Cheerssom/LingTouchCompanion/hardware/models/3mf/Handle_TwistKey_2026-10-27/README.md

# 拧扣榫测试块（2026-10-27）

> **10/28 新增：扣的咔哒测试** → [Key_Detent_Test.3mf](Key_Detent_Test.3mf)，说明见文末“扣的咔哒测试”。

按前榫的真实尺寸做的一小块，用来先试手感，还不是手柄。

## 怎么锁

- 榫：还是现在那种沙漏截面（宽 4.45、腰 2.85、高 7.0），横着插在托盘和盖子各挖一半的槽里。
- 槽只从一侧开口，另一头在壳里封死，所以榫只能从开口那侧插进去，插到底就停住。
- 扣：一片扁的小件。把它竖着从开口插进去，用指甲或硬币边拧 90°。拧完以后扣里面那一横卡在口的后面，往外拔不出来；扣的里面顶着榫，榫也退不出来。
- 拆：把扣拧回竖着，扣就能拿出来；手柄一歪，榫就从开口滑出来。

示意见 [tenon_test_preview.png](tenon_test_preview.png)。

## 打印件

[Tenon_Test.3mf](Tenon_Test.3mf) 里一共 6 件，已经按打印姿态摆好：

| 件 | 姿态 |
|---|---|
| 托盘块 | 底面贴床 |
| 前盖块 | 顶面贴床 |
| 榫（间隙 0.2） | 宽平面贴床 |
| 榫（间隙 0.1） | 宽平面贴床 |
| 扣 ×2 | 平放，其中一个是备用 |

按拓竹默认 30° 规则做了几何检查：6 件都没有需要支撑的朝下面。这里没有拓竹，没真切过。

## 要试的

1. 扣插进去、拧 90°、再拧回来拿出来，顺不顺。
2. 锁住以后歪、甩、推榫两头，榫和扣会不会出来。
3. 两根榫哪根手感好。间隙 0.2 那根，盖子能往上晃大约 0.9 mm；0.1 那根大约 0.45 mm。晃动大小跟会不会滑出来已经没关系，可以只按手感挑。

## 已知限制

- 扣很小：8.4 × 4.1 × 2.4 mm。拧的那一条比侧面低 0.8 mm，免得手指蹭到把它带着转。
- 测试块沿杖方向做了 12 mm 宽，真手柄前榫那块只有 7.65 mm，而扣转动要占 7.5 mm。装进真手柄前面那块会很挤，需要让出 1–2 mm，具体怎么让，等试完再定。
- 没有实打；锁住以后长期敲地扣会不会自己慢慢转开，要实测。

## 检查

`python -B tenon_test.py` 会重新生成 3MF，并把检查结果写进 [tenon_test_check.json](tenon_test_check.json)。检查内容：

- 装配后各件不重叠；
- 榫能从开口一路插到底；
- 扣竖着能插进去，在里面能转满 90°；
- 锁住后扣往外拔会撞到口、榫往外退会撞到扣、榫往里推会撞到封死的那头；
- 盖子往上抬会被榫卡住。

## 扣的咔哒测试（2026-10-28）

10/27 测试块打出来：0.1 那根榫挺紧、能用；扣有点晃，而且一碰就转。这次只解决“一碰就转”。

- 扣：外面那一条两头底下各加一道小凸棱；里面一横和外面一条之间刚好夹住口（多留 0.05），前后不再窜；里面一横加厚到 1.5。
- 托盘块、盖子块：圆坑底开 4 个浅槽（深 0.20），在“锁住”和“竖着”两个位置。壳上只挖槽，不加凸起。
- 拧的时候凸棱压在坑底，扣外面那条两头被顶起一点，转到下一个位置落进槽里，咔一下停住。

示意见 [key_detent_preview.png](key_detent_preview.png)。

[Key_Detent_Test.3mf](Key_Detent_Test.3mf) 4 件，已按打印姿态摆好：

| 件 | 姿态 |
|---|---|
| 托盘块（带浅槽） | 底面贴床 |
| 前盖块（带浅槽） | 顶面贴床 |
| 扣，凸棱高 0.10 | 平放 |
| 扣，凸棱高 0.15 | 平放 |

榫用 10/27 已经打好的间隙 0.1 那根，不用重打。

要试的：两个扣各拧几次，锁住位置有没有咔一下停住、拧起来费不费劲、凸棱会不会磨平或者扣会不会裂。

检查（`python -B key_detent_test.py` 重新生成，结果在 [key_detent_check.json](key_detent_check.json)）：

- 扣在锁住和竖着两个位置都不碰壳和榫；竖着能插进去；去掉凸棱算，扣能转满 90°；
- 从 5° 到 85°，凸棱要把扣两头顶起 0.10 / 0.15，0° 和 90° 落回去；
- 锁住后扣拔不出来、榫退不出来；
- 按 30° 规则，4 件都没有需要支撑的朝下面（拓竹没真切过）。

估算，不是实测：把扣外面那条当悬臂粗算，顶起时变形约 2%（0.10）和 3%（0.15），按 PLA 估。0.1 mm 这个量级跟打印误差差不多，手感只能打出来试。
