Cheerssom/LingTouchCompanion/docs/REPORT_2026-10-28.md

# 报告：仓库按人重构 + 端侧工程骨架（2026-10-28）

分支 `claude/trusting-brown-h7384r`，基于交接提交 `567b1be`。依据 [HANDOFF_2026-10-28.md](plans/HANDOFF_2026-10-28.md) 和 Hsinlung 对开工前分析的答复。下文把**实测/运行结果**、**计算**、**推断**分开写；“通过”只指真的跑过。

## 1. 提交列表

| 提交 | 内容 |
|---|---|
| `d9cdf4e` | 按人重构，只做 `git mv`：316 个文件全部是 100% 相同内容的重命名 |
| `446386c` | 只修引用：README 相对链接（含 archive 里的）、Python 定位仓库根（`LINGTOUCH_ROOT` 优先，否则向上找 `.git`）、`archive/vision` 的数据目录、`.gitignore` 新旧路径都保留 |
| `3b88ac0` | 交接文档更正：鸿蒙等时传输要求 API 18 / 5.1.0(18)，不是 16 |
| `4c9b306` | 本机迁移 PowerShell 脚本 `docs/migrate_local_2026-10-28.ps1` |
| `43ad9ec` | C++17 核心骨架（core、perception/native、agent/native）与主机测试 |
| `2146edb` | 安卓外壳进行中（停下来换模型时为防容器回收先提交）：libusb、libusb 取流、JNI、Kotlin 主体 |
| `2356e43` | 安卓外壳收尾：Gradle、Manifest、资源、README；修正一个空值判断 bug |
| `1faf0ac` | 鸿蒙外壳：ArkTS、Node-API、usbSubmitTransfer 与备选 fd+libusb、BLE、长时任务 |
| `4386a91` | 真机验收支持：栅格摘要、保存当前帧、核对帧文件 |
| `c466c7b` | 文档：README、CLAUDE.md、真机验收清单、各文件夹 README |
| （本提交） | 本报告 |

## 2. 任务 A：按人重构

布局按交接的表执行，几处解释（开工前已说明、Hsinlung 同意）：

- `hardware/models/` 下保留 `3mf/`、`BrailleModule/`、`BrailleModule_Video/` 三个同级目录，内容一个字节没改。理由：`BrailleModule_Video/ArrayPreview` 用 `../../3mf/…` 和 `parents[1]/'3mf'` 引用 3mf，`3mf/README.md` 要求“Keep this folder together”。因此 `hardware/models/` 就相当于原来的仓库根：各模型 README 里的命令在这里执行照旧有效。
- PCB 放在 `hardware/pcb/PCB_REDESIGN_2026-10-08/`，保留带日期的目录名，新板以后可以并列。
- 旧 CLAUDE.md 归档为 `archive/CLAUDE_2026-10-09.md`：Claude Code 会自动加载子目录里的 CLAUDE.md，保留原名会让过期的 10/09 指令在 archive/ 里继续生效。
- 历史记录正文里的旧路径不改：交接本身（只按要求改了 API 版本）、`pcb_v2_revision.md`、3mf 内部文档、`archive/CLAUDE_2026-10-09.md`。
- 3mf 里有两类问题是移动前就有的，原样保留：断链（`../../Handle/Coaxial_v1/README.md`、`build.py:255` 这类带行号的链接），以及 `PCB_PREPOWER_REVIEW_2026-10-07.md` 里指向 `C:/Users/Hsinlung/Desktop/LingTouchCompanion/firmware/…` 的绝对路径。合并后这个绝对路径会指向旧位置。

**本机被忽略的文件不会跟着合并移动。** 例如 `3mf/.runtime/`、`geometry/checks/views`、`BrailleModule_Video/Archives/`、`app/backend/.env` 与 `node_modules/`、实验服务的证书、`data/` 等。处理分两部分：
- 迁移脚本按移动表逐项挪：只移动，缺的跳过，不删除，不覆盖，每一步都打印，支持 `-DryRun`。
- `.pcba-workflow/` 留在仓库根，脚本在 `hardware/models/` 下用 `mklink /J` 建目录联接。原因是 `Handle_NewPCB_2026-10-20` 的 `build.py`、`measure_sources.py` 用 `parents[1]` 找它，而 3mf 里的代码不能改。

`.gitignore` 同时保留旧路径，免得残留的运行时显示为未跟踪而被误提交。

## 3. 任务 B：端侧骨架

### 3.1 core/（大家共用）

- `types.h`：深度帧（帧号、单调时钟时间戳、内参版本）、9×6 栅格（0/1/2，每格诊断：高度带点数、地面点数、看到地面的 10 cm 小块数）、地面估计、各阶段像素数。行号约定与 `frame_converter.py` 一致：row 0 最远。
- `modules.h`：按视觉方案第 9 节命名的接口：SensorAdapter、Registration、GroundPose、GeometryGrid、RGBInstance、SpatialLMService、EvidenceFusion、OutputAdapter / TactileEncoder。`inference.h`：InferenceBackend（鸿蒙 MindSpore Lite、安卓 ONNX Runtime）和 LanguageModel（llama.cpp）。未实现的只有接口，没有假实现。
- `tactile.h`：旧板编码。9×6 放进 10×9 的最近 6 行，其余 4 行全平。
  - 状态 2 用 `UnknownCellPolicy` 显式传入，没有默认值；数值 0 非法，防止零初始化时悄悄选中一种。
  - 左右镜像、ROT180 都是显式参数，默认沿用现有行为（都为 true）。
- `config/lingtouch_defaults.conf`：全部门槛的唯一来源，编译时原样嵌入，两个平台共用。`tactile.unknown_cell_policy` 留空，注明“待 Hsinlung 定”。
- `engine.h`：给外壳的门面，包括启动表、IN 响应、按批收包、后台线程算栅格（只保留最新一帧）、编码、存帧和核对帧文件。没有帧或没有内参时拒绝编码。
- `report_json.h`：两端共用的栅格/统计 JSON 和栅格摘要。

### 3.2 perception/native/（视觉同学）

- **启动表**：由 `tools/gen_startup_sequence.py` 从 `startup_sequence.json` 生成，不手抄。共 41 条控制请求、2 次切换接口、1 次挂等时传输。0xa700 之后的 270 ms 等待不在 JSON 里，由脚本按 REPORT 第 9 步加上。
- **执行顺序**：JSON 的第 0 步（GET_CUR 0xcb00）排在“接口 0 设 alt 0”之前。执行时先 claim 接口 0，再严格按表走。
- **拆帧器**：与 `independent_proof.py` 的 `packet()/finish()` 逻辑一致，处理 UVC 头、FID 翻转、EOF、ERR、空包、超长。
- **标定解码**：无 schema。字段含义和依据见 §6。
- **几何**：
  - 去畸变查表；
  - 依次过滤：无效值（0、恰为 1、<100 mm、>5 m、超出畸变可逆范围）→ 疑似相位绕回的孤立近点 → 边缘飞点（默认偏松）；
  - 反投影：光轴 Z / 径向可切换（`depth.meaning`），去畸变可开关（`depth.undistort`），深度图镜像可开关（`depth.image_mirrored`）；
  - 地面拟合：RANSAC + 最小二乘（Jacobi）。质量检查包括内点数、前向铺开长度，以及“低于平面的点占比”（防止把桌面当地面），失败时整张为 2；
  - 0/1/2：先按 10 cm 小块取整再推出格子；1 优先于 0；0 要求 16 个小块都有地面点且高度带内无点（缺几块、带内允许几个点都是参数）。
- **平面检查**：中央区域对四种假设（Z/径向 × 去/不去畸变）各做最小二乘平面，比较残差。
- **确定性**：两个平台要对同一帧算出相同结果，所以 `-ffp-contract=off`、不用 fast-math，判决只用加减乘除和 sqrt，随机数用自带的 SplitMix64。
- **cs30_libusb**（安卓用，可选目标）：
  - 用 `LIBUSB_OPTION_NO_DEVICE_DISCOVERY` + `libusb_wrap_sys_device` 包住 fd，claim 时自动 detach 内核驱动；
  - 挂 10 个传输，每个 32 个微帧 × 3072 字节，超时 5000 ms；控制请求超时 15 s；
  - 停流顺序：取消并排空（每轮重新取消）→ 接口 1 设 alt 0 → 接口 0 设 alt 0 → release；
  - 停流时若还有传输没回来，不释放缓冲，并拒绝重开；另有 `reset_device()`。
- **third_party/libusb**：上游 1.0.29（LGPL-2.1）Linux/Android 后端原样摘取，压缩包 SHA-256 记在 `README.lingtouch.md`。编成独立的 `libusb-1.0.so`，不静态链接。

### 3.3 agent/native/（对话 agent 同学）

只有接口：语音识别/合成（计划用 sherpa-onnx）和 agent。语言模型接口放在 core，因为 SpatialLM 和 agent 共用。

### 3.4 apps/android/（交互同学）

Kotlin，不依赖 AndroidX。AGP 8.7.3 / Kotlin 2.0.21 / Gradle 8.11.1，minSdk 29、targetSdk 35，只编 arm64-v8a。

- MainActivity 的流程：申请 CAMERA（安卓 9 起 UVC 授权需要）→ USB 授权（PendingIntent 显式包名 + FLAG_MUTABLE，接收器 NOT_EXPORTED）→ 后台线程开流 → 每 200 ms 刷新。
- 栅格每行有读屏文字。没连设备显示“未连接”，帧率只用实测帧数算。状态 2 不预选、必须手选。
- 另有：持续发送、平面检查、存帧/核对帧文件、复位相机。
- StreamService 是 connectedDevice 前台服务，开流期间持有 `PARTIAL_WAKE_LOCK`。HandleLink 的 BLE 流程与比赛版相同，FFE3 订阅成功后才允许写帧。

### 3.5 apps/harmony/（交互同学）

ArkTS Stage 模型，`compatibleSdkVersion = targetSdkVersion = 5.1.0(18)`。

- **主路径**：usbManager 执行启动表，接口 1 切到 alt 1 后立刻挂 10 个 `usbSubmitTransfer`。每个回调把 32 个微帧打成一批，调一次 `pushIsoTransfer`，不是每包一次跨层调用。
- **备选路径**：`getFileDescriptor` → `openFd` → native libusb。CMake 开关 `LINGTOUCH_HARMONY_LIBUSB` 可以关掉。
- **BLE**：取自比赛版，改成回调对象，并且不跳过相同帧（后台持续发送测试要看到每次刷新）。
- **后台保活**：长时任务 bluetoothInteraction + location，module.json5 里已声明。
- 界面功能与安卓相同。

## 4. 跑过的测试与结果（云端，全部是主机上的运行结果）

| 项目 | 结果 |
|---|---|
| Python `py_compile`（仓库里全部 73 个 .py，含新增的生成脚本和比对脚本） | 通过 |
| `--help`：phone_server、alert_server、depth_server、evaluate_obstacle_scenes、topdown_pipeline、archive/vision/main | 通过（装了 CPU 可用的 torch 等依赖，在临时虚拟环境里） |
| `frame_converter.py` 自检 | 通过 |
| validate_distance / check_balloon_depth / prep_new_pics | **未运行**（需要本机 `pics/`）。在 `/tmp` 下启动时报错路径为 `<仓库根>/pics/…`，说明已按仓库根解析、不依赖当前目录 |
| Node 后端（`agent/backend` 的临时副本） | `npm ci` 后启动，`GET /` 和 `POST /api/assistant/parse-command` 正常。注意：`package-lock.json` 的 resolved 地址是 `registry.npmmirror.com`，云端要加 `--registry=https://registry.npmjs.org/ --replace-registry-host=always`（未改仓库） |
| 核心主机测试（gcc 13，RelWithDebInfo） | 11/11 通过 |
| 同上，clang 18 加 `-Wshadow -Wconversion` | 11/11 通过，零警告（修掉了测试里一个未用常量） |
| 同上，ASan + UBSan | 11/11 通过 |
| `test_engine` 在 TSan 下连跑 3 次 | 通过，无数据竞争报告 |
| 安卓 native（主机编译器 + JDK 的 `jni.h`） | `liblingtouch_jni.so`（17 个 JNI 导出）与 `libusb-1.0.so` 编译、链接通过。JNI 库动态依赖 libusb，内部不含 libusb 符号 |
| 安卓 Kotlin | 在临时 JVM 工程里以 Robolectric `android-all:14`（API 34 框架类）为编译依赖，全部 `.kt` 编译通过、零警告。这一步抓到并修了一个 bug：发送成功会被误报为“服务还没启动” |
| 安卓 Gradle | `gradle help` 停在解析 AGP：`google()` 仓库 dl.google.com 在云端不可达。**未编 APK** |
| 鸿蒙 NAPI 胶水 | 以 Node-API 头文件做语法检查（开、关 libusb 两种）通过；编成 Node 插件后 `apps/harmony/tools/napi_host_test.js` 通过 |
| 鸿蒙 ArkTS | **未编译**（云端没有鸿蒙 SDK / ArkTS 编译器） |
| PowerShell 迁移脚本 | **未运行**（云端没有 PowerShell，下载 pwsh 可执行文件被会话权限拒绝），只做了人工检查（含 PowerShell 5.1 兼容、避免中文弯引号被当成字符串定界符） |
| 建模脚本（`3mf/regenerate.py` 等） | **未运行**（依赖本机运行时），只做了 py_compile |

各主机测试的具体内容：
- `test_tactile_legacy`：与 `frame_converter.py` 生成的 1408 条向量逐字节对比，不一致 0 条。584 条是纯打包（ROT180 与 PROD），824 条是“9×6→旧板→镜像→打包”全链路（平/凸 × 镜像开关 × ROT180 开关）。另有：显式策略、远处 4 行全平。另一项测试 `legacy_vectors_up_to_date` 每次重新生成向量，检查与已提交的一致。
- `test_config`：默认参数覆盖所有键；输出再读回一致；未知键、缺键、重复键、格式错误、逗号小数都报错。
- `test_uvc_assembler`：合成包流覆盖 EOF、无 EOF 靠 FID 翻转结束、帧中 ERR、只有头的包、开流空图、坏头三种、丢一个包、多一个包（超长）、按 32 槽位打包的传输（含空微帧、状态非 0、描述越界）。
- `test_cs30_protocol`：启动表与 REPORT 逐项一致（Commit 数据等于 Probe 返回的 26 字节、帧大小字段 614400、0xa100 的 640/480/02、alt 1 后立刻挂传输、0xa300 = 37 01）；标定分片倒序喂入也能拼回 763 字节原样；坏分片报错。
- `test_calibration`、`test_depth_geometry`：见 §6。
- `test_geometry_synthetic`：用 CS30 解出的内参（含真实畸变）渲染合成场景。
  - 地面 + 0.3×0.3×0.5 m 箱子（相机高 1.5 m、俯仰 30°），按光轴 Z 和径向各渲染一遍：箱子格 = 1，身后被挡 = 2，看全地板 = 0；拟合出的离地高度 1.500 m、俯仰 30.00°。
  - 高 1.7 m、俯仰 40°、横滚 6°：高度 1.700、俯仰 40.00、|横滚| 6.00。
  - 直径 3 cm 的细杆在默认参数下 = 1。
  - 5 cm 扁盒和悬在 2.0–2.2 m 的板都不判 1。
  - 看不到地面时降级，整张为 2。
  - 平面检查见 §6。
- `test_reference_frames`：3 张真实参考帧输出确定（新建流水线、复用流水线、倒序处理都一致）。三帧都是地面拟合失败、整张 2：000 帧地面内点 325 个，少于 500；020、040 帧没有符合条件的平面。这是近场数据，预期如此。
- `test_engine`：合成等时包流 → 后台算出的栅格与直接计算一致；拆帧逐字节还原；存帧、核对帧文件的摘要一致；第二帧 FID 翻转后共 2 帧，没有不完整帧。主机上一帧计算 6–12 ms（x86，不代表手机）。

## 5. 没有验证的（按要紧程度）

1. 所有真机项目，见 [device_tests.md](device_tests.md)。包括：
   - 两个平台能否从 CS30 收到帧；
   - 鸿蒙 `usbSubmitTransfer` 的实际行为（buffer 是否装数据、`isoPacketDescs` 是否齐全、`SHORT_NOT_OK` 对等时短包的影响、alt 设置的接口描述）；
   - 备选 fd + libusb 路径在鸿蒙上能否用；
   - 帧率与丢包；
   - 息屏 10 分钟；
   - 手柄手摸方向；
   - 两边摘要是否一致（主机上同一平台确定，ARM 上两个工具链之间还没比过）。
2. 安卓 APK 没编（AGP 解析不了），资源合并、Manifest 合并、NDK 交叉编译都没跑过；鸿蒙工程完全没编，ArkTS 只按语法规范人工检查。第一次本地编译很可能要修一些小问题。
3. libusb 的 Linux 后端在鸿蒙 NDK（musl）下能否编过，没试。
4. 深度含义（Z/径向）、片上是否已去畸变、深度图是否镜像：**未确认**，都做成了参数。
5. 门槛取值（地面内点 500、内点距离 3 cm、障碍点 5 个等）都是初版，没有真实地面数据检验过。参考帧是近场数据，提供不了这类证据。
6. 手机上的计算耗时、内存（每帧约 15 MB 工作内存）没测。
7. 迁移脚本没运行过。

## 6. 标定与深度含义（实测、计算、推断分开）

- **实测（读文件）**：两份 blob 都是 763 字节，只差 5 个字节，全在字段 1 的 4 个 float 里。blob 0 字段 1 = 364.875 / 364.778 / 324.416 / 231.051；blob 1 正好是一半（浮点指数减一）。字段 2 = −0.316446、0.140359、−0.000302、−0.000482、−0.034901。字段 11 = `HV0130315L0294`。
- **推断**：字段 1 是 640×480 的深度内参 fx fy cx cy，字段 2 是 OpenCV 顺序的 k1 k2 p1 p2 k3；blob 1 对应 320×240；字段 15–17 像是 RGB 内参与畸变（931.03 / 930.71 / 976.96 / 554.82…）、RGB←深度的旋转（接近单位阵）和平移（约 −43.9，推断单位毫米）。代码里内参版本号带 `:inferred`。
- **计算**：按上述含义，横向视场约 100.2°，与规格书的约 100° 一致；纵向约 75.0°。径向畸变函数在未畸变半径约 1.40 处到顶，所以图像四角约 6.58% 的像素超出可逆范围。查表把这些像素标为无效，查表回投最大误差 1.1e−5 像素。
- **交接里“解不出就用规格书视场推临时内参”这一条没有实现。** 解码成功，用不上；而且这颗镜头桶形畸变很强，按 100° 推的针孔焦距约 268 px，比解出的 365 px 小约 26%，会比没有更误导。换真标定的入口是 `Engine::set_intrinsics`（或改解码）。
- **深度是光轴 Z 还是径向：未确认。** 材料里找不到依据。参考帧是近场数据，判断不了（四种假设残差都只有 4–5 mm，而且拟合到的“平面”离相机约 1 cm，没有意义）。合成测试表明平面检查能区分：
  - 正对墙时，对的假设残差 0.0–0.3 mm，含义错了 57–82 mm；
  - **但正对墙时光轴 Z 深度在整面墙上是常数，去不去畸变墙都一样平**，所以要判断去畸变，得斜着拍一个平面。俯仰 45° 看地面时，对的 0.2 mm，不去畸变 8.7–13.5 mm。
  - 据此把真机清单的平面检查写成两步。

## 7. 我改动或补充“Claude 判断的”地方及理由

1. **鸿蒙 API 16 → 18。** OpenHarmony usbManager 文档把 `usbSubmitTransfer` 等标为 18+，Hsinlung 已确认，交接文档也改了。
2. **核心“无平台依赖”与“核心用 libusb”的处理。** libusb 取流放在 `perception/native/cs30_libusb`，是单独的可选目标，只有安卓（以及鸿蒙备选路径、桌面 Linux 检查）链接；核心本身不依赖它。
3. **接口归属。** 语言模型接口放 core（SpatialLM 与 agent 共用），语音和 agent 接口放 `agent/native`。
4. **规格书临时内参没有实现**，理由见 §6。
5. **新增 `depth.undistort`、`depth.image_mirrored` 两个参数**，以及畸变不可逆像素标无效。片上是否去畸变、图像是否镜像都未确认。
6. **左右镜像做成显式参数，默认开**（Hsinlung 已同意）。
7. **地面拟合加了“低于平面的点占比”检查**（默认 >5% 就判失败）。没有它，桌面占多数时会把桌面当地面，宁可降级成 2。
8. **0 的规则里“高度带内无点”** 用 `grid.free_max_band_points = 0` 实现，可调。带内有点但不到 1 的门槛时，判 2。附带观察：默认参数下 5 cm 以内的扁平物体（地面容差 5 cm）会被当成地面点。
9. **真机清单第 1 条的方法改了。** 手机上不能跑厂家 SDK，做不到“同一次曝光哈希一致”，改为先后两次曝光比对（`compare_frames.py`，参考值用 REPORT 的中位数约 3 mm、P95 约 12 mm）。为此给两个 App 加了“保存当前帧”。
10. **第 3 条**加了栅格摘要和“核对帧文件”，电脑、安卓、鸿蒙三边可以直接比对。
11. **第 2 条**补了依据：OpenHarmony USB DDK 文档里 `OH_Usb_SendPipeRequest` 只写了中断和批量传输；按 Hsinlung 的要求加了备选路径 getFileDescriptor + libusb，与 usbSubmitTransfer 一起测。
12. **安卓前台服务外加 `PARTIAL_WAKE_LOCK`。** 只有前台服务时，息屏后 CPU 可能休眠，息屏 10 分钟那条测试就会失败。
13. **鸿蒙 HandleLink 不再跳过与上一帧相同的帧**（比赛版会跳过），否则静止场景下后台持续发送测试看不到刷新。
14. **没数据时不发帧。** 没有帧或没有内参时，`encode_legacy` 拒绝编码。地面拟合失败（降级、整张 2）时照常按状态 2 的策略编码。

## 8. 给 Hsinlung 的待办

- 按 [device_tests.md](device_tests.md) 测。最要紧的是两个平台能否收到帧，以及鸿蒙 `usbSubmitTransfer` 的实际表现。
- 定下状态 2 的触点表示，写进 `tactile.unknown_cell_policy`。
- 平面检查后，定 `depth.meaning`、`depth.undistort`；手摸后确认两个镜像开关。
- 合并后先运行一次迁移脚本（建议先 `-DryRun`）。
