Cheerssom/LingTouchCompanion/hardware/models/3mf/Shell_Lessons_C.md

# 灵触盲杖手柄外壳：需求和踩过的问题

整理日期：2026-10-20。下一版外壳开始前先读这份。

只整理手柄，不整理头戴件。本次独立查阅原文件、脚本和相关对话，没有读取其他 `Shell_Lessons*` 文件，也没有改模型或脚本。下文的“现版”指 `Handle_NewPCB_2026-10-20/` 当前文件，不把当天已覆盖的初稿算成现版。共 **22 条需求、26 条问题**；问题包括实物反馈、数字模型错误和明确标注的设计风险，不代表每版都打印失败。

## 一、需求

### 出处怎么找

下面用短编号引用会话。日期按北京时间；原记录时间为 UTC，可加 8 小时对照。行号是 JSONL 的物理行号，便于定位，不是模型行号。

| 编号 | 会话文件与主要位置 |
|---|---|
| C06 | Codex，`C:/Users/Hsinlung/.codex/sessions/2026/10/06/rollout-2026-10-06T15-11-36-01a1100d-b3ce-7cb1-ba40-92719f7f7db2.jsonl`；324、670、765、800 行附近 |
| C10 | Codex，`C:/Users/Hsinlung/.codex/sessions/2026/10/10/rollout-2026-10-10T15-34-50-01a124bc-6926-7e90-9692-aaf5f19914bd.jsonl`；308、388 行附近 |
| C11 | Codex，`C:/Users/Hsinlung/.codex/sessions/2026/10/11/rollout-2026-10-11T08-58-02-01a12877-7e93-7700-871b-f17e72df417c.jsonl`；194、355、406、1011、1455–1623、2429–2438 行附近 |
| L11 | Claude Code，`C:/Users/Hsinlung/.claude/projects/c--Users-Hsinlung-Desktop-LingTouchCompanion/d46657c2-4c7f-457c-a345-b00e85217a57.jsonl`；543 行为审查结果，549 行为本人回答，621–627 行为优化方向与授权，1186 行为 v1 交付说明 |
| C20 | Codex，`C:/Users/Hsinlung/.codex/sessions/2026/10/20/rollout-2026-10-20T17-35-25-01a158aa-68ae-7cc2-8c3e-8cf0d84e78cf.jsonl`；10 行为完整任务，807 行为看过初稿后的修改要求 |
| S20 | Codex，`C:/Users/Hsinlung/.codex/sessions/2026/10/20/rollout-2026-10-20T17-13-02-01a15895-e85c-7b50-b5a2-3c551eadd32c.jsonl`；10 行为充电宝筛选任务 |
| U20 | Hsinlung 本次整理任务原文，2026-10-20；这是今天新增两项要求的直接出处 |

以下引号内是本人消息原文。长任务中已有的要求可以作为需求来源；AI 的交付汇报、提案和参数不因此成为本人认可的设计。

### 仍要遵守的要求，以及已被替换的旧要求

| 编号 | 需求，及适用范围 | 本人出处 / 原话 | 后来的变化与边界 |
|---|---|---|---|
| R01 | 手握的地方尽量窄、小；先判断手怎么放，再定外形。其他位置可以更宽。 | C06 10/6：“手柄需要尽量小一点”；C11 10/11：“盲人朋友体验的时候感觉手握的地方有点太宽了”；“只有握持的地方做窄点就行，别的地方就做宽点也可以啊，你先想下手到底应该咋放的”。U20 再次要求“手握持的部分要尽量窄”。 | 没有本人规定的统一最大宽度或周长；不能把 AI 自选的 32/34/41 mm 当验收线，也不能只报某一条窄腰宽度就说好握。 |
| R02 | 用右手握，大拇指感知点阵。手模至少要先摆对左右和握法。 | C10 10/10：“右手握住大拇指感知”；C11 10/11 要求找可活动手模、“先按比例做一个成人手即可”，并多次指出成品是左手。 | 成人手是姿势参考，不等于真人舒适度通过；手长 180、掌宽 78 是 AI 选的参考值。 |
| R03 | 同轴直柄，杖口和柄同轴。 | L11 10/11 549 行：“1.同轴的吧”；C20 10/20：“同轴直柄盲杖手柄”。 | C11 曾授权自由探索外形；这不等于后来仍可沿用 L/T 形。L11 和 C20 已明确选直柄。 |
| R04 | 杖口内孔沿用原手柄。 | C20：“杖口内孔沿用原手柄……事实见……VERIFIED_FACTS.md”。 | 原孔径经文件核对为 Ø25 mm；沿用内孔不等于必须沿用原来 1.5 mm 薄壁、无止挡的全部结构。 |
| R05 | 尾端封口。 | L11 问原敞口是否有意，549 行回答“没有，是随便做的”；C20 明写“尾端封口”。 | 原模型敞口不能再当成必须保留的功能。 |
| R06 | 尾部要帮助握住、防止滑脱；外形不能只照抄装饰。 | C10：“尾端是方便握持（类似卡住）”。 | 没有本人确认的止挡坐标。Coaxial_v1 把止挡前移到掌根附近是 AI 的具体方案；10/20 尾部加宽是否实际有此作用，查不到真人验证。 |
| R07 | 外壳适配既定 PCB，不为壳改板或凭旧板尺寸画新壳。 | C06：“pcb文件的模型肯定不能改了”；C11：“先保留现有 PCB，重做外形与内部摆放”；C20 指定 PCB1_2。 | PCB1_5 不改是当时条件。现在已有新板 PCB1_2，旧板长宽、15 模组和旧电池腔均不能自动继承。 |
| R08 | 板和模组位置按真实焊盘、孔定位，不能按借来的占位模型。 | C20“已知问题，别重犯”：明确指出旧方案横向偏 2.75 mm，要求“板子和模组的位置必须按 PCB 自己的焊盘/孔定位”。 | 这是从真实错误提炼、后来本人明确下达的要求。 |
| R09 | 新版 9 个模组组成的 3×3 主阵列开一个窗，U48 另开一个窗，U48 要用。 | C20 第 2 条原文。 | 替换旧 PCB1_5 的 15 模组、三条长窗口方案；不能把历史 U48 可选状态带进来。 |
| R10 | 模组固定顶面与盖面齐平。 | C20：“模组顶面和盖面齐平（原手柄的做法）”。 | 指固定顶面，不是让升起的触点也齐平。20 mm 本体高不等于插上排母后的总高。 |
| R11 | 模组安装方式按当前板重算。旧版曾先按直接焊接，新版有指定排母。 | L11：“先考虑直接焊死，另外，板子高度现在不用细究”；C20 指定 HX PM1.27-1x6P 排母及其对位记录。 | “直接焊死”是旧板阶段要求，已由新板的插装条件取代。不能直接照 Coaxial_v1 的板高。 |
| R12 | 不再用原来的长滑槽；可用简单凸起、凹陷插接，但不能卡死。 | C10：“不用长凹槽用简单的凸起凹陷的榫卯结构固定也行”；C11：“也不需要滑槽了，间距太小，类似榫卯结构插进去就行”；“只要你别直接卡死就行”。 | 是连接偏好及装配要求，不是强制只用木工榫或禁止螺钉。C20 把分件、连接、内部固定交给 AI 决定，但明确不能重犯零间隙薄槽。 |
| R13 | 两节 18650、保护板、无电池盒、PCB 位于电池上方，是旧版要求，现已被外置成品充电宝方案取代。 | C10 308、388 行本人确认；S20 明说新板“没有电池”；C20 指定壳内 PB503。 | 旧电池位置也不是永久固定，C11 已说“电池的位置其实也可以改”。现在不能为原电芯和保护板继续撑大手柄。 |
| R14 | 当前壳内放绿联 PB503；供电用自带 C 公头直接插 J1，不成立才用尽可能短的现成 PD、3A 公对母延长线。 | C20 初始第 3 条与 807 行第 2 条。 | 初始允许直插或短 C-C 线；后来的明确修改取代这个自由选择。25 cm 双弯头线及回环已被否决。未见本人确认改用后来查询的其他充电宝。 |
| R15 | 充电宝不要放在手握处；J1 在板子最后，充电宝只能接在板后。 | U20 本人今日新增要求原文。 | 这要求同时约束握位与供电排列。不是只要 PB 在板后，就能自动证明手不会握到 PB 段。 |
| R16 | PB 电源键壳外可按，演示前能长按 3 秒；侧 C 母口壳外可充电，不拆壳、不拔供电头，开口平齐。 | C20 初始第 3 条；807 行第 2 条明确取消护罩和“拔线再充”。 | 操作口要容得下实际手指/线头并有操作行程；当前按键和接口位置仍是待核尺寸。 |
| R17 | 新板 SW1、SW2 都要能从壳外操作。 | C20 第 4 条。 | C10 曾说“轻触开关现在没用，放着就行”；新板任务已明确替换为可操作，不能继续按无用途封住。 |
| R18 | 触觉面不许有紧固件头和螺母六角窝；所有紧固件底面进出。 | C20 807 行：“拇指就在阵列附近滑动”；“上表面只留主阵列窗、U48 窗、SW1、SW2”。 | 这是看过初稿后新增的硬要求，不是初稿已满足的条件。 |
| R19 | ESP 用 8.5 mm 排母上的 IPEX 外接天线版；留 FPC 天线贴位，离模组和大铜面远；烧程序可以开盖。 | C20 第 5 条。 | 板载天线版尺寸图仅作外形参考，不能照搬伸出的天线段；“烧写必须壳外插 USB”不是本人要求。 |
| R20 | H2C、PLA，好打印、支撑少；交付摆好打印姿态的 3MF、装配 3MF、再生成脚本和说明。 | C20 第 6 条及交付清单。 | “3MF 网格有效”不等于 Bambu Studio 已导入、切片或实打通过。 |
| R21 | 整体尽量短小、看起来一体；尾部平顺过渡，报告每段长度；不确定尺寸参数化并列短清单。 | C20 初始目标、尺寸来源及 807 行第 3、4 条：“现在287mm，比原手柄的270还长”。 | 没给新的绝对长度上限；259.705 mm 是 AI 当前结果，不是本人认可的最佳值。 |
| R22 | PCB 上两个安装孔，外壳必须考虑。 | U20：“板上有安装孔，外壳要考虑。10/20版没用这两个孔。” | 这是现行要求。现有资料将新增孔记为 0.6 mm；更早 Claude PCB 会话曾说“两端各一个M2孔”，不能因此把现板孔当成 M2。需要对上最新孔坐标、孔径和固定用途，不能自行改板扩孔，也不能跳过不谈。 |

### 不能冒充本人要求的 AI 方案

下面这些在材料中出现过，但查不到本人逐项确认：沿厚度提盖、两颗/五颗螺钉、M2/M2.5/ST2.9 规格、后挂钩转动合盖、板边托台和压指、泡棉固定 PB、保护板 24×19.5×7.6 mm 占位、0.2/0.35/0.5 mm 通用间隙、特定圆角半径、某个手模尺寸、下壳竖打、窗口负责把模组挤正。出处分别见 [旧提案](Handle/ENCLOSURE_BRIEF.md)、[Redesign 说明](Handle/Redesign/README.txt)、[Coaxial_v1 说明](Handle/Coaxial_v1/README.md)、[10/20 说明](Handle_NewPCB_2026-10-20/README.md)。

其中旧提案本身就写了是讨论稿；Coaxial_v1 没打印、没真人测试，C20 还明确说它“没被认可”。不能因文件名是 README、核对 JSON 写了无碰撞，或本人说了“你看着弄”，就把全部细节升级成已验收事实。

## 二、每版实际出了什么问题

证据强弱在每条里写明。“怎么改”只写查到的改法；没有找到修复或验证就明说。后续为什么漏掉，能由参数看出来的写出来，不能从材料知道的，不猜会话作者想法。

### 原人工手柄：10/6 收到，10/10–11 查明

**P01｜榫和槽完全一样大，没给装配间隙。** C10 本人说“现在对不上”。[ENCLOSURE_BRIEF](Handle/ENCLOSURE_BRIEF.md) 与 [VERIFIED_FACTS](Handle/VERIFIED_FACTS.md) 记录榫厚/伸出 1/2 mm、槽宽/深也为 1/2 mm，两个方向名义间隙均为零。后来 Redesign 改短榫，每侧留 0.25 mm；Coaxial_v1 改搭接止口；10/20 改定位柱和底面螺钉。现版没有再用原零间隙长槽。没有查到各版公差实打结果。

**P02｜槽两边只剩 0.5 mm，边脆弱易掰断。** C10 是本人实物反馈；2 mm 壁中间开 1 mm 槽的测量见同上。后续去掉长槽，经验已用到。不能把零间隙和薄壁说成唯一断裂机理：实际失败件的材料、摆向和断口证据不齐。

**P03｜开关孔和阵列窗口沿长度方向相对错了约 1.79 mm。** L11 543 行通过焊孔与盖板截面对照发现：开关和模组只能对准一边；[VERIFIED_FACTS A](Handle/VERIFIED_FACTS.md) 和 `check_facts.py` 可复核。Coaxial_v1 改为按真实焊盘开窗、对 SW1；10/20 也按新板坐标开孔。不是要求继续给旧窗口整体平移 1.79 mm，新板必须重算。

**P04｜两侧宽窗里的实物模组歪斜，中间较窄窗整齐些。** 这是 L11 543 行对实物照片的观察：两侧 10 mm 窗，中间 9 mm 窗，模组宽 8.2 mm；同一条还报告开关孔边崩边。本次没有把旧照片重新测成新的实物结论。Coaxial_v1 后改 8.9 mm 窗，10/20 改主阵列大窗和独立 U48 窗。不能据此认定“让窗口夹紧模组”是正确固定方法；新板已用排母，歪斜是否消除没有实装证据。后续对话没有查到真实修复验收。

**P05｜原工程上盖斜放 0.9°，顶面没有贴平打印盘。** 见 [VERIFIED_FACTS A](Handle/VERIFIED_FACTS.md)，来自原 3MF 构建变换。后续重新安排摆向；10/20 README 规定触觉平面贴床。查不到这 0.9° 单独造成什么实打缺陷，不能写成已经翘边或打印报废。

**P06｜尾端有约 42×33 mm 敞口，不是有意留的。** 文件切片结果及 L11 本人“没有，是随便做的”相互对应。Coaxial_v1 封尾，给 USB 和 SW2 单独开口；10/20 也封尾，只留尾按杆孔。该经验现版已用。旧敞口不能作为免做操作口的理由。

**P07｜杖孔直通电池腔，没有插入限位。** [VERIFIED_FACTS A](Handle/VERIFIED_FACTS.md)、L11 543 行有证据。原件没有查到修复；10/20 改插深 28 mm，孔底 X=−6，内腔 X=−3.5 起，留下 2.5 mm 实体止挡。数字结构已改，不等于插杖承力验证完成。

**P08｜原始装配没有明确的 PCB 独立托住/固定结构。** L11 543 行审查指出各版没有托住 PCB 的结构；旧提案也把“PCB 独立于盖和电芯支撑”列为要解决的事项。这是历史审查结论，不是本次拆解实物。Coaxial_v1 加板边托台、6 个压指；10/20 加三对托位/压指。基本支撑已考虑，但现版又绕过安装孔，见 P25。

### Codex Redesign、GripStudy、Concepts：10/11

**P09｜PCB 横向放偏 2.75 mm，整套空间结论跟着错。** 对齐用了借来的 12P 排母占位模型中心，不是真实焊孔；`T_PCB` 的 Z=−4.146 等旧摆位不应再用。L11 独立按焊孔查出，[VERIFIED_FACTS A/B](Handle/VERIFIED_FACTS.md) 已记录。本次运行 `check_facts.py` 全部 OK，支持旧错误及原始来源未变。Coaxial_v1 已居中；10/20 也明确按原生焊盘定位，没有证据表明它又偏了 2.75 mm。为什么早期漏掉：把占位模型当了定位基准，这是文件可追溯的直接原因。

**P10｜把板摆正后，34/32 mm 版前端定位榫根部会压住 PCB 边。** L11 454、543 行及 [VERIFIED_FACTS B](Handle/VERIFIED_FACTS.md)。这是 P09 的后果，不能把“旧摆位下无碰撞”当有效装配证明。旧模型没有查到原位修复，后来转到 Coaxial_v1 的另一套连接。10/20 未沿用这个前榫。

**P11｜32 mm 版为 C78/C79 做的单侧鼓包，依据也是错的。** [Redesign README](Handle/Redesign/README.txt) 原写负 Z 两处加宽 1 mm，后在开头加更正；[VERIFIED_FACTS B](Handle/VERIFIED_FACTS.md) 撤回该理由。正确处理是重算真实位置，不能把“留有鼓包”当成经验继续抄。没有证据说 10/20 又给这两颗旧电容留同样鼓包。

**P12｜模组高度关系没有闭合，按直焊时触面会低约 3.6 mm。** L11 543 行发现旧模型为齐平把模组悬在板上；若按本人当时选择直接焊，旧板顶面位置就不对。Coaxial_v1 把板顶设 Y=3.5、模组固定面 Y=23.5。10/20 换插装后用 `MODULE_SEATED_HEIGHT=24.30`，并写待实测；不能把旧直焊 20 mm 直接带入，也不能把 24.30 当已经量过。

**P13｜只把下方收成 34/32 mm，包手的整体仍然很粗。** [Redesign README](Handle/Redesign/README.txt) 明写上部仍宽 46 mm；L11 543 行测外廓仍 46×35.5，周长只从 159.8 降到 153.3 mm，约少 4%。Coaxial_v1 才改成 41.3×32.3、大圆角，周长约128。原因可见：早期局部收窄服从了原来的宽上盖，而没有真正改整个包握截面。10/20 又有类似“前段跟尾部一起保持高度”的参数耦合，见 P26；不能仅凭新宽度较小就算解决。

**P14｜短榫加螺钉后，导孔上方只剩约 0.6 mm 料。** L11 543 行独立审查的数字结果，说明换掉旧长槽后仍可能在新连接根部留下薄处；不是实际已经拧裂。旧版没有找到修复记录。Coaxial_v1 改底面前部自攻孔；10/20 当前前柱径向最薄1.55 mm、孔底至顶面9.17 mm，见其 README。不能只报常规壳壁2.4 mm而省略连接处最薄位置。

**P15｜Redesign 打印文件的壳体开口朝上立放，贴床条件和支撑差。** [VERIFIED_FACTS B](Handle/VERIFIED_FACTS.md) 写约11,700 mm²需支撑，L11 543 行指出只靠弧底接床。原输出没查到重排；Coaxial_v1 另选尾端竖打，仍需支撑和 brim；10/20 改上下壳各自平面朝下。不能把几个版本的“立放”混为同一个已解决方案。

**P16｜左手当右手，用错手模还坚持判断正确。** C11 本人1455、1526、1598行连续指出；1604/1613行 AI 才承认“握柄那版也沿用了这只左手”。[GripStudy README](Handle/GripStudy/README.txt) 确认原始素材是左手，后来把皮肤、指甲和骨架一起镜像。该经验的意义是检查实际成品，不信文件名 `AdultRightHand`。10/20 没有手模/真人验证，不能说又用了左手，也不能说右手握持已经通过。

**P17｜第一轮姿势是掌心铺盖上、拇指横过柄、四指勾边，不是实际握杖。** C11 1011行本人否决，1111行 AI 自述错误并改侧掌包握、拇指沿长轴；后续还有托底和掌面空隙问题。最终 [GripStudy README](Handle/GripStudy/README.txt) 仍说明刚性手皮不模拟压缩、只是规划姿势。后来为什么没变成可靠尺寸约束：手模始终是通用参考，未完成真人握持验收；10/20 又没有建立新的握位证据。

**P18｜自由概念做得过大、过重，窄握把不等于小手柄。** L11 543行对 A/B 报整体约226×200×83 mm、实心塑料约360 g，原件约107 g；[Concepts README](Handle/Concepts/README.txt) 可追构型。本人曾允许探索，不能倒写为“从一开始违反同轴硬要求”；后来 L11 已选同轴，概念不再是实施方向。查不到 A/B 缩成合适产品的版本。

**P19｜概念手和外壳仍有局部穿透。** [Concepts README](Handle/Concepts/README.txt) 明写 A 拇指根重叠约1.46 mm，B 食指根约1.72 mm；C 最后静态全皮检查无重叠。保留为概念局限，没有查到 A/B 消除穿透的最终版。静态拇指触到一块区域，也不证明能扫遍15个模组。不能拿概念手图证明新壳好握。

**P20｜概念只有连通外形，没有落实分件、紧固和完整硬件装配。** [Concepts README](Handle/Concepts/README.txt) 直接排除了打印接缝、强度、最终紧固、保护板、布线、ESP本体及插装保证。它们是概念，不是可打印总装。后续 Coaxial_v1 和10/20才补分件、硬件包络和装配检查。为什么当时未落实：文档本来就限定为探索，不应当作已经解决的前版机械方案。

### Coaxial_v1：10/11

**P21｜杖口仍沿原 Ø25、壁厚1.5 mm，承弯强度没有解决。** [Coaxial_v1 README“未验证”](Handle/Coaxial_v1/README.md) 自己指出“强度偏弱；本版没有改”。这是设计风险，不是查到实物断裂。10/20把前段加厚、孔分成两半，增加止挡和底面紧定，但没有实物受弯验证。保留孔径要求不能变成连原薄壁也必须照搬的理由。

该版还保留保护板尺寸未知、绝缘/接线/固定未定、SW1能否露出待核、配合公差未打小样等边界。它们是未完成项，本文不另凑成“已经出错”条数。v1并非经过本人认可的成熟底稿。

### 10/20 当天初稿与当前版

**P22｜初稿触觉面上有四五个六角窝，妨碍拇指滑动。** C20 807行本人看图与脚本后明确要求改。现版全部紧固件从底面进入，上面只保留四类操作/阵列开口；README与 `models/verification.json`/`motion_verification.json` 记有触觉面检查。已改，不能继续指责现版仍有这几个窝。此前漏掉的是没有把拇指滑动区域变成紧固件禁放位置；这是从修改理由得出的解释。

**P23｜初稿用25 cm双弯头线在板下绕圈，连接段冗长，总长287 mm，比原270 mm还长。** C20 807行本人指出并要求缩短。当前 `PB_X=J1_FACE+PB_PLUG_PROJECTION-PB_PLUG_ENGAGEMENT`，连接段只0.815 mm，杖口段44改34 mm；总长259.705 mm，含尾帽260.305 mm。已改。原公头能否真实直插还没量定，不能因此宣布长度最终锁定；备用短延长线若启用，现有0.815 mm段并不容得下，README已经说明须重排。

**P24｜初稿侧面有外凸护罩，并且存在拔供电线再充电的操作。** C20 807行本人否决。现版改PB自带公头供电，侧母口专充电，壳上16×10 mm平齐口，去护罩，尾部31.705 mm连续加宽过渡。已改。当前充电口距PB侧面约15 mm、线头检查包络≤14×8、轴向20 mm，仍须实际线头可达；数字运动检查不等于实插验收。

**P25｜现版没有使用/落实板上的两个安装孔。** README明确写“PCB用三对板边托位/压指定位，不用新增0.6 mm孔承重”；`build.py` 的板托循环是 `x in [4.0,55.0,132.4]`，接触板边，另加两端挡块，没有与两孔配合的固定。装配板体仍来自未加孔的10/18 STEP；`live-check.md` 确认后来孔层新增两个圆。现版说明了“不用”，但没有满足U20提出的安装孔要求。未改，本次只记录。为什么没用上有直接证据：脚本和说明明确选择板边托/压；是否因为0.6 mm太小而不适合某种螺钉，只能另核，不能据此自行取消要求。

**P26｜现版把尾部PB所需高度带到了整个握持段，没有展示局部收薄的判断。** `build.py` 中 `AXIS` 由 `PB_Z-PB_THICKNESS/2-PB_CLEAR-WALL` 与 `FACE` 算出；`BOTTOM=2*AXIS-FACE`，`tube_envelope()` 从前到尾共用 `BOTTOM/FACE`。结果握持段39.266×39.47 mm，PB尾段56.538×39.47 mm。`models/verification.json` 对应 `bottom_z=-12.966`、`face_z=26.504`。PB位于X136.705以后，板底最深元件下探7.75 mm；仍把PB所需底面延伸到前方，是参数能直接看见的事实。**推断：这延续P13“没有按手和局部硬件收握位”的问题，未充分落实R01。** 不能仅凭这些数保证握位一定能减薄多少：还有同轴杖口、螺柱、SW2和上下壳装配约束，本文没有重建模型求极限，也没查到真人握位。未改，为什么发生可见于共用截面参数；作者为何这样选择查不到。

### 这些教训为什么有的到了10/20还没用上

有证据支持的共同点是：旧版错误有一部分已经进任务，10/20确实避开了零间隙长槽和2.75 mm偏位；握持要求却仍主要停在文字，没有给出“手握哪段、该段每处由什么硬件撑宽/撑高”的核对。P13与P26是这种重复的具体表现，而不是同一个错误尺寸被直接复制。

安装孔的遗漏更直接：来源说明知道新增两孔，实施却明确不依赖孔；没有把这项机械意图带进固定方案。对其他缺口，不能统一归因于“完全没读旧文档”：C20任务已经引用事实清单，现版README也记有 `check_facts.py` 通过。能确认的是哪些要求没落实，不能确认作者实际读了多少、为什么忽略。

git中手柄路径查到的提交主要是 `6f46dfa`（2026-10-08，合并3D来源）；后续这些版本不能靠git提交当作逐版已发布、已打印证据。原始 `Handle_Print.3mf` 与 `inputs/Handle_Original.3mf` 是同一来源的保留，不另算一个修好后的版本。

### 最后对照：10/20当前版还违反什么、还没证明什么

**计数：1条明确未落实（安装孔），另1条推断未充分满足（握持段尽量窄）；重复的旧问题1类（局部收窄没有落实到整个握持截面，推断）。** 不把已改的当天初稿问题混入这两个数。

| 结论 | 对应需求/问题 | 当前具体证据 |
|---|---|---|
| 明确未落实：两孔没有参与固定方案。 | R22 / P25 | [build.py](Handle_NewPCB_2026-10-20/build.py) 的板边托/压指循环及注释；[README](Handle_NewPCB_2026-10-20/README.md) 明说不用0.6 mm孔承重。板体参考仍是旧STEP。没有授权在本文把孔改大或重新画固定件。 |
| 推断未充分满足：握持段跟PB段共用39.47 mm高度，未证明已经尽量收薄，也没有新的右手握位核对。 | R01 / P26；与P13重复同类问题 | `AXIS/BOTTOM/FACE` 和 `tube_envelope()` 共用上下表面；[verification.json](Handle_NewPCB_2026-10-20/models/verification.json) 的握持截面与尾截面高度相等。旧Coaxial_v1为41.3×32.3，但板、模组安装、电源均不同，不能直接用旧32.3判新39.47违规。 |

U20另一条“充电宝在板后、不要放在手握处”：**板后这半条已满足**，板X0–135.89，PB本体X136.705–215.705；握持宽段到X105后开始加宽。**没有查到当前真人或新手模的握持范围，因此“完全不占握位”还不能确认**，也没有证据把它算成明确违反。

其他当前有依据的改善：同轴、Ø25杖孔、尾封口、主阵列与U48分窗、名义齐平、SW1/SW2/PB按键机构、侧充电口、底面紧固和预留FPC位置均已进入模型/参数。不能说10/20把旧经验全部丢了。

但以下仍只有名义包络，没有实物闭环：`MODULE_SEATED_HEIGHT=24.30`、ESP外形、PB公头偏心/7 mm伸出/6 mm插深、侧口和按键位置、0.35 mm定位间隙、0.20 mm壳缝、自攻孔和热熔螺母底孔、握持与承力。现版README已承认Bambu Studio导入/切片没有验证。它们应作为下一版前要核对的未决项，不能捏造成已经发生的干涉、堵口或打印失败，也不能用“无碰撞”把它们一笔带过。
