Cheerssom/LingTouchCompanion/hardware/models/3mf/Shell_Lessons_Trace.md

# 灵触盲杖手柄外壳：以前提过的需求、做错过的地方

整理日期：2026-10-20。下一版外壳开始前先读这份。这里只整理，不改模型，也不替下一版选结构。

共整理 **25 条需求、24 条问题**。需求中有已经被新硬件取代的旧要求；问题中区分实物反馈、数字模型错误和检查缺项，不把它们都说成打印失败。10/20 指的是 `Handle_NewPCB_2026-10-20/` 当前保留的版本；当天第一次生成、后来改掉的版本另写。

本文件独立查证，未读取其他 `Shell_Lessons*` 文件。读了手柄相关文件、下列历史会话和相关 git log。`check_facts.py` 只读复核全部 OK。没有运行会重建模型或写检查结果的 build / verify / render。全局说明提到的 `Desktop/news-game/docs/asset-production-mistakes.md` 在指定位置不存在，未据此补写经验。

## 一、需求

### 出处怎么找

下面用短代号引用，都是实际读到的记录。会话行号是 JSONL 的物理行号，不是聊天楼层。日志时间为 UTC，本文日期按本机 UTC+8 理解。

| 代号 | 记录位置及时间 |
|---|---|
| C06 | Codex，2026-10-06：`C:/Users/Hsinlung/.codex/sessions/2026/10/06/rollout-2026-10-06T15-11-36-01a1100d-b3ce-7cb1-ba40-92719f7f7db2.jsonl`。手柄内容主要在 670–1318 行。 |
| C10 | Codex，2026-10-10《梳理外壳模型各部分功能》：`C:/Users/Hsinlung/.codex/sessions/2026/10/10/rollout-2026-10-10T15-34-50-01a124bc-6926-7e90-9692-aaf5f19914bd.jsonl`。 |
| C11 | Codex，2026-10-11《梳理手柄3D模型现状》：`C:/Users/Hsinlung/.codex/sessions/2026/10/11/rollout-2026-10-11T08-58-02-01a12877-7e93-7700-871b-f17e72df417c.jsonl`。 |
| A11 | Claude Code，2026-10-11《手持件模型预览》：`C:/Users/Hsinlung/.claude/projects/c--Users-Hsinlung-Desktop-LingTouchCompanion/d46657c2-4c7f-457c-a345-b00e85217a57.jsonl`。 |
| C20a | Codex，2026-10-20《准备手柄外壳素材》：`C:/Users/Hsinlung/.codex/sessions/2026/10/20/rollout-2026-10-20T16-55-02-01a15885-6dff-7d20-8401-d664a4c135da.jsonl`。12、53 行确认新外壳使用 PCB1_2。 |
| C20b | Codex，2026-10-20 的外壳制作会话：`C:/Users/Hsinlung/.codex/sessions/2026/10/20/rollout-2026-10-20T17-35-25-01a158aa-68ae-7cc2-8c3e-8cf0d84e78cf.jsonl`。10 行是制作任务；807 行是看完初版后的四项修改要求。这些是用户消息中明确列出的要求；原文标题称“Hsinlung 定下的”，不冒充更早逐句口述记录。 |
| 本次 | Hsinlung 在本次任务中新增的安装孔、握持段和充电宝位置要求，2026-10-20。 |

文件证据主要是 [原件事实清单](Handle/VERIFIED_FACTS.md)、[10/10 初步规划](Handle/ENCLOSURE_BRIEF.md)、[Redesign 说明](Handle/Redesign/README.txt)、[Concepts 说明](Handle/Concepts/README.txt)、[Coaxial_v1 说明](Handle/Coaxial_v1/README.md)、[10/20 说明](Handle_NewPCB_2026-10-20/README.md)及各自脚本。说明中的“AI 建议”“待确认”不会自动变成用户要求。

### 本人明确提出或在用户任务中明确列出的要求

**R01｜用右手握，右拇指读触点。** C10，308 行：“右手握住大拇指感知”。C11，1455–1620 行又连续纠正错误的左右手，最后明确要求先镜像成右手再继续。不是随便放一只手在旁边作装饰。

**R02｜实际握住的地方尽量窄；其他地方可以宽。** C11，194 行：“盲人朋友体验的时候感觉手握的地方有点太宽了”；355 行：“只有握持的地方做窄点就行，别的地方就做宽点也可以啊”。A11，627 行：“握持端要更合理确实是关键”。本次再次明确“手握持的部分要尽量窄”。这是有真人使用反馈的优先项，不能被整体长度或某个底部宽度数字代替。

**R03｜先想清楚手怎么放，再据此改握持处。** C11，355 行：“你先想下手到底应该咋放的”；406 行要求找可活动手模，“先按比例做一个成人手即可”。手模是当时要求的分析手段，不等于以后每版必须交 Blender 手模；真正要继承的是手掌、四指、拇指与壳的关系。通用手模也不能代替真人舒适度结论。

**R04｜外形要对称，不能随便改成一边鼓一边瘪。** C06，1294 行：“你做的都不对称了……先把你做的内容都删了吧”。这是一条明确的拒绝反馈。没有找到后来取消对称偏好的话；也没有找到“每个接口和局部开孔都必须镜像”的要求，别扩大解释。

**R05｜外壳适配指定 PCB，不为外壳擅自改板。** C06，800 行：“pcb文件的模型肯定不能改了”；C11，2438 行回答：“先保留现有 PCB，重做外形与内部摆放”。旧任务对应 PCB1_5；C20a，53 行改为“最后让你检查的那个pcb1_2”。因此不能拿旧板长宽、十五模组或旧电池腔继续当新壳尺寸。

**R06｜PCB 和模组必须按真实焊盘、孔定位，不能按借来的排母占位模型找中心。** C20b，10 行的“已知问题，别重犯”明确提出。旧模型的 2.75 mm 偏差已经被查出，不是允许保留的装配余量。

**R07｜杖口与手柄同轴，做直柄。** A11，549 行：“同轴的吧”；C20b，10 行再次明确“同轴直柄盲杖手柄”。C11 上午允许自由探索外形，是当时的概念探索授权；此后 A11 的决定已把 L/T 方向收回。

**R08｜杖口内孔沿用原手柄，Ø25 mm。** C06，1117 行说“和手杖连接的半径是固定的”。当时 AI 将其解释为内外半径都固定，这个更强说法不是用户原话。C20b，10 行现行要求只明确“杖口内孔沿用原手柄”；原件清单确认内孔 Ø25。旧外径 Ø28、壁厚 1.5 mm 不能因此变成永远不能加强的限制。

**R09｜不要再做原来的长滑槽；插入定位要有余量和厚度。** C10，308 行反映滑槽“对不上”“凹槽那段有点脆弱容易掰断”，允许不用长槽、改凸起凹陷；C11，194 行进一步说“也不需要滑槽了……类似榫卯结构插进去就行”。具体榫数量、螺钉型号、卡扣或热熔螺母是 AI 实现选择，不是他指定的硬要求。

**R10｜尾端要封口。** A11，549 行对“尾端敞口是否有意”回答“没有，是随便做的”；604 行 AI 据此解释为新版封口。C20b，10 行已直接明确“尾端封口”，因此当前需求没有歧义。封口仍要保留必要的操作口。

**R11｜模组固定顶面与盖面齐平。** C20b，10 行：“模组顶面和盖面齐平（原手柄的做法）”。这里说的是模组固定表面，不是把升起的触点也压到盖面下。实际插装高度未量准时不能把名义高度写成实测。

**R12｜新板九个主模组共用一个窗，U48 另开一个窗且要使用。** C20b，10 行：“9 个模组组成的 3×3 主阵列开一个窗；U48 单独再开一个窗，它是要用的。”这已取代旧板十五模组、三条长窗的布置；旧 PCB 任务中 U48 默认不焊也不能搬来限制这版外壳。

**R13｜触觉面不能有紧固件孔；全部从底面操作。** C20b，807 行：“上表面（触觉面）上不许有螺钉头、螺母六角窝。拇指就在阵列附近滑动”；只准留主阵列窗、U48 窗、SW1、SW2。不是只把螺钉头沉下去就算满足。

**R14｜充电宝在壳里，但不能放在手握的位置，只能接在板后。** C20b，10 行指定壳内 PB503；本次明确：“充电宝不要放在手握的位置。J1（USB 口）在板子最后，所以充电宝只能接在板子后面。”不能为变短而把它叠到握持段下面。查到的旧任务没有规定手掌沿 X 的精确位置，下一版仍需把实际握持范围说明白。

**R15｜现行供电优先用 PB503 自带公头直插，必要时才用现成短延长线。** C20b，10 行最初允许直插或短弯头线；807 行改为“供电改用 PB503 自带的 USB-C 直插公头”，对不上时才加“短 USB-C 公对母延长线（PD、3A，越短越好）”，要给可买链接和插头包络。25 cm 双弯头线方案已被取代。公头偏心、伸出和插深要留参数，不能假定实物必然对得上。

**R16｜PB503 侧面 C 口从壳外就能充电，不拆壳、不拔供电接头；开口要平齐。** C20b，10、807 行。后一次明确去掉外凸护罩和“拔线再充”的操作。接口可达和电路能否边充边放是两回事；后者没有由壳体检查证明。

**R17｜PB503 原电源键必须能从外面按到，包括长按三秒。** C20b，10 行给出原因：演示前长按三秒开小电流模式。只留一个看得见按键、手按不到或行程不够的洞不算满足。三秒与小电流模式来自用户任务，本文未重新核对充电宝手册。

**R18｜新板 SW1、SW2 都能从壳外操作。** C20b，10 行。旧要求是 C10，308 行“轻触开关现在没用，放着就行”；当前已经由“两开关都可操作”取代。不能因为旧版 SW1 暂时不用而省掉按键传动。

**R19｜ESP 用 8.5 mm 排母上的 IPEX 版，给外接 FPC 天线留位置；烧录允许开盖。** C20b，10 行还要求贴位离模组、大铜面远一点。旧板载天线图只能参考板尺寸，不能在 IPEX 版上继续加那段伸出的天线板。没有找到必须给 ESP 自带 USB 单独开外口的要求。

**R20｜H2C、PLA，打印要方便，支撑少。** C20b，10 行。原工程和事实清单也记有 H2C、0.4 mm 喷嘴、0.2 mm 层高。后两项是原保存设置；不是用户要求每次永远不能变。不能只因封闭网格或摆得进打印盘就叫“已验证可打印”。

**R21｜整体尽量短小，外形连成一体，尾部平顺过渡。** C06，670 行先提尽量小；C11，355 行已说明局部握持比全壳同宽重要。C20b，10 行重提“握持段尽量细、整体尽量短小、看起来是一体的”；807 行又明确压掉 287 mm 版本的不必要连接长度，尾部去护罩后平顺过渡，并交代各段长度。原壳 270 mm 是比较基准，没有看到用户指定最终长度上限为 270 mm 的独立硬门槛。

**R22｜不知道的尺寸留参数，报告说明依据和验证边界。** C20b，10 行列出模组插装高、IPEX ESP 外形、PB 口键位置、打印间隙；要求放脚本顶部、改数可再生成，实物测量清单简短。还要求摆好姿态的打印 3MF、完整装配参考和图。不是让 AI 编造精确尺寸，再把碰撞检查通过当成实物装配通过。

**R23｜板上已有的两个安装孔必须纳入外壳固定考虑。** 本次明确：“板上有安装孔，外壳要考虑。10/20 版没用这两个孔。”这是当前新增要求。没有找到本次指定“直接把某规格螺钉拧进这两个孔”的话，也不能仅凭旧记录称孔为 0.6 mm 就擅自判定这两个孔永远没用。孔的实际尺寸、孔边空间与固定办法仍需按当前板核实。

**R24｜旧版曾要求两节 18650、独立保护板、不用电池盒，电池在 PCB 下方；现在已被取代。** C10，308、388 行：“两节18650”“有保护板，没电池盒”“位于电池上方”（回答 PCB 位置）。C11，194 行又明确“电池的位置其实也可以改”，所以“永远放前端”从来不是硬要求。C20b 已改为 PCB1_2＋PB503，不能继续为裸电芯、旧保护板留一整段无用深腔。

**R25｜旧版先按模组直接焊死考虑；新板已改按排母插装。** A11，549 行：“先考虑直接焊死，另外，板子高度现在不用细究”。这不是永久禁止排母，也不是允许最终模型不核高度。C20b 的来源和待测项已经明确使用新板模组排母、核对插装总高。旧版 PCB 顶面到模组顶面 20 mm 不能直接沿用到 10/20 版。

### 不能冒充本人已确认的要求

- [ENCLOSURE_BRIEF](Handle/ENCLOSURE_BRIEF.md) 的“Proposed direction”明说是讨论稿。其中“拆盖后 PCB 留在下壳”“少量可拆螺钉”“沿厚度方向取盖”等有合理理由，但不能仅因文档存在就算他逐项批准。
- Coaxial_v1 的 41.3×32.3 mm、128 mm 周长、前后挂钩、两颗 M2.5×30、J_test 按已焊、保护板 24×19.5×7.6 mm，都属于当时 AI 设计或假设，未找到本人逐项验收。该版明确未打印、未真人试握。
- 10/20 的 24.30 mm 插装高、公头居中、伸出 7 / 插入 6 mm、PB 口键位置、ST2.9×25、0.35 mm 间隙等也是 AI 选值或待测值。用户授权 AI 选结构，不等于这些数已被实物确认。
- C11 的“可自由发挥”允许探索方案，不等于批准后来每个 L/T 概念；最后的“全部删掉”也不能反过来理解成批准保留。

## 二、问题

每条都写当时怎么发现、后来怎么处理。没有查到明确原因或修复，就直说没有。以下没有使用其他会话正在写的整理稿。

**P01｜10/06 压缩候选：外形改成不对称，被整批撤回。** C06 的 Compact Candidate / Compact V2。V2 报告称总长约 230.2 mm、握持段 30×41.5 mm，但 1294 行用户直接指出“不对称”，1297、1318 行 AI 承认并删除两版候选。现目录中已找不到它们；不能靠遗留最终尺寸重建出当时具体哪段不对称。为什么没带入：后来 Redesign 仍按错误板位做单侧电容鼓包（见 P04）；是否刻意忘掉对称要求查不到。

**P02｜原始手柄：滑槽装不准，槽边容易断。** C10，308 行是本人实物反馈。原件榫厚 / 槽宽都是 1 mm，伸出 / 槽深都是 2 mm，名义余量为零；2 mm 壁中间开槽后两边各剩 0.5 mm。[事实清单 A](Handle/VERIFIED_FACTS.md)和初步规划都有依据。后续 Redesign 改短榫加侧螺钉，Coaxial_v1 改搭接止口、挂钩和底部螺钉，10/20 改定位柱与底部螺钉。已继承“不要长薄槽”，但这些打印配合仍未经过试打印；不能宣布脆裂已实测解决。

**P03｜原盖与 PCB1_5：开关孔和模组窗不能同时对准，长度方向差约 1.79 mm。** A11，543、604 行；事实清单及只读脚本本次重新得到 1.786 mm。把 SW1 对准时模组会顶窗口末端，按模组对准又会偏开关孔。Coaxial_v1 改成按焊盘开孔；10/20 也按新板位置另开窗。该经验已用上；原盖的三条窗不能继续当新板定位基准。

**P04｜Redesign / Concepts / GripStudy：PCB 横向偏了 2.75 mm，相关间隙结论跟着错。** 用借来的排母三维占位模型中心找窗口中心，未用实际焊盘。A11 按模组焊孔、SW1、ESP 两排插座和板框的共同中线发现；[事实清单 B](Handle/VERIFIED_FACTS.md)正式撤回旧结论。旧 `T_PCB` 的 Z 为 −4.146；修正居中后，前端定位榫根部会压板边，32 mm 版给 C78/C79 做的单侧 1 mm 鼓包也失去原依据。Coaxial_v1 将板移回，10/20 按原生坐标重新定位。为什么当时扩散：各研究共用同一错误板位，检查只验证了那个板位下的模型。10/20 没查到重犯同一个 2.75 mm 错误。

**P05｜10/11 早期装配：模组顶面虽然贴着盖，模组与板的实际连接高度却没成立。** A11，543 行指出图中模组悬在板上约 3.6 mm；如果直接焊，顶面反而低约 3.6 mm。后续 Coaxial_v1 按直焊把板顶改到 Y=3.5，模组顶面取 Y=23.5。不能说此前已发生焊装失败：本人当时说高度先不细究，模型只是没完成这个前提。10/20 已区分排母高与模组高，但总高 24.30 mm 仍待实测。教训是不能单独把模组挪到盖上就声称整机对好了。

**P06｜原件实拍：外侧模组歪斜，开关孔边有崩边。** 这是 A11，543 行 Claude 看实拍后的报告：外侧 10 mm 窗中的模组比中间 9 mm 窗更歪，模组本体宽 8.2 mm。本次未重新找到并核看那张原照片，因此这里只按“历史 AI 的看图观察”保留，不升格为本人原话；窗口更宽是否就是歪斜原因也未证实。Coaxial_v1 采用 8.9 mm 窗并另做 PCB 固定。10/20 是九模组共窗，不能照搬三条窄窗，需靠真实插装与板固定保证位置。

**P07｜原始手柄：尾部其实没有端壁。** 止挡上面约 42×33 mm 敞开，不是用户有意保留的尾口。A11 看截面及渲染发现，549 行用户澄清；事实清单和本次脚本仍确认旧盖没有尾端壁。Coaxial_v1 与 10/20 已封口。为什么早期没处理：旧规划沿用了“保留尾端止挡”，但没有同时辨认止挡上方仍敞着；这是文件与几何可对照出的遗漏，不能猜作者原本动机。

**P08｜原始手柄：杖孔直通内腔，没有插入止挡。** 事实清单 A、A11，543 行。不是实测断裂，而是几何上的插深无限位。Coaxial_v1 的 `shape.py` 已注明 X −10..−8 为止挡；10/20 的 `build.py` 将孔底放在 X=−6、内腔起点 X=−3.5，留下 2.5 mm 实体。已继承限位经验。旧 1.5 mm 杖口壁厚的弯曲强度仍没有实测，不可把“有止挡”说成“承力验证通过”。

**P09｜原始件和早期研究：没有完成 PCB 的独立固定。** A11，543 行指出原板只有一个 Ø2.2 mm 孔、各早期壳没有托板结构；旧研究说明也承认不是完整硬件装配。只是把 PCB 放在显示位置、模组露在窗里，不等于板装进去不会晃。Coaxial_v1 加托台、六个压指；10/20 加三对板边托位和压指。10/20 对“有支撑”做了处理，却没有纳入本次强调的两个安装孔，见 P22。固定位置和力的检查不能由零相交自动得到。

**P10｜原始打印工程：上盖在打印盘上斜了约 0.9°。** 事实清单 A 根据 3MF 构建变换确认，顶面未贴平。没有证据说明这就是某次实际崩边的唯一原因。后续各版重新摆打印方向；10/20 说明称上下壳平面朝下、Z=0。经验已用上，但原生切片结果尚未确认。

**P11｜Redesign 的 34 / 32 mm：只改了底部，看着数字窄，完整握持截面改善很小。** [Redesign 说明](Handle/Redesign/README.txt)明确上方仍宽 46 mm。A11，543 行量得外廓仍约 46×35.5 mm、周长从 159.8 到 153.3 mm，只降约 4%。所以“下部 32 mm”不能直接当成整只手包握的截面。Coaxial_v1 才改完整截面、大圆角并报告周长约 128 mm。10/20 又没有说明手掌实际包围的截面，见 P23、P24。这是整形与握持需求脱节的问题，不是越小越好的一维比较。

**P12｜Redesign 短榫：去掉长薄槽，却在螺孔上方只剩约 0.6 mm 料。** A11，543 行为数字截面评审，不是已打印断裂。换成短榫并没有自动解决连接根部太薄。Coaxial_v1 换结构；10/20 说明报告前螺柱最薄径向 1.55 mm、自攻孔上方留 9.17 mm。具体数值不是统一强度标准；没有实打螺孔与反复拆装结果，不能宣布 PLA 螺纹寿命已通过。

**P13｜Redesign 打印文件：开口朝上立放，需要大面积支撑。** [事实清单 B](Handle/VERIFIED_FACTS.md)记约 11,700 mm² 需支撑；A11，543 行还指出弧形底接床。早期文件名叫 `Handle_Print.3mf`，不代表已摆成合适打印姿态。Coaxial_v1 重新比较方向，但下壳仍是尾端朝下、238 mm 高的长件，明确需要 brim 和支撑，未打印；不能替它虚构失败。10/20 已改上下壳平放、杖孔分两半，长壳不再竖打。此经验已部分用上。

**P14｜GripStudy 前期：拿左手当右手，还错误反驳用户。** C11，1455、1526、1598 行用户指出；1519 行 AI 仍说“确实是右手”，1604、1613 行才承认左手。1620 行用户授权把手模与骨架一起镜像再继续。当前 [Concepts 说明](Handle/Concepts/README.txt)明确源左手整体镜像；`GripStudy/delivery_check.json` 记后续 right_hand=true。结论不是“镜头看着像即可”，而是皮肤、骨架、指甲整套左右关系得对。10/20 没用手模，不能说它又放了左手。

**P15｜GripStudy 前期：手掌压在盖面、拇指横过手柄，四指只勾着对边。** C11，1011 行用户说手摆得不对；1076、1111 行 AI 明确承认这些姿势错误，后续改为掌在侧面、拇指沿柄向杖端伸、四指包下方。1262 行又发现中指、无名指中段悬空，继续改关节。没有穿模并不等于握住了。10/20 没留下实际握姿与扫读范围检查，见 P24；不能说姿势经验已经被验证继承。

**P16｜Concepts A/B：掌托不足，局部手与壳穿插，仍被交出来。** C11，3210、3232 行 AI 承认；当前 [Concepts 说明末尾](Handle/Concepts/README.txt)仍列 A 拇指根约 1.46 mm 交叠、B 食指根约 1.72 mm 交叠，A 掌支撑弱，C 未检出交叠。后续曾尝试 Reform，但没有获采纳。为什么没拦住：结构相连、硬件占位通过与手部表面接触是不同检查；已有问题还在就说“概念已建好”，不能据此证明好握。

**P17｜Concepts A/B/C：做成了大盒子加独立握杆，偏离完整直柄的方向。** C11，3222 行用户质问；3232 行 AI 承认“长电路盒＋外挂握杆”“主要是在转盒子、换杆方向”。A11，543 行再量出 A/B 整体约 226×200×83 mm、按实心体积折算塑料约 360 g，且未做打印分件与固定。这些重量是 AI 数字估算，不是称重。A11，549 行确定回同轴直柄，Coaxial_v1 开始按此做。不能把最初允许探索当成最后批准 L/T 形。

**P18｜Reform：反复局部补形、检查穿插后仍整版被拒，不能留下“已解决”的假印象。** C11，3386–3843 行记录重做掌托、板鼻曾外露、肩部检查异常；3658 行称改用实际表面核查并补齐板鼻。3854 行用户最后要求“把你这次做的东西都删掉”。当前 `Handle/` 中未找到 Reform 成品；无法再量其具体缺陷，拒绝本身也不能证明某个未说出的尺寸错。能确认的教训是：表面不穿插、板被包住，仍没让用户接受整体形态。不能从当时 AI 的完成汇报继承“好握”。

**P19｜10/20 初版：触觉面前后有四五个螺母六角窝。** C20b，807 行是用户看渲染和 `build.py` 后指出，明确说拇指就在附近滑动。后续现版改底面 ST2.9 螺钉，上壳为盲孔；[verify.py](Handle_NewPCB_2026-10-20/verify.py)检查顶面仅有四个允许开口，`motion_verification.json` 记录额外缺失体积为 0。这个问题现版已经处理；不能继续把当天初版的六角窝算成现版违规。为什么又犯：此前 Coaxial_v1 已将紧固件避开握持表面，但最初任务未逐句重复这个具体限制，旧经验没有自动落实；这是对记录的归纳，非作者自述。

**P20｜10/20 初版：25 cm 双弯头线在板下绕一圈，侧面多了护罩，还要拔线再充。** C20b，807 行直接撤回该方案，要求自带公头直插、侧母口只充电且平齐。当前 [build.py](Handle_NewPCB_2026-10-20/build.py)的 PB 公头向 −X、PB 本体在 J1 后，侧口贯穿壳缝，不再留那圈线；README 已警告备用 5 cm 线不能硬塞进现有 0.815 mm 连接段。已修复设计方向，直插真实性仍受未实测接口偏心限制。不能把“代码按同轴位置摆了两个包络”说成实物接头已插合。

**P21｜10/20 初版：全长 287 mm，比原壳还长，连接段有不必要空间。** C20b，807 行要求缩短并分段报告。现版 `FRONT=-34`、`BOARD_L=135.89`、`PB_X=136.705`、`PB_LENGTH=79`、尾端 10 mm，壳长 259.705 mm，含按帽 260.305 mm。杖口段 34、板段 135.890、连接段 0.815、PB 段 79、尾段 10 mm，各段之和正确。这个问题现版已处理；“短了”仍不能替代握持和装配要求。

**P22｜10/20 当前版：知道加了两个孔，却完全绕开它们做固定。** [build.py 第 176–185 行](Handle_NewPCB_2026-10-20/build.py#L176)写着 `no reliance on the new 0.6 mm holes`，只在 X=4、55、132.4 做三对板边托位与压指，并加端挡。README 又明确“新增两孔不用作支撑”，装配板体还是未包含新钻孔的 STEP。是本次用户直接指出的遗漏；没有后续修复。为什么没用上能看出的部分：实现把“不要靠新增小孔承重”直接当成设计选择，但没体现用户现在要求的安装孔考虑。查不到用户曾同意忽略这两个孔的记录。这里不能擅自开出螺钉规格，也不能把“孔很小”当成无需考虑的结论。

**P23｜10/20 当前版：充电宝虽在后面，却通过统一底面把前面的握持段一起撑厚。** 参数事实与影响推断详见最后一节。Coaxial_v1 已把不同区域的底面分段变化，当前 `tube_envelope()` 却让板段和 PB 段共用 `BOTTOM/FACE`。这使“只收需要手握的地方”没有充分落实到截面。未打印、未试握，不能说已经证实不舒服；也不能在没重做装配检查前承诺某个更薄尺寸必然能用。

**P24｜10/20 当前版：没有留下实际手握哪段、拇指怎样扫完整阵列的核对。** 当前 README、build / verify 和静态、运动结果有硬件与壳检查，没有手掌范围、握持接触或扫读范围检查。代码主要检查按杆、滑块、拆盖和充电插头；没有发现本版手模或真人试握结果。这是证据缺项，不是证明手一定够不到。以前 P11、P15、P16 已表明“装得下”“不穿模”无法证明握持合理；当前又只报 39.27×39.47 mm 截面，尚未把这一经验落实成可判断的握持证据。

### 还没证实的事情，不补写成故障

- Coaxial_v1 的保护板尺寸、绝缘、线材固定、打印公差和杖口强度均有待确认项；没有找到其已打印、已断裂、已获本人认可的证据。它的优点可以参考，不能当作成功实物基准。
- 10/20 模组插到底后的总高、IPEX ESP 外形、PB 公头偏心与口键位置仍待实物核对。当前参数包络可能正确也可能不正确，不能直接记成“尺寸已做错”。
- 10/20 原生 Bambu Studio 导入/切片未验证，README 记 CLI 返回 −6，旧件对照未完成，界面访问又被自动审批拒绝。这说明交付验证未闭合，不能单凭 −6 断言 3MF 一定坏了，也不能称已经实打通过。
- 10/20 没有看到完整承力、反复拆装或射频/真人握持试验。现有零碰撞结果只覆盖其输入包络与离散姿态。
- `git log --all -- 3mf/Handle 3mf/Handle_NewPCB_2026-10-20` 只找到 `6f46dfa`（2026-10-08 的源文件归拢提交），没有逐版模型提交。版本过程主要靠当前文件与上述会话，不靠猜测缺失的 git 历史。

### 10/20 当前版：还违反了什么、又漏了什么

这里不把已经改掉的六角窝、25 cm 线和 287 mm 长度继续算进现版。**确定未落实的需求 1 条；另有 1 项有参数依据的收窄不足推断、1 项握持验证缺项。** 后两项不能硬写成已经发生的实物故障。

| 当前结论 | 对应需求 / 老问题 | 具体文件或参数 | 现有证据能说到哪里 |
|---|---|---|---|
| **确定遗漏：两个安装孔未纳入固定。** | R23；P09、P22 | `build.py:176–185`；README“新增两孔不用作支撑”；`SCREWS` 是上下壳紧固点，不是 PCB 安装孔使用记录。 | 本人已明确要求考虑，而现版明确不用。检查用板体又不含新孔。不能替它声称孔位/孔边空间已经核过。 |
| **推断：握持段没有尽量按本段硬件收薄，受尾部 PB 尺寸牵连。** | R02、R03、R14；P11、P23 | `build.py:47–52`：`FACE=26.504`；`PB_Z=3.334`、`PB_THICKNESS=26.5`、`PB_CLEAR=.65`、`WALL=2.4` 推出 `BOTTOM=-12.966`。`tube_envelope():88–95` 将这同一底面用于前段、X=105、PB 段和尾端，故握持厚 39.47 mm。 | 本次只读缓存 `models/pcb_parts.npz/json`：全板最低源器件 C76 底为 Z=−7.75，X≈82.714–90.514。若只做底面空间比较，按同样 .35 mm 普通间隙和 2.4 mm 壁厚，底面约 −10.50 即可避开该最低器件，比当前高约 2.466 mm。**这不是完整新方案或可打印尺寸**：还需重新核杖口同轴、螺柱、按钮与装配。能确认的是当前高度公式由 PB 决定，不是由握持段本地最低元件决定，旧版分段收薄的经验未沿用。 |
| **查不到：充电宝是否彻底避开手掌，拇指能否自然扫完阵列。** | R01–R03、R14；P15、P16、P24 | 主窗 X≈23.466–45.166；PB 本体 X=136.705–215.705，几何上确在 PCB 末端 135.890 之后。壳从 X=105 起加宽，到 PB 前端宽 56.538 mm；`verify.py` 无手部/扫读检查。 | **“PB 在板后”已经满足，不能列成违反。** 但没有本版手掌范围，不能仅凭前后位置就证明宽尾段不会进入掌心。也不能反过来断言一定握到了 PB。下一版至少要展示自然握姿、手掌接触范围和拇指扫读关系，才能判断这条。 |

其余有证据继承的项包括：同轴 Ø25 内孔、尾端封口、按新板焊盘定位、九模组共窗加 U48 独窗、模组固定面名义齐平、底面紧固、PB 独立托架、外部按键与平齐充电口，以及平放打印方向。它们目前主要是设计与数字包络层面的落实，不是实物验收。
