Cheerssom/LingTouchCompanion/hardware/models/BrailleModule_Video/ArrayPreview/使用说明.md

# JSON 编排与视频工具

现有渲染结果已被 Hsinlung 否定并删除。现在只保留尚未获认可的源场景、网页编辑器和生成工具，没有已认可的成品素材。下面是操作说明，不代表当前外观或装配已经达标。

## 检查与运行

在仓库根目录打开 PowerShell，先检查输入，不渲染：

```powershell
& './BrailleModule_Video/ArrayPreview/GenerateVideo.ps1' './BrailleModule_Video/ArrayPreview/video.patterns.example.json' -Validate
```

生成入口使用同一条命令，去掉 `-Validate`：

```powershell
& './BrailleModule_Video/ArrayPreview/GenerateVideo.ps1' './BrailleModule_Video/ArrayPreview/video.patterns.example.json'
```

工具加载 `EnclosedArray.blend` 中的外观和动作，在内存中调整本次时间表与镜头，生成视频后不保存源场景。默认输出到 `%TEMP%/LingTouchVideo` 下的独立文件夹，包含 `video.mp4`、PNG 帧和 `run.json` 执行记录。加 `-Out 'C:/path/my-video'` 可以指定文件夹；中断后仅能在输入和场景版本相同的情况下续跑。

## 两种输入

- **网页导出的 JSON／JSONL**：打开 `index.html` 编辑或导入图案，再选“导出 JSON”。支持记录数组、`{"frames": [...]}`、单条记录和一个 10×9 的 0/1 矩阵。`ts` 单位为毫秒，默认生成完整时间表的近景视频，末尾保留 1 秒。
- **视频任务 JSON**：[video.patterns.example.json](video.patterns.example.json) 可修改图案、时间和镜头；`time_s`、`start_s`、`end_s`、`tail_s` 单位均为秒。[video.example.json](video.example.json) 用 `"timeline": "reference"` 读取已保存的时间表。两者都是操作示例。

**1 表示升起，0 表示降下。** 矩阵从上到下 10 行、从左到右 9 列；每两行、三列对应一个六点模组，共 15 个模组。`pattern` 可写 `off`（全降）、`checker`（交替）、`cross`（十字）、`on`（全升），或 10 条各含 9 个 0/1 的字符串、10×9 矩阵。

事件按时间升序排列，沿用现有升起、峰值停留、回落和缩回曲线。重复相同目标不会重新启动动作；运动中反向会从当前高度开始。

## 镜头与画质

`shots` 按列表顺序拼接。每项用 `camera` 选择 `near`（近景）、`whole`（全景）或 `switch`（按钮），用 `start_s`、`end_s` 选择源时间表中的区间。可选 `near_elevation_deg` 调整近景俯拍角度，`fstop` 调整景深。

默认画质为 1920×1080、源场景帧率、128 samples、自动选择设备。图案示例使用 30 fps、192 samples。`deduplicate_holds` 开启静止帧复用，运动阶段仍渲染；编码时每帧添加细微颗粒。详细参数见 [VIDEO_JSON.md](VIDEO_JSON.md)。

## 检查能证明什么

`-Validate` 只检查输入格式、时间范围和预计帧数。动画、网格或保存检查只证明相应数据符合预期；`run.json` 记录生成过程。它们都不能证明外观真实、升降清晰、像实物或能装配。源场景维护入口及保存行为见 [README.md](README.md)。
