Cheerssom/LingTouchCompanion/hardware/models/3mf/Handle_TwistKey_2026-10-27/HANDOFF.md

# 交接：手柄外壳改版（拧扣榫）— 2026-10-27 晚

给明天接手的 Claude。先把这份读完，再动手。分支：`claude/trusting-brown-h7384r`（已推送）。称呼用户 Hsinlung。

## 0. 怎么跟他说话（这次踩过的坑）

- 中文，短，先给结论。不要一次列一堆"类别 / 情况 / 术语"。今天列了 6 类锁法，他回"听不懂你说的各种情况"。
- 讲结构要配图（示意图或截面图），标上他认得的部位名：杖口、模组区、坡、握把、尾巴、托盘、前盖、后盖。他看懂了图才会往下走。
- 他不喜欢等：长时间没回话他会问"这么久？"。超过几分钟的活，先说一句在干嘛。
- 不要把自己的推断说成定论。今天我先说"每个接头都必须拧"，后来改口说过头了；又画了"一头帽、一头扣"，建模时才发现那两个挡的是同一个方向，是错的。凡是结构上的说法，先用几何检查验证，再告诉他。
- 他的偏好（原话见 §1）：想清楚问题、他说开始了，才出方案或文档；他提的问题就是唯一的任务。

## 1. 他今天的原话和决定（只认这一层）

1. 已经实打了 10/27 那一版（`3mf/Handle_NewPCB_2026-10-20/`）。结果：
   - "安装孔的凸起，都断了，只有这一个问题，别的都和打印的元件一样"
   - "榫有点松（是我预留的太松了，这个算是我的问题），根本卡不住"
2. "这个0.6mm根本就不算问题啊"：板厚模型用 2.204，实际是 1.6，不用为这个改。
3. "模组是比之前高了一个排母的高度"。后来他补充：排母量下来大约 4 mm，"现在的模我记得是考虑了这个排母的尺寸的啊，你tm别再加又加错了"。核对过 build.py：模组顶面 FACE = 板顶 + 24.30 = 排母 4.30 + 模组本体 20，已经包含这个排母。**模组高度不改，不要再加一次排母。**
4. "那就全部重新打吧"：全部重打；"你的结果直接新建个文件夹即可"；"你最好只是完整的改其中的某些零件"（改哪个零件就整件换，不做局部补丁）。
5. 榫的做法：他否掉了"用杖当销"（理由："这个榫在竖直方向啊，我觉得很难把控尺寸，小了容易滑出来，大了又很容易卡死，并且3d材料也没这么结实"），最后定了 **"做法一，全用做法一就行吧，直接开始吧"**。三处（前、后、中间）都用拧扣榫。
6. 测试块：他要"按真实尺寸建一个榫…我先打一个看看"。已交付（§3），反馈见下一条。他问过要打几件，已确认：托盘块、盖子块、一根榫、一个扣，共 4 件（想比两种间隙就多打一根榫）。
7. 10/28 测试块反馈：只打了 0.1 那根榫，"挺紧的"，用 0.1；扣"有点松，但现在够用"——既晃又一碰就转，"主要想解决2的问题"（一碰就转），"简单有个感觉能卡住就行"。选了"扣上加小凸棱 + 坑底浅槽"的咔哒做法，手柄文件就放本文件夹。已交付 `key_detent_test.py` / `Key_Detent_Test.3mf`（托盘块、盖子块、凸棱 0.10 和 0.15 两个扣，共 4 件），**等他打印后的反馈**。
8. 更早的、仍然有效的要求，见 `../Handle_NewPCB_2026-10-20/HANDOFF_CC_2026-10-27.md` §1 和 `HANDOFF_2026-10-27_evening.md`。要点：
   - 不要长在壳上的细凸起（"用几次都掉了"）；
   - 支撑只认拓竹默认设置真切的结果；
   - 不要螺丝、螺帽（"那是打钉子"）、磁铁、胶、弹片卡扣、靠挤紧；
   - 握持段尽量窄；左右对称；别做复杂。

## 2. 拧扣榫的结构（已用几何检查验证）

- **榫**：沙漏截面，跟 10/27 版一样。前榫宽 4.45、腰 2.85、高 7.0；后榫宽 4.95、腰 3.35、高 7.0。横着（沿 Y）穿过托盘和盖子的分缝 Z=0，两边各挖一半槽。
- **槽只在一侧开口，远端在壳里封死**（离远侧面 2 mm）。榫往里推，顶到封死的那头就停。**不要给榫加帽**，加帽是错的。
- **扣**：扁平小件（整个件厚 2.4，平放打印，无支撑）。从里到外是三段：
  - 里面一横：长 6.8，厚 1.2；
  - 中间一段：2.2 × 2.4，穿过口；
  - 外面一条：长 8.4，厚 1.0，在侧面圆坑里，比侧面低 0.8。
- **开口那侧，从外往里**：
  - 圆坑：r 4.5，深 1.8；
  - 口：厚 1.5，开口形状就是沙漏槽，再加一个 r 1.85 的圆，给中间那段转动用；
  - 扣的转动腔：r 3.75，深 1.6；
  - 腔底就是榫的外端。
- **装**：榫从开口插到底 → 扣竖着从口插进去 → 拧 90°，里面那一横卡在口的后面。
- **为什么锁得住**：
  - 扣往外拔，会撞到口；
  - 榫往外退，会撞到扣；
  - 扣往里推，会碰到榫；
  - 榫往里推，会碰到封死的那头。
  - 平时的力（重力、推拉、甩、敲地）都不是在拧扣，所以只有主动去拧才会开。长期震动会不会让扣自己慢慢转开，还没测。
- **间隙和晃动**：榫槽每边 0.2 时，盖子能往上晃大约 0.9 mm；改成 0.1，大约 0.45 mm。原因是沙漏斜边很陡。现在晃多少跟会不会滑出来已经无关，可以按手感调紧。

## 3. 已交付

- `tenon_test.py`：测试块生成和检查，`python -B tenon_test.py` 重新生成。
- `Tenon_Test.3mf`：6 件。托盘块、盖子块、榫（间隙 0.2）、榫（间隙 0.1）、扣、备用扣。已按打印姿态摆好。
- `tenon_test_check.json`：检查结果，全部通过（装配不重叠、插入路径、转 90°、四个方向被挡住、盖子上抬被卡住）。
- `tenon_test_preview.png`：截面示意图。
- `README.md`：给他看的说明。
- 按 30° 规则做了几何检查：6 件都没有需要支撑的朝下面。**拓竹没真切过**，这台云端机器没有拓竹。

## 4. 明天要做的（按顺序）

1. **先问他咔哒测试（`Key_Detent_Test.3mf`）的反馈**：锁住时有没有咔一下停住、费不费劲、哪个凸棱高度。榫间隙已定 0.1。手柄里的三个扣都用选定的凸棱高度和夹住口的尺寸（`key_detent_test.py` 的 `key()`、`shells()` 里的浅槽）。
2. **新建手柄文件夹**，不改旧文件夹：
   - 以 `../Handle_NewPCB_2026-10-20/build.py`、`verify.py`、`render.py`、`slice.py` 为底，复制到新文件夹里改（比如本文件夹，或者 `Handle_PCB1_2_v2_<日期>`，问他）。
   - 输出：托盘、前盖、后盖、前榫、后榫、中间榫、三个扣，共 9 件。
3. **三处换成拧扣榫，要解决的空间问题**：
   - **前榫**：在杖孔底（X −8）和腔体起点（X −0.35）之间那块实心里，沿杖方向只有 7.65 mm 宽。扣的转动腔直径 7.5，侧面圆坑 r 4.5，几乎没有壁。要让出 1–2 mm：可以把榫缩小、把杖插深 28 改小一点、或者把腔体起点往后挪。**改杖插深或板子位置之前先问他。**
   - **后榫**：尾段侧壁只有 2.4 mm，口加腔要 4.9 mm 深，要在两侧壁内侧加凸台（充电宝后面 X 228.4–236.9 有空）。封死的那头也要有壁厚。凸台要按打印姿态做成无支撑：托盘的凸台要接到底板上；盖子的凸台顶到上壁，或者内侧做 45°。
   - **中间榫**：在两块盖的缝 X≈61.5、Z 5–14，原来是 V 形折条。侧壁同样只有 2.4 mm，同样要加凸台。还有一点要先想清楚：它跨的是前盖和后盖之间那道竖缝，沙漏截面要换个方向，截面画出来给他看过再做。
4. **安装孔**：Ø1.0 的销全断了，要去掉。改成 10/23 他认可的做法：托盘在孔正下方做小平台托住板，盖子柱子末端做短锥头，只进孔零点几毫米，压住板、把板推到孔中心。
5. **模组高度：不改。** 现有模型已经算了这个排母（见 §1.3），他也说其他尺寸都和打出来的一样。
6. 跑验证：碰撞；三处锁的插入、转动、四个方向；两块盖连同中间榫能整体从托盘上抬下来；朝下面检查。出图，自己真看一遍。
7. **拓竹真切只能他在本机跑**（`slice.py` 调的是 `D:/Bambu Studio`）。说清楚哪些查过、哪些没查。

## 5. 还没问到的

- 咔哒测试反馈（§4.1）。
- 新手柄文件放本文件夹（10/28 他已确认）。

## 6. 环境（云端这台机器）

- Python 3.13，用 `pip install manifold3d trimesh matplotlib` 装依赖，几秒就好。matplotlib 中文字体用 `WenQuanYi Zen Hei`；渲染 SVG/PNG 可以用预装的 Playwright Chromium。
- 旧的 `build.py` 开头会读 `ROOT/.pcba-workflow/pcb1_2-recheck-20261018/live-check-evidence.json`，这个文件只在他电脑上，云端会直接报错。两个安装孔在板坐标下是 (1.143, 15.240) 和 (134.366, −15.113)（10/27 交接记录），可以写死顶替。报告里的 STEP 哈希也读不到，那一段要跳过。
- 板子的器件网格 `../Handle_NewPCB_2026-10-20/models/pcb_parts.npz` 和 `native_positions.json` 都在仓库里，能用。
- 发文件给他用 SendUserFile；改完的东西提交并推到 `claude/trusting-brown-h7384r`。
