Cheerssom/LingTouchCompanion/hardware/models/3mf/Handle_NewPCB_2026-10-20/HANDOFF_2026-10-27_evening.md

【他这一轮的原话，一字不改】
"1.确定这个板内部可以放现在最新的电路板，2.安装孔，现在这个安装孔的插槽，凸起太细，又太长，很容易断，这个也要重新做下，3.你的榫，根本就固定不住，我知道我说过允许你做小一点（我和claudecode是这么说的，你不知道正常），但我想要的是榫别tm滑出来啊，现在这样就稍微倾斜一下就滑出来了，意思是，我又要可反复拆卸，又要不拆的时候完全固定死"
"充电宝我还没买，你可以再确定一下尺寸是不是对的"
"我tm需要我想能卡住的时候卡死，想不卡死的时候才能拆下来，按你这样，我tm往另一边推一下不就tm拆下来了？"（否掉渐紧燕尾）
"你到底懂不懂榫卯结构是啥意思"（否掉打印螺丝、横销加螺帽：那是打钉子）
另：最后下单的板是 PCB1_2。

【Claude 核过、已定的结论】
- 板子平面放得下：板框没改；下单前新增的两个安装孔、C33/D3 移位，build.py 已按 .pcba-workflow/pcb1_2-recheck-20261018/live-check-evidence.json 补上。
- 板厚按下单记录 1.6 mm（.pcba-workflow/pcb1_2-manager-20261018/SUMMARY.md）；现在 build.py 用的是 EDA 叠层 2.204，所有以板顶为基准的高度（模组面与壳面齐平、ESP、安装孔压板）都要按 1.6 重算。
- 安装孔：去掉现在穿过 Ø1.2 孔的 Ø1.0 长销（他说太细太长易断）。改回 10/23 他认可的做法：托盘在孔正下方做小平台托板底，板两条长边照旧搭在托盘边沿；盖子柱末端做短锥头，锥面卡在孔口，合盖时把板压在平台上、并把孔推到正中。锥头只进孔零点几毫米，根部就是整根柱子；盖子顶朝下打印时锥尖朝上，无支撑。
- 充电宝 PB503：官网 79×38×26 mm，充电头网卡尺实测一台 78.66×38.43×26.42；模型 79×38.5×26.5 加间隙，尺寸对。
- ESP 载板 57.15×27.94 来自 YD-ESP32-S3 厂家尺寸图，IPEX 版只少了伸出的板载天线；模组插装高 24.30 = 本体 20 + 排母 4.30 的名义值。

【榫：判断标准与现状】
- 标准：装好后，倾斜、推拉任一头、甩、手握、敲地震动都不能让榫出来；只有照特定拆法操作才拆得开；能反复拆装；纯靠打印件形状，不用螺丝/螺纹/螺帽、弹片/倒钩/劈缝/卡扣、摩擦挤紧/渐紧/过盈/压筋、外购销、竹签、磁铁、胶、壳上凸起销、直方条。
- Claude 的提案，他还没选定就叫停了，云端动手前要先跟他确认：前后两处（托盘↔盖）改成"转销"——那两段合缝做成上下交错的齿（像合页），一根圆销横穿各齿；销一头的头比孔大，另一头有两个小耳朵；插入时耳朵对着最外那块齿的缺口，转 90° 后耳朵挡在齿外，往回拉拉不出、往里推推不动；拆法是用硬币拧回 90° 再抽出。理由：重力、推拉、握、敲地的力都沿着销或穿过销中心，转不动一根轴对称的圆销，只有主动去拧才会解锁。齿上的孔做尖顶，按现在的打印方向无支撑。
- 已否：渐紧燕尾（一推就出）、竖螺丝和横销加螺帽（打钉子）、弹舌（10/23 否过）、走马销/楔钉/金轮继的栓/穿带（靠挤紧或留着退路）。
- 中间那根（前盖↔后盖）不拆，只要永远不出来，这轮没定做法。

【资料指针】research_2026-10-27.md（板、ESP、模组、PB503 的出处）、research_tenon_2026-10-27.md（榫的检索与淘汰）、HANDOFF_CC_2026-10-27.md（本版三块壳的方向）、README.md、REPORT_2026-10-27.md、../Shell_Lessons.md。
