Cheerssom/LingTouchCompanion/hardware/models/3mf/Handle_NewPCB_2026-10-20/REPORT_2026-10-27.md

# 2026-10-27 版：与原手柄对比、支撑、榫、改动

## 与原手柄比

原手柄的数据从 `3mf/Handle/Handle_Print.3mf` 按原装配偏移量出，两边用同一套拓竹默认设置切片。

| | 原手柄 | 本版 |
|---|---|---|
| 握把截面（宽 × 高） | 46.0 × 35.5 mm | 38.3 × 32.1 mm |
| 最粗处截面 | 46.0 × 54.5 mm（电池段、尾钩） | 44.0 × 37.0 mm |
| 总长 | 270.2 mm | 272.9 mm |
| 杖口 | Ø25，壁厚 1.5，孔直通腔体 | Ø25，插到底有 7.65 mm 实体挡住 |
| 实体体积 | 86.5 cm³ | 102.8 cm³ |
| 拓竹默认切片：整盘 / 支撑 | 113.58 g / 28.67 g | 96.09 g / 2.25 g |
| 件数 | 2（外壳 + 上盖） | 6（3 块壳 + 3 根榫） |
| 盖与壳的连接 | 零间隙长滑槽，槽边各 0.5 mm 薄壁 | 单独打印的榫插进两边的槽 |

**不如原手柄的地方**

- 件数多：原来 2 件，现在 6 件。
- 实体体积多 16 cm³。原因是杖口外壁加厚，以及模组区、握把的壁都是一圈 2.4 mm。打印实耗（不含支撑）约 94 g，原来约 85 g。
- 总长多 2.7 mm。
- 原来的尾钩没有了。这是 Hsinlung 说"不用"的。
- 握把前端侧面露出中间榫的端头（与侧面齐平），手摸得到一条 V 形缝。
- 榫的松紧、能不能卡住，没有实打过。

## 支撑（拓竹真切）

设置：Bambu Studio 02.07.01.62，H2C、PLA Basic、0.4 mm、0.20mm Standard，只打开支撑，其余为系统默认（tree(auto)、阈值 30°）。没有屏蔽体、没有涂抹、没有限制仅从热床生成。六件都按规定姿态摆放，壳不旋转、不找角度。

| 件 | 打印姿态 | 件重（含支撑） | 支撑 | 支撑位置 |
|---|---|---:|---:|---|
| 托盘 | 底面贴床 | 36.70 g | 1.142 g | 底边贴床那圈，离床 ≤ 1.9 mm（认可） |
| 前盖 | 模组面贴床 | 23.10 g | 1.112 g | 杖口段顶面下，离床约 3–4.5 mm，含杖口到模组面的过渡（认可） |
| 后盖 | 握把顶面贴床 | 32.88 g | 0 | — |
| 前榫 | 宽平面贴床 | 0.91 g | 0 | — |
| 后榫 | 宽平面贴床 | 1.15 g | 0 | — |
| 中间榫 | 竖立，截面贴床 | 1.30 g | 0 | — |

- 认可之外的支撑为 0 g。
- 盖子顶边那圈圆角，在几何检查里属于认可的朝下细带，但拓竹实际没有为它生成支撑。
- 切两次，结果完全相同。

verify.py 另外做了几何检查：每件在打印姿态下逐面找比 30° 平的朝下面，逐层（0.2 mm）找凭空起头、或比下一层悬出超过 0.35 mm 的区域。认可的三处之外，结果为 0。

## 三根榫

| | 位置 | 截面 | 长 | 连接 | 拆不拆 |
|---|---|---|---|---|---|
| 前榫 | X −4.18，杖孔底后面的实体里 | 沙漏：宽端 4.45、腰 2.85、高 7.00 | 39.17，两侧各凸出 1 mm | 托盘 ↔ 前盖 | 拆 |
| 后榫 | X 232.82，充电宝后面 | 沙漏：宽端 4.95、腰 3.35、高 7.00 | 46.00，两侧各凸出 1 mm | 托盘 ↔ 后盖 | 拆 |
| 中间榫 | 缝上 X 61.52，Z 5–14，板子上方 | 45° V 形折条：宽 8.0，竖向厚 5.0 | 38.27，与侧面齐平 | 前盖 ↔ 后盖 | 不拆 |

- 每个槽全长都比榫大 0.2 mm/面，没有任何过盈或摩擦段，榫是松插进去的，不会卡死。代价是沿插入方向没有东西拦着，前榫、后榫可能顺着槽滑出来。
- 前、后榫：盖子往上抬、托盘往下掉都被沙漏挡住。
- 中间榫：两块盖都被托盘压住、不能上下动。在这个前提下，两块盖往外分开会被 45° 斜面挡住；前盖靠缝的那头往上翘也会被挡住。
- 两块盖可以连同中间榫一起从托盘上抬下来，不碰托盘，也不碰任何硬件。

## 相对 10/26 终版的改动

- 上壳拆成前盖和后盖，两块都改成顶面朝下打。
- 坡改成 45°，整段归前盖；缝在坡底。
- 后盖顶面和尾段顶面拉平成一个面，托盘底面同样拉平。两处原来各差 0.027 mm，差值加进了充电宝的间隙。
- 删掉内腔里的 45° 填料（haunch）。
- 删掉杖孔上方的尖顶，以及托盘杖口下半边单侧的三角角落。杖孔回到上下对称的正圆。
- 天线扁缝改成三角槽：一面平、贴天线，两面 45°，向下通到杖孔。
- 托盘底边改回原来的圆弧，不再是"先 45° 再圆"。
- 托盘上放板的两条长边台阶，原来底下是 0.6–0.9 mm 的平悬面，现在改成 45° 斜着收回侧壁。增加的料截面不到 1 mm²。
- 新增中间榫。
- PCB 前安装孔：托盘和前盖里的柱子，与杖孔后面那堵墙之间原来只隔一道 0.39 mm 的缝，现在填实。后安装孔的柱子和斜撑接合处原来有个小尖口，现在修平。
- PCB 两个安装孔改成一凸一凹：原来盖子柱底只有一根 Ø0.8、伸进孔 0.6 mm 的小销，托盘柱是平顶。现在托盘柱顶出 Ø1.0 销，穿过整个板孔（2.2 mm）再伸出 1.8 mm，插进盖子柱底 Ø1.3、深 1.8 mm 的孔，销头离孔底 0.2 mm。板子横向滑 0.2 mm 会被销挡住；盖子横向偏 0.3 mm 也会被挡住，所以销同时让托盘和盖子对齐。
- 三根榫的槽改成全长每边留 0.2 mm 间隙，去掉了原来入口那 2 mm 的略紧段（原来大部分长度每边 0.15 mm，入口每边紧 0.02 mm）。

## 与交接分析不同的地方

交接里设想的中间榫是"上边平，下边两道 45° 在缝处收成尖口"。这样做出来，每块盖顶朝下打时，槽顶那道 45° 面的最低边正好落在缝口上。缝口外面是空的，那几层等于凭空起头。

第一次实切确认了这个问题：两块盖的这个槽下各长了约 0.3–0.45 g 支撑，后盖尾端槽附近也有少量。

改成现在的 V 形折条后，每个槽的顶都从槽的远端往缝口方向升高，最低边落在槽远端的竖墙上。重切以后，这几处支撑全部消失，包括尾端那几根。尾端那几根为什么一起消失，没有单独查清。

## 尚未确认

- 没有实打。
- 三根榫留 0.2 mm/面的间隙，打出来是松是紧、会不会自己滑出来，都没有测量。
- 杖口受弯、反复拆装的强度，没有验证。
- 模组插装高度 24.30 mm、IPEX ESP 外形、充电宝尺寸，仍沿用此前的参数。
- 握持舒适度没有真人试过。
- PCB 定位销 Ø1.0 在 Ø1.2 孔里每边只松 0.1 mm；打出来偏粗就插不进，要试打调。销只管定位，不扛力。
