Cheerssom/LingTouchCompanion/hardware/models/3mf/Handle_NewPCB_2026-10-20/research_2026-10-27.md

# 灵触手柄外壳资料核查 — 2026-10-27

本轮仅调查；未运行生成、切片或验证脚本，未改模型、脚本、README 或项目备忘录。唯一写入文件为本文件。时间均为本机 UTC+8。下文的“看到”指本轮直接读取的文件、图纸、原始作者陈述；“计算”指由列明的数据计算；“推断”不等于实物验证。

## 给 Claude 的先读结论

- **A：尚不能认定找到了工厂最终下单文件。** 搜到的最新完整 PCB1_2 原生导出仍为 10/18 16:55 快照；晚间修改只有差异证据，另有内部报表时间为 10/21 的 BOM。不能把文件名中的“10/18”、最新修改时间或 BOM 当成订单版本证明。当前 `build.py` 已补 C33/D3 移位和两个孔，并非完全照搬旧 STEP；但它仍按 **2.204 mm 板厚**，而经理汇总记录的下单方向是 **1.6 mm**。[A1–A5]
- **B：57.15×27.94 有图纸出处，但图纸是板载天线版，不能直接签核选定的 IPEX 载板；ESP 顶部 4.0 mm 未找到整板依据。** 模组 24.30 是 **20.00 本体 + 4.30 排母塑高**的名义叠加，未找到这个模组与该排母配对后的插入深度/就位高度保证。[B1–B5]
- **C：PB503/35338 官网标称 79×38×26 mm；原始卡尺实测 78.66×38.43×26.42 mm。** 当前 79×38.5×26.5 比这一件实测各大 0.34/0.07/0.08 mm；它不是厂家公差包络。圆角半径、接口中心坐标和突出长度未找到尺寸图，不能宣布整机及接线已装配通过。[C1–C5]
- **D：在排除项内，值得继续评估的只有两条路线：渐紧双燕尾横键、单件打印的螺纹横销。** 前者保留当前“横插榫”的操作，但轴向保持靠楔紧摩擦；后者需把局部槽改成相互穿插的闭合销座，再旋紧横销。两者都没有本手柄反复拆装实测，不能称已满足“完全固定死”。普通沙漏换成普通燕尾并不解决滑出；卡口/旋转卡肩等硬限位方案不偷换进候选。[D1–D5]

## A. 找到的是哪版板，和外壳依据相差什么

### A1. 搜索边界与结果

搜索了桌面、下载文件夹及本仓库的工程相关文件名，包括隐藏的 `.pcba-workflow`；核对 STEP/STP、epro/epro2/epru、KiCad、Altium、Gerber/钻孔、工程压缩包和下单/BOM/坐标相关名称。没有读取微信、QQ、Documents、AppData 或明显个人文件内容。依赖/运行环境目录不作为下单资料搜索对象；有少数非工程依赖目录拒绝访问，不能把搜索结果表述为对整台电脑的穷尽证明。

下表是与本次板版次判断有关的文件，不把旧 PCB1_4/PCB1_5、智能眼镜参考工程等混进候选。`R` = `C:/Users/Hsinlung/Desktop/LingTouchCompanion`，`D` = `C:/Users/Hsinlung/Desktop`，`DL` = `C:/Users/Hsinlung/Downloads`；这些缩写下文同用。

| 路径 | 文件修改时间 | 看到的内容 / 能否作为最终板证据 |
|---|---|---|
| `D/Altium_test_2026-10-17/test/V2_9Module_20261017/PCB2.pcbdoc` | 2026-10-17 22:54:18 | 同目录有 `.PrjPcb` 和六页 `.schdoc`；时间早于 10/18 审查快照，不能作为晚间修改后的版本。未据它重新推导当前板几何。 |
| `D/ProPrj_test_2026-10-17/ProPrj_test_2026-10-17.kicad_pcb` | 2026-10-17 23:38:33 | 早期转换文件，不是 10/18 晚间新版。 |
| `D/ProPrj_test_2026-10-18/ProPrj_test_2026-10-18.kicad_pcb` | 2026-10-18 01:13:36 | 同样早于 16:55。`.history` 中的同名备份也是 01:13:36。 |
| `DL/ProPrj_test_2026-10-18.epro` | 2026-10-18 02:15:59 | 实际是 ZIP，含 `project.json`、符号/封装/PCB 等。项目配置中 V2_9Module_20261017 的 PCB 标识为 `3f663a554d6df0a975208361c34174c1`；不能把旧工程同名与后来 PCB1_2 UUID 混为一版。 |
| `DL/ProPrj_test_2026-10-18/ProPrj_test_2026-10-18.kicad_pcb` | 2026-10-18 02:16:24 | 下载目录的转换文件；`.history` 同名备份也是 02:16:24。仍早于 16:55。 |
| `DL/Autorouter_PCB1_2026-10-18.ses` | 2026-10-18 02:26:31 | 仅文件名/时间确认；没有读 SES 内容，也不以它判断晚间最终板。 |
| `DL/Autorouter_PCB2_2026-10-18.dsn` | 2026-10-18 03:54:58 | 路由输入，早于快照；不能代表后来开孔和贴片位置。 |
| `R/.pcba-workflow/pcb1_2-review-20261018/PCB1_2_snapshot.epro2` | 2026-10-18 16:55:45 | 本轮找到的最新完整 PCB1_2 原生快照。ZIP 中 `PCB1_2_review.epru` 的 PCB UUID 为 `b5f51a2d415c68f2`。 |
| `R/.pcba-workflow/pcb1_2-review-20261018/PCB1_2_review_Gerber.zip` | 2026-10-18 16:55:45 | 内部板框 Gerber 自述生成时间 **16:55:44**。含六铜层、钢网、板框、PTH/过孔钻孔等；不含晚间新增两个孔的最终文件证据。 |
| `R/.pcba-workflow/pcb1_2-review-20261018/PCB1_2_review.step` | 2026-10-18 17:11:36 | 外壳使用的 STEP；它的依据仍是 16:55 快照，不能把 STEP 文件的 17:11 当成一次更新板导出。 |
| `R/.pcba-workflow/pcb1_2-recheck-20261018/live-check-evidence.json` | 2026-10-18 20:05:03 | 读取时间 20:01–20:04，含 317 项图元差异。它是修改证据，**不是完整原生板/最终 Gerber**。 |
| `R/.pcba-workflow/pcb1_2-recheck-20261018/live-check.md` | 2026-10-18 20:05:20 | 上述读取的摘要，明确包含当时未保存修改。不能凭它证明修改后来全部进入订单。 |
| `DL/BOM_V2_9Module_20261017_PCB1_2_2026-10-21.xlsx` | 2026-10-25 12:12:25 | ZIP 内 `xl/sharedStrings.xml` 直接读到报表名及 **2026年10月21日 15:51:53**；说明有更晚的 BOM，不能提供板框/孔位/元件坐标。无需把 10/25 的文件修改时间当成板的修改时间。 |

**未找到：**在上述允许位置，没有找到 10/18 20:04 之后、可明确对应 PCB1_2 的新 STEP、完整原生板、Gerber/钻孔配套包、贴片坐标，或能把某一制造压缩包与实际订单绑定的订单附件。本仓库较晚的 CSV 是审查/采购表，不是新增生产导出。下载目录里的 `PCB1_2.epro2` 实际时间为 **8/22 15:13:55**，不是本次 PCB1_2；不应仅按名字选它。[上述文件属性；`R/.pcba-workflow/pcb1_2-manager-20261018/SUMMARY.md`]

**判断（推断）：**能命名的“最新完整本地板资料”是 16:55 快照；能描述的“较晚状态”是 20:04 差异状态；**实际下单的是哪份，现有本地证据没有闭合**。Hsinlung 本轮确认“PCB1_2 已下单、未到”证明订单发生了，不自动证明某份本地文件就是订单附件。

### A2. 板框：没有看到晚间把板子加宽

**看到：**`PCB1_2_review.epru` 的板框是 POLY `42b439beea046bdb`，层 11，坐标为 X `−5055…295 mil`、Y `−2340…−1050 mil`。Gerber 包内 `Gerber_BoardOutlineLayer.GKO` 给出相同四角，单位 mm，X `−128.397…7.493`、Y `−59.436…−26.670`。[A1 中原生 ZIP / Gerber ZIP]

**计算：**板框 **135.890×32.766 mm**。按 `build.py` 的平移 `T=(128.397,43.053,0)`，就是 X `0…135.890`、Y `−16.383…16.383`。与 `BOARD_L=135.89`、`BOARD_W=32.766` 一致。[`build.py:39–41`；上两份原始数据]

**看到：**晚间差异是 LINE 301 项、VIA 10 项、COMPONENT 3 项、FILL 2 项、PAD_NET 1 项，未出现板框 POLY 修改；“加宽”的实证是导线线宽变更。不能把 `SUMMARY.md` 中的“加宽”自行解释为板框变宽。[`live-check-evidence.json` → `physical_changes`；`live-check.md` 第 1–2 项]

**看到 / 精度说明：**保留的 STEP 测量记录 `step-height-recheck.json` 中 Board 边界约为 X `−128.384557…7.480315`、Y `−59.423419…−26.682753`，即 **135.864872×32.740666 mm**，Z `0…2.204140`。当前 `models/pcb_parts.json` 的网格边界也约为这个值。它与制造板框各边约差 0.013 mm；这里应以原生板框/制造轮廓为机械名义值，不能把 STEP 网格边界当作新版板框改变。[`R/.pcba-workflow/pcb1_2-recheck-20261018/step-height-recheck.json`；`models/pcb_parts.json`]

### A3. 两个安装孔：位置有证据；最终钻孔文件未找到

**看到：**晚间新增的是孔层 12 上的两个圆形 FILL：

| 图元 ID | 原始圆路径 | 按 build 坐标换算的中心 mm | 孔径依据 |
|---|---|---|---|
| `8a08118428949267` | `CIRCLE, −5010, −1095, 23.622` | **(1.143, 15.240)** | 路径半径约 0.600 mm；build 取半径 0.6；源码注释记录 Hsinlung 10/21 确认 Ø1.2。 |
| `845a3a28dd9fe12d` | `CIRCLE, 235, −2290, 23.622` | **(134.366, −15.113)** | 同上，名义 **Ø1.2 mm**。 |

来源：`live-check-evidence.json` 对应两个 ID；`build.py` → `EVIDENCE`、`HOLE_IDS`、`HOLES`、`HOLE_RADIUS`；`models/fit_verification.json` → `mounts`。换算式为 X/Y 各乘 0.0254 后加 T，不做额外镜像。

**看到：**旧 STEP/16:55 Gerber 早于新增孔；`build.py:native_references()` 对旧 Board 实体减去这两个圆柱，并使用同一对 HOLES 生成定位柱。因此外壳当前孔位已经跟进这份晚间记录，不能再说“外壳完全没考虑新增孔”。**未找到最终钻孔文件**，所以不能证明工厂确实按这两个孔加工。[`build.py:65–79、190–205、build()` 安装柱段；A1]

### A4. 元件位置、角度和高度

| 项目 | 16:55 / 旧 STEP 对应位置 | 20:04 记录 | 当前 build 是否补正 |
|---|---|---|---|
| C33 | 原生中心 `(−1500,−1785) mil`，角度 0°；build 坐标 **(90.297,−2.286)** | `(−1340,−1700) mil`，−90°；build 坐标 **(94.361,−0.127)** | **已补**。重定位旧网格中心并转 −90°，高度未改。 |
| D3 | `(150,−2240) mil`，0°；build 坐标 **(132.207,−13.843)** | `(225,−1175) mil`，90°；build 坐标 **(134.112,13.208)** | **已补**。转 90°并移到新中心，高度未改。 |
| R11 | `(−2170,−1720) mil`，−90° | 同中心，270° | 几何方向相同，不需要把它当作第三个移位器件。 |
| 其他元件 / 模组排母 / ESP 排母 | 16:55 快照 | 该差异记录中未见其他位置/朝向改变 | build 沿用原位置；这只能覆盖截至 20:04 的记录。 |

来源：直接读取 `live-check-evidence.json` 的三个 COMPONENT 项，与 `PCB1_2_review.epru` 的 Designator ATTR 对照；当前 `build.py:native_references()` 的 C33/D3 专门分支；`models/native_positions.json`。

**看到：**C33 网格为 0.8 mm 高、D3 为 1.31 mm 高，均由旧 STEP 延用。差异记录未列换封装/高度参数，不能据此推断实物供应商尺寸变了，也不能据此证明后续没有改料。[`models/pcb_parts.json`；`live-check-evidence.json`]

**看到：**C75/C80/C76 的通用 STEP 模型高约 7.75 mm；经理汇总专门说明 C75/C80 原厂最大高度约 6 mm。当前壳以原 STEP 元件包络作参考，不能把这些通用模型高度误叫实测高度。[`models/pcb_parts.json`；`R/.pcba-workflow/pcb1_2-manager-20261018/SUMMARY.md` → 旧结论纠正]

### A5. 对安装柱有直接影响的板厚差异

**看到：**`build.py` 设 `PCB_TOP=2.204`；`SUMMARY.md` 写订单方向为六层 **1.6 mm**，并说明 EDA 2.204 mm 叠层不强制制造厚度。本轮没有订单参数单，故 **1.6 仍是已记录的下单要求，未被订单附件再次证实**。[`build.py:39`；`SUMMARY.md` 打样文件段]

**计算（条件明确）：**若实板确为 1.600、板底仍在 Z=0，而壳完全保持当前参数：

- 当前托盘定位销直径 **1.0 mm**，自板底约 **4.004 mm** 长；当前盖子柱底 Z=**2.404 mm**，孔深 1.8 mm。[`build.py` 安装柱段；`models/fit_verification.json` → `mounts`]
- 板顶到盖子柱底的名义空隙将由 **0.200** 变成 **0.804 mm**；销伸出实板顶面由 **1.800** 变成 **2.404 mm**。因此当前报告的“压板余量 0.2 mm”不能直接套给 1.6 mm 实板。[同上；减法计算]

这项是几何差异，不是断裂强度试验。本轮不把“定位销不扛力”的旧说明当作其足够结实的证据，也不提出未经授权的安装柱改模。[`REPORT_2026-10-27.md` → 尚未确认]

### A6. 能交给 Claude 的装入判断边界

**推断：**截至已保留的 20:04 修改记录，未见板框变大，C33/D3 和两孔也已补入 build，因而没有证据要求“因为旧 STEP 所以整个外壳一定装不下”。但最终订单几何、1.6/2.204 板厚、B 节的 IPEX 载板与插接高度尚未闭合，**也没有证据可以确认最新实物整机一定装得下、固定得住**。已有 `models/verification.json` 的 `collisions_mm3=[]` 只说明它记录的那些参考实体未相交，不回答这些参考实体是否等于收到的实物。[A1–A5；B；`models/verification.json`]

## B. ESP 载板和模组插装高度的出处

### B1. 57.15×27.94 从哪来

**看到：**当前 `references/YD-ESP32-S3_Metric.pdf` 与旧 Coaxial 输入是相同 PDF（SHA256 `23098cc8e1195bff1f6040cca85c4e2536a6a7eae21d3bda1c2c2962ec3cbd19`）。本地来源 ZIP 是 `DL/ESP32-S3 资料.zip`，修改时间 2026-04-04 14:46:11；其中有 `PCB尺寸图（mm）.pdf`、mil 版尺寸图、ESP32-S3 原理图、WROOM-1/1U 模组数据手册，未见 STEP/STP。[本轮 ZIP 目录读取；`R/.pcba-workflow/v2-restart-20261017/w2-facts/esp-archive-identity.json` 记录逐字节对应]

**看到：**尺寸图标 **27.94 mm** 宽、**57.15 mm** 载板主体长、两排针中心距 **25.40 mm**、首尾针距 **53.34 mm**、含板载天线伸出总长 **63.39 mm**；图上天线端是 WROOM-1 的 PCB 天线形态，**不是 IPEX 版工程图**。[当前 `references/YD-ESP32-S3_Metric.pdf` p1；本轮核读其保留渲染 `R/.pcba-workflow/v2-restart-20261017/w2-facts/esp-metric-p01.png`]

厂家公开入口：[VCC-GND 官方仓库](https://github.com/vcc-gnd/YD-ESP32-S3)，[硬件资料目录](https://github.com/vcc-gnd/YD-ESP32-S3/tree/main/5-public-YD-ESP32-S3-Hardware%20info)，[V1.4 原理图](https://github.com/vcc-gnd/YD-ESP32-S3/blob/main/5-public-YD-ESP32-S3-Hardware%20info/YD-ESP32-S3-SCH-V1.4.pdf)。本轮读到官方 README 明确以 WROOM-1 / PCB 天线介绍该板。原理图标题为 YD-ESP32-S3-COREBOARD V1.4；本地另有 `R/.pcba-workflow/v2-restart-20261017/w4-circuit/sources/yd-esp32-s3-carrier-original.pdf` 及同名 txt。[厂家仓库；本地原始原理图文本]

**未找到：**能明确与 Hsinlung 选定实物逐一对应的 **IPEX 版载板尺寸图、含 USB 和背面器件的整板 3D 模型、商品 SKU/订单链接、整板高度图**。本地 `decisions.json` 确认选 IPEX 兼容载板，但不是厂商机械证明；现有图纸不能通过“引脚一样”就升级为 IPEX 外形已证实。[`R/.pcba-workflow/v2-restart-20261017/w1-decisions/decisions.json`；`w2-facts/facts.json` 的 ESP-01/ESP-07；本轮公开搜索 `YD-ESP32-S3 IPEX 尺寸图`、`57.15`、厂家硬件目录]

补充：公开搜索出现 IPEX 版销售页，例如 [Robu 的 YD-ESP32-S3-N8R2 IPEX](https://robu.in/product/yd-esp32-s3-n8r2-development-board-ipex/)，但本轮没有取得能闭合上述机械参数的厂家图，且未建立它就是用户所选商品的对应关系；不据它修改尺寸。

### B2. ESP 顶部 4.0 mm 与叠装高度

**看到：**`build.py` 将 ESP 本体建成 57.15×27.94×1.60 的矩形板，再加顶部 4.0 高的盒子；`ESP_TOP_HEIGHT=4.0` 没有附整板高度来源。尺寸图是俯视图，没有侧视高度。因此 **4.0 是模型假设，尚不是查证到的厂家整板最大高度**。[`build.py:17–19、220–226`；B1 尺寸图]

**看到：**8.50 mm 排母塑高有旧原厂图出处：`R/.pcba-workflow/evidence/preroute/mechanical/inputs/C2886702-exact-header.pdf`，图纸品名 CS-1165SDIG-1*22，H=8.5±0.20；本轮核读其保留图 `w2-facts/donor-esp-socket-p01.png`。这证明那个型号的标称值，不证明用户手上的排母已实测相同。当前 build 另加公针隔块 2.50 mm 和载板厚 1.60 mm；本轮未找到二者在所选 IPEX 实物上的最大叠装高度依据。[该图；`build.py:18`]

**计算：**按当前模型，ESP 板底 Z=**13.204**，板顶 **14.804**，顶部参考盒最高 **18.804**；握持段内顶 **19.154**，名义顶隙 **0.350 mm**。这个结论完全依赖 2.204/8.50/2.50/1.60/4.0 这些输入；不能把“碰撞为零”当成对未知 4.0 高度假设的验证。[`build.py:39–47、220–226`]

### B3. 模组本体 20 mm 有供应商图

**看到：**`references/Braille_Module_Reference.pdf` p2 标本体从底座下沿到固定顶面 **20 mm**，顶上触点凸起 **0.4–0.5 mm**，底座以下端子伸长 **3.8 mm**，正面宽 **8.2 mm**、底座跨距 **10.82 mm**；p3 给侧宽 **6 mm**；p4–5 给扁端子 0.10 厚、0.30 宽、1.25 节距。[该 PDF pp2–5；本轮核读 `w2-facts/module-p02…05.png`]

当前 PDF 与 `R/BrailleModule_Video/inputs/Braille_Module_Reference.pdf` 本轮计算 SHA256 相同：`1023de23891d9c1ee49d44fdf72487f79399e4074987c87cec90a39941b0b1b0`。所以这些保留渲染对应的供应商原件确实与当前引用是同一份，不是借用排母占位件的尺寸。[本轮哈希；`w2-facts/render_pdf_evidence.py` 的来源清单]

### B4. HX PM1.27-1x6P ZC 规格书

准确料号 **HX PM1.27-1x6P ZC / C22438072**，不要混用 H3.4/H2.0 等带后缀型号。[JLC 型号页](https://jlcpcb.com/partdetail/hanxia-HX_PM1_27_1x6PZC/C22438072)

本地已保存厂家七页规格：`R/.pcba-workflow/v2-restart-20261017/w5-sourcing2/C22438072-signed.pdf`；本轮查看其 p1–7 保留渲染，重点 p1 工程图、p4 插拔力。可从 [JLC 型号页](https://jlcpcb.com/partdetail/hanxia-HX_PM1_27_1x6PZC/C22438072) 的 Datasheet 重新取得；旧 LCSC PDF 入口为 [C22438072 手册](https://www.lcsc.com/datasheet/lcsc_datasheet_2405221101_hanxia-HX-PM1-27-1x6P-ZC_C22438072.pdf)，本轮以已经留存的厂家 PDF 图为依据，不把过期签名下载 URL 抄作长期出处。

| 项目 | 看到的规格 | 来源 |
|---|---|---|
| 排母塑胶本体高 | **4.30±0.15 mm** | p1 工程图；JLC 页面 Insulation Height 4.3 mm |
| 本体宽 | 2.10±0.15 mm | p1 |
| 六针本体长 | B+0.4=**8.02±0.30 mm**，B=7.62 | p1 尺寸表 |
| 自身焊尾长 | **2.40±0.20 mm** | p1；这是排母焊到主板下面的尾巴，**不是模组插入深度**。 |
| 自身焊尾截面 | 0.45×0.15 mm | p1；不是插口宽/适配扁片范围。 |
| 节距 | 1.27 mm，工程图标 ±0.1 | p1 |
| 插入力 / 拔出力 | ≤3 N/针、≥0.5 N/针 | p4 §6.3/6.4；未给本模组扁片配对的测试规尺寸。 |
| 端子固定力 | ≥10 N/针 | p4 §6.1/6.2；不能解释成模组插拔力。 |
| 模组插入深度、底座到排母顶面的就位间隙 | **未找到** | p1 未标对插深度；p2–7 也未给出本模组配对尺寸或配合高度。 |

### B5. 24.30 的实际证据等级

**计算：**`20.00 + 4.30 = 24.30 mm`，正好对应 build 的 `MODULE_SEATED_HEIGHT`。但这个算式隐含“模组底座下沿正好落在排母塑胶顶面、无额外悬空/机械干涉”的条件；图纸并没有给这个配对条件的合格声明。只能说找到了该数值的名义组成，不能说找到了 24.30 的装配实测。[B3、B4；`build.py:15–16`]

**看到：**build 把模组固定顶面放到 `FACE=PCB_TOP+24.30=26.504 mm`；其开窗使用名义排母高 4.30，而排母实体包络另用 4.45 最大高。24.30 指向固定壳体顶面，触点动作凸高 0.4–0.5 不应混入本体 20 后再次重复计算。[`build.py:native_references()`、开窗段；B3]

**未知：**实际插到底时的底座位置、焊接站高、配对尺寸公差。现有 `references/PCB1_2_module_socket_measurements.json` 只做 PCB 平面节距与本体布置核对，其 `limits` 明确没有实测开口/扁片夹持/焊后装配位置；它不提供 Z 向插深。[该 JSON；厂家图]

**给 Claude：**可继续使用“20+4.30”作为有条件的名义参考，不能写成“24.30 已确认”；也不能擅自把 3.8 mm 模组针长或 2.4 mm 排母焊尾长度减入这个算式来伪造已知插深。[B3–B5]

## C. 绿联 PB503 / 35338 外形核查

### C1. 型号与长宽厚

| 来源 | 看到的型号 / 数值 | 证据性质 |
|---|---|---|
| [绿联中国官网 PB503](https://www.lulian.cn/product/1035.html) | 型号 PB503，胶囊直插款，带折叠支架；有京东/天猫购买入口 | 厂家型号与外观来源，不与自带线 PB506 混用。 |
| [绿联美国官网对应产品](https://us.ugreen.com/products/ugreen-mini-power-bank-5000mah-22-5w-2ports) | 参数 Dimensions **79×38×26 mm**；图片也标同一尺寸 | 厂家标称值。这里不是 38.5×26.5 的依据。 |
| 官网链接的 [京东商品](https://item.jd.com/100103754007.html) / [天猫商品](https://detail.tmall.com/item.htm?id=791372879864) | 本轮实际点击官网跳转得到的商品 ID | 京东仅返回浏览器提示，天猫无可读参数；未取得独立官方店尺寸图，不能说已由店铺再次证实。 |
| [厂家品牌资料 PDF 镜像：PB503 35338](https://manuals.plus/m/c5631b6b946bdb79f2bdebeeb182589930c2869a33f27beac8d10c35418e4a20.pdf) | 型号 PB503/35338，尺寸 L79×W38×H26 | 厂家品牌产品单页的第三方托管副本；不是含公差、接口坐标的机械图，也不冒充从官网取得的正式安装说明书。 |
| [充电头网原始拆解/卡尺测量](https://www.chongdiantou.com/archives/401211.html) | **78.66×38.43×26.42 mm**；顶部直插 USB-C、侧面 USB-C 母口 | 原作者对一件实物的观察/测量，2024-12-19。不是批次最大包络。 |

### C2. 与模型的差别

**看到：**当前 build 使用 **79×38.5×26.5**，参考实体是轴向矩形盒，未建 PB503 的 USB-C 公头、胶盖、侧面插头/线缆、按钮及支架运动包络；`CONNECTOR_GAP=13.5` 只是板尾至充电宝前端的空间参数。[`build.py:20–21、native_references()` 的 `PB503` 盒；`references/power_bank_screen.md`]

**计算：**与官网标称相比，模型多 **0 / 0.5 / 0.5 mm**；与原始实测相比，多 **0.34 / 0.07 / 0.08 mm**。故这组数不是凭空离谱，但也不是官方最大尺寸或“已留够制造公差”的证明。[C1；`build.py`]

**出处追溯的限度：**旧 `references/power_bank_screen.md` 同时链接官网 79×38×26 和这篇原始测量；目前未找到一条本地说明明确写“为什么最终取 38.5/26.5”。“向上取到半毫米”只是与数值一致的推断，不把它写成当时作者已说明的事实。[该 md；`build.py`]

### C3. 圆角与 C 口位置

**看到：**厂家产品图和原始外观记录支持圆角机身、顶部直插 C 公头带胶盖、侧面 C 母口、背面折叠支架。原始作者对顶部/侧面接口分别有近照。[中国官网；原始拆解“外观”段]

**未找到：**圆角 R 数值、胶盖外形公差、公头突出长度、侧面母口中心距任意基准边的 X/Y/Z 数值、插头外壳与弯线所需净空间、官方 STEP。查过中国/美国官网、官网跳转京东/天猫、PB503/35338 说明书/产品 PDF 搜索及原始拆解。照片可确定在哪个面，不能可靠地量成机械坐标。[C1 的网页/镜像；本轮检索 `PB503 manual dimensions 79`、`PB503 35338 尺寸`]

**推断：**矩形盒可用于保守检查机身主体包络；它没有检查接口接线。当前只可说 **主体名义尺寸与已找到资料相符，整机装配尚不能确认**，不宜据此让 Hsinlung 直接购买后认定必然合壳。[C1–C3；A/B 尚未闭合条件]

## D. 可反复拆卸且不自行滑出的横插连接

### D1. 当前失效点与筛选标准

**看到：**当前前/后榫是等截面沙漏，长约 **39.17/46.00 mm**、高 **7.0 mm**；槽全长每面放 **0.2 mm**，源码明确 `nothing is tight`，报告也写沿插入方向没有东西挡着。中间 V 榫同样放间隙。沙漏/双燕尾截面挡的是垂直于插入轴的两壳分离，不能从几何上挡住沿原路滑出。[`build.py:TENON_CLEAR、pin_spec、pin_cut`；`REPORT_2026-10-27.md` → 三根榫]

**推断：**仅将沙漏改名“双燕尾”、加大总长或重复拷贝第三根榫，都不增加轴向保持机制。必须明确依赖的是楔紧摩擦还是可主动解除的螺纹约束；不能又声称全长自由滑动，又声称无任何额外机制却自己不会掉。[上段几何；D2/D3 的公开实例]

以下只保留 **一个独立打印连接件、可横向装入两壳、无需外购销/木棍/弹片等**的路线。这里的“候选”表示可以在该手柄的局部连接区域继续设计；**没有任何一个现成 STL 已被证明可直接替换当前三根榫**。需要改槽的地方明写，不包装成只换榫就行。

### D2. 候选一：沿插入方向渐紧的双燕尾横键 / tapered dovetail spline

**它是什么（推断，基于实例机制）：**保留独立沙漏/双燕尾横键，两个壳各有一半燕尾槽，但沿横插方向引入连续、小幅渐紧的配合；入口容易进，接近最终位置才压紧两侧宽面。它不是加压筋、劈缝、弹片或在槽尾加硬挡块。[实例 1、2；与当前 `pin_spec/pin_cut` 几何对照]

| 必答项 | 判断及依据 |
|---|---|
| 靠什么阻止轴向滑出 | **靠楔面预紧产生的静摩擦**；双燕尾负责两壳分离方向，渐紧负责轴向保持。不是“纯形状绝对锁住”。若最后仍保留全长每面 0.2 的自由间隙，就没有这个效果。推断依据：下列作者描述的 progressively tighter / wedged fit；当前脚本间隙。 |
| 怎么拆 | 从装入侧反向拉出/从贯通另一端推出，先解除末段楔紧，余程即可滑动；不需要把倒钩折过槽口。应保留可接触两端的条件，当前前后榫两端各露出 1 mm，已有操作位置。后一句是当前报告事实；具体拔出力未测。 |
| PLA / 零支撑 | 已有 PLA 渐紧燕尾实打案例。横键本身可按当前宽平面贴床、将侧面做自支撑斜面；**零支撑是可设计目标，不是本轮切片结论**。当前旧榫零支撑结果不能转移到新渐紧几何。[实例 2；当前 `REPORT` 支撑表] |
| 反复拆装会不会磨松 | **未找到与本手柄尺度、PLA、插拔方向相同的循环寿命/保持力数据，未知。** 若少量接触尺寸变化，渐紧结构在原理上可通过稍深就位补偿；这只是几何推断，不是无限寿命承诺。不能给出“拆 N 次也不会松”的数字。 |
| 能不能用在此手柄 | 适合作为最接近现有结构的候选：独立横插件、无外购件，不必在壳上长出细销。前/后所在区域已有横通槽；中间 V 键也可研究轴向渐紧，但不能据名称假定它与直双燕尾完全同样受力。[`build.py`、`REPORT` 榫位置表] |
| 满足“完全固定死”了吗 | **尚未证明。** 它有明确轴向保持机制，优于自由滑键；但仍靠摩擦，不能把“楔紧”宣传成无条件的防脱锁。也不能把它做成只能砸入、无法徒手退出的永久过盈件来冒充可反复拆卸。 |

**真实例子，证据分级：**

1. [40 oz 可拆水瓶架，作者 jimrowley83](https://www.thingiverse.com/thing:7416331)：作者描述渐紧燕尾越插越紧、减少晃动、可反向滑出；实打使用 **ASA、0.6 喷嘴、无支撑**，不能偷换为 PLA 实测。[本轮可读的作者说明镜像](https://www.3dgo.app/models/thingiverse/7416331)。这是可拆渐紧机制例子，不是横插盲杖已验证。
2. [Nespresso 六槽底座，作者 pjvenda](https://www.printables.com/model/873782-custom-nespresso-capsule-dispenser-mod-6-wide-sock)：作者原文说明分件以渐紧燕尾连接、0.05 mm tolerance、实际不用胶即可；页面打印资料为 **PLA、0.4 喷嘴、0.15 层高**。这证明 PLA 可做出渐紧配合，**不能照抄 0.05 到当前每面间隙**，也没有反复拆卸寿命数据。来源为本轮搜索索引读到的作者页面，直接打开全文返回 400，证据限度保留。
3. [Dovetail taper Mount，作者 Jack](https://www.printables.com/model/596459-dovetail-taper-mount)：作者称 tight fit tapered dovetail rails，提供可 remix 模型；**本轮未取得同尺度循环试验或清晰实打证据**，只作结构参考，不能叫已验证防脱件。

### D3. 候选二：横插后旋紧的一体螺纹销 / printed threaded cross-pin

**它是什么（推断，基于螺纹连接实例）：**一个独立打印件包含手拧头、承剪光杆和末端粗螺纹。两块壳在局部形成交错的闭合销座；横销穿过它们，末端旋入其中一块壳的成型内螺纹，拧紧后夹紧座面。内螺纹直接属于壳，不另增螺母或金属件。这属于可拆销连接，不是保留原槽、把现有沙漏表面刻几圈牙。[下列实例；当前槽几何]

| 必答项 | 判断及依据 |
|---|---|
| 靠什么阻止轴向滑出 | **螺纹啮合阻止销直接沿轴拔出**；旋紧形成的夹紧力消除销座接触面的游隙。光杆穿过两壳的闭合交错座承担壳间分离约束。若只把圆销放在上下各半个圆槽中，两壳仍可分开，不能那样实现。[几何推断；实例螺纹机制] |
| 怎么拆 | 反向旋松，螺纹完全退出后横向抽销；可反复使用，不是切削自攻螺钉每次重新割塑料。 |
| PLA / 零支撑 | 作者已有可打印粗牙螺栓/螺母、无需支撑的模型。销可头部贴床、轴竖直；可选自支撑粗牙，而不是默认很细的标准牙。**PLA 在本手柄所需细径、约 40–46 长横销上的强度和拓竹默认自动支撑结果没有实测**，不能用大号展示螺栓代证。壳内水平螺纹/销座也必须单独评估打印姿态，本轮没有切片。[实例 1、2；`REPORT` 当前尺寸] |
| 反复拆装会不会磨松 | **未取得对应尺寸的 PLA 循环数据，未知。** 螺纹可重复旋紧是机构功能；这不等于牙面永不磨损，也不等于有防振认证。这里不编造寿命或自行添加螺纹胶。 |
| 能不能用在此手柄 | **可供选的局部槽重做路线，不能只换现有榫。** 前榫区位于杖孔终点后、PCB 前；后榫区位于充电宝后，均有横向贯通连接位置。应利用这些位置布置粗短交错座，不能侵入硬件包络。[`build.py` 杖孔范围、前/后榫中心、`PB_X/PB_LENGTH`；D4 尺度计算] |
| 代价 | 操作从“推拉”变成“旋几圈再抽”；与渐紧横键相比需较大局部改槽，且新内螺纹打印尚未确认。**如果坚持原沙漏槽完全不动，这项不成立。** |

**真实例子，证据分级：**

1. [Standard & Reverse Threaded Nut & Bolt，作者 Madaco](https://www.printables.com/model/1212149-standard-reverse-threaded-nut-bolt)：作者提供实际可旋合的打印螺纹模型，描述无需支撑；全长约 87 mm，并自称展示/玩具。它只证明打印螺纹和拆装动作，不证明本手柄销座强度；本轮直接页面打开受限，依据作者页面搜索索引。
2. [Coroplast Screw](https://www.thingiverse.com/thing:4823784)：作者把它用于瓦楞塑料板的可旋合连接，明确 PLA 可打印、两端做平以便不用支撑。[可读的作者说明镜像](https://3dgo.app/models/thingiverse/4823784)。这个例子自身是两件式，**不照搬两件数量**；在本手柄中把其内螺纹功能并入壳是上面的适配推断。
3. [A Practical Guide to 3D Printing for Chemistry and Biology Laboratories](https://onlinelibrary.wiley.com/doi/pdfdirect/10.1002/cpz1.70036) 的多件装配部分给出打印螺纹实作，并指出它们实验条件下不推荐小于 10 mm 的打印外螺纹、小于 8 mm 的内螺纹。**这不是通用强制尺寸下限**；它说明不能把该文的大尺寸成功直接当成本项目细销已验证。本轮没有据此给手柄强塞 10 mm 螺栓。

### D4. 不夸大“放得下”的局部尺度核对

**计算：**前杖孔终点是 `FRONT+CANE_INSERTION=−8.0`，前腔起点 `−0.35`，中间实体轴向跨度 **7.65 mm**；前榫中心 X≈**−4.175**。充电宝尾 X=**228.39**，外壳尾 X=**236.89**，尾部轴向跨度 **8.50 mm**，后榫中心约 **232.815**。[`build.py` 常量及 `pin_spec()`]

**推断：**这支持在原前/后连接位置研究几毫米尺度的横键/横销；**不支持直接照搬 10–20 mm 门锁或大螺纹**。螺纹销还要给销座周围留实体厚度，不能把上述跨度全部占成销径；本轮没有新几何，故没有一个已确认的最终销径/牙距。中间榫在 X≈61.516、Z=5…14、板上方，现有参考器件在该处至约 Z=4.105；这说明有现成连接区域，不证明任意新机构可旋转或穿过。[`build.py` 中间榫常量和注释；`REPORT`]

### D5. 不列入给 Hsinlung 挑的其它类型

| 搜到的类别 | 本手柄为何不列入主候选 |
|---|---|
| 等截面普通燕尾、沙漏、T 槽滑键、V 键 | 仍保留沿插入方向的退出自由度；这正是当前已观察到的问题。[当前 `build.py`、`REPORT`] |
| 四分之一转卡口、T 头旋转卡肩销 | 轴向防脱依赖转到卡肩后的刚性阻挡，落在本轮“硬止挡”排除边界内，不换名字重新推荐。确有打印应用，例如 [Prusa 的 PETG PSU Lock](https://www.prusa3d.com/de/produkt/psu-lock/)，但本轮不作为候选。 |
| 普通偏心凸轮压扣 | [作者 Andrei 的凸轮袋夹](https://www.printables.com/model/27216-bag-clip-print-in-place-cam) 是真实 PLA 凸轮夹紧案例，但为多个铰接构件、含少量支撑；本轮没有找到满足“一个独立横插件、两壳槽、无硬挡/弹片”的同尺度成品，因此不把它伪装成第三个已可用横榫方案。[作者原始展示](https://www.reddit.com/r/3Dprinting/comments/fpy75z/) |
| 门柜压缩旋转锁 | 搜到的 [Quarter-turn latch](https://makerworld.com/en/models/3070853) 原作者方案要 20 mm 主孔、四个打印件和三颗螺钉，靠重力维持关闭；与本手柄尺度、件数和任意倾斜条件不符。[作者说明可读镜像](https://www.3dgo.app/models/makerworld/3070853) |
| 打入后再横穿第二楔/第二销的锁键 | 需要第二个保持件；若仍是自由滑的第二销，又重复当前问题。不符合本轮“单独一个零件”的筛选条件。 |
| 磁吸保留横键 | 本轮未找到不增加独立磁体/额外采购、又符合所述全打印单件条件的实例，不列。 |
| 其它已否项目 | 弹片、倒钩、劈缝、压筋、外购钢销、竹签木棍、壳上一体凸起细销、直方条、永久过盈/胶粘均按本轮原话排除，不做备选复活。 |

**给 Claude 的选择呈现建议（推断，不是替 Hsinlung 定案）：**只展示“推紧后反向拔出的渐紧双燕尾横键”与“旋紧、旋松再抽出的螺纹横销”两种操作。前者最接近现有使用方式，后者的轴向保持更明确但要重做局部槽/销座。应同时说明两者都尚未在这个壳上实打；如果要求有实证证明“不拆时固定、长期反复拆仍不松”，本轮找到的资料不足以把任何一种签成已满足。

## 核对与复用索引

本轮对 A 的结论主要来自原始导出、原始差异 JSON 与当前源码；没有把历史经理结论当作新 CAD 读取。B 的图纸通过既有 PNG 核读，未生成新图或安装依赖；两份当前 PDF 的哈希如 B1/B3。C/D 的公开资料把厂家、原作者、镜像和搜索索引访问限制分别标明，未把宣传“self-locking”直接当成沿插入轴已防脱。

关键文件 SHA256（本轮重算）：

- `PCB1_2_review.step`：`142a1a8318d4d0ab775b2379cd5d0310eadcb633db745d7d33cd97ecf02daf72`。
- 当前 `references/YD-ESP32-S3_Metric.pdf`：`23098cc8e1195bff1f6040cca85c4e2536a6a7eae21d3bda1c2c2962ec3cbd19`。
- 当前 `references/Braille_Module_Reference.pdf`：`1023de23891d9c1ee49d44fdf72487f79399e4074987c87cec90a39941b0b1b0`。

没有建立的新事实：最终下单包身份、最终孔径制造记录、选定 IPEX 载板完整机械包络、实际模组就位高度、PB503 接口精确坐标、任何候选榫的本手柄拆装寿命。这些项目均不能从本报告中的名义计算或别人做过的例子自动补成“已验证”。
