Cheerssom/LingTouchCompanion/hardware/models/3mf/Handle_NewPCB_2026-10-20/research_tenon_2026-10-27.md

# 手柄可拆榫重新调查（2026-10-27）

## 结论与证据边界

**本轮找到、且能说明完整满足 Hsinlung 标准的现成结构：0 种。** 这不等于证明这种连接不存在；是所查资料中，没有找到同时解决“锁住上下壳”和“榫自己的解锁动作不会自行发生”、又适合本手柄空间的实例。下面的图源是调查和淘汰记录，**不是让 Hsinlung 从不合格方案里挑选的候选清单**。

最接近的机制是**旋转钥匙式榫**：非圆榫头穿过入口，转动后由肩面挡住直拔。但“转后不能直拔”还缺一项：锁定位置为什么不会自行转回入口角度。查到的打印接头用紧配合或磁铁保持这个状态；查到明确防反转的旋转家具榫，用了弹臂定位件。因此，本轮不能把它们报告为已经满足要求。出处见第 3 节各原作者资料。

**推断：** 对目前“两块壳保持装合、一个独立榫横插”的安排，单纯直进直出的榫必然留下原路退出的通道；把通道改成折线，也必须检查第一步能不能由重力或推拉完成。需要的是**平常外力不能启动的特定解锁动作**，旋转是一个方向，但不是充分条件。本轮没有证明“所有可拆榫只能旋转”，也没有证明“只要能旋转就一定会被震开”。依据：本地直通槽几何，以及下述旋转榫与定位件的实例。

本轮只读资料和计算尺寸，没有运行建模、切片、渲染或修改脚本；唯一新增文件是本文件。没有继续 PCB、ESP 或充电宝的调查，也没有专门研究中间榫。

## 1. 本轮采用的标准

需求来源：Hsinlung 本轮原话及他认可的说明，而非上一份研究的 D 节。

- 上下两块壳各挖槽，插入一个单独打印的榫，用形状连接；前、后两处能反复拆装。
- 装好后，任意姿态重力、推拉榫任一端、握持挤压、甩动及敲地冲击和振动，都不能构成它的拆卸动作。
- 必须逐一交代：哪些面挡住往两头退出；特定拆法是什么；锁定状态下，第一步为什么不能由上述普通外力启动。不能只说“通常不会”。
- 不靠摩擦；不使用螺丝/螺纹/螺帽、弹片/倒钩/劈缝/卡扣舌、过盈/压筋/渐紧楔紧、外购销、竹签、磁铁、胶、壳上凸起销或直方条。
- **刚性肩面可以挡路。** 本轮没有沿用上一轮把硬止挡一概排除的错误筛法。但只挡住继续转动的终点，不自动等于挡住反向解锁。
- “反复拆装不会磨松”不凭材料名称猜测：本轮没找到适配结构的循环数据，不能给出寿命次数。

## 2. 这两处实际有多少空间

### 2.1 看到的：当前代码与文档

坐标沿用 `build.py`：X 从杖口到尾部，Y 横向，Z 为上下方向。前、后榫沿 Y 插入；托盘与盖子在两处的分缝均为 **Z=0**，不是截面高度的中线。来源：[build.py](build.py:255) 的 `pin_spec`、`pin_profile`、`pin_cut` 和 [build.py](build.py:308) 的上下壳分割。

| 项目 | 前榫 | 后榫 | 出处/性质 |
|---|---:|---:|---|
| 可用 X 段 | −8.00～−0.35，长 7.65 mm | 228.39～236.89，长 8.50 mm | 代码参数计算：`FRONT+CANE_INSERTION`、`FRONT_CAVITY_START`、`PB_X+PB_LENGTH`、`TAIL` |
| 当前榫中心 X | −4.175 | 232.815 | `pin_spec` |
| 分缝 Z | 0 | 0 | `build` 的 `low`/`up` |
| 截面外轮廓宽 Y | 约 37.17 | 44.00 | `section_params` 在各榫中心的名义参数；前段有圆角，Z=0 的实际宽略小 |
| 截面外轮廓 Z 范围 | −10.50～24.590 | −10.50～21.554 | 同上，参数计算 |
| 分缝下/上高度 | 10.50 / 24.590 | 10.50 / 21.554 | 同上；明显不对称 |
| 原榫端宽 / 腰宽 / Z 高 | 4.45 / 2.85 / 7.00 | 4.95 / 3.35 / 7.00 | `pin_spec`、`pin_profile`；单位 mm |
| 原榫长 | 39.17 | 46.00 | `pin_spec`；各比外轮廓宽多 2 mm |
| 原槽配合 | 全长每面放大 0.20 mm | 同左 | `TENON_CLEAR`、`pin_cut` |

来源：[build.py](build.py:14)、[build.py](build.py:121)、[build.py](build.py:255)；原榫尺寸也见 [REPORT_2026-10-27.md](REPORT_2026-10-27.md)“三根榫”。上表是读公式计算的名义几何，不是实物测量或新模型验证。

**后段不是一整块实料。** `build` 把内腔一直减到 `TAIL+3`；尾口敞开。后榫横跨中间空腔，在分缝处主要靠左右侧壁接榫。该处外宽 44、内宽 39.2，Z=0 处每侧壁厚 **2.40 mm**；内腔 Z 为 −8.10～19.154。不能把整块 44×32.054 的外包络当作可以随意挖复杂锁腔的实体。来源：[build.py](build.py:130)、[build.py](build.py:308)；[README.md](README.md) 的尾口说明与 [尾口图](renders/15_tail_open.png)。

前段在杖孔底 X=−8 与内腔起点 −0.35 之间有实体隔墙；它的 X 长度只有 7.65 mm。来源：[build.py](build.py:308)、[REPORT_2026-10-27.md](REPORT_2026-10-27.md) 的杖口/前榫说明。

### 2.2 推断：对结构筛选的具体影响

- 传统大木梁的“上下整块互相错动，再插栓”不能直接缩成这一处横插榫：需要重新证明盖子、托盘、PCB 定位与两个连接点能共同完成该动作；本轮没有这样的适配证据。依据：本地 `build` 的分壳、PCB 定位柱及两个榫位置。
- 不能把现有沙漏榫原样改成“转一下”：绕 Y 轴转动时，原前榫 XZ 截面的外接圆直径为 `sqrt(4.45²+7²)=8.30 mm`，已大于前段 7.65 mm 的 X 空间。这里只否定**原截面原位旋转**，不否定重新设计更小旋转榫。依据：上表尺寸和截面顶点；未生成新几何。
- 后部的旋转榫若需要完整环形锁腔，必须交代两片 2.4 mm 侧壁如何形成、容纳这个腔；不能只画一个悬在尾部空腔里的锁。依据：上述后段内外截面。

### 2.3 打印与反复拆装

**看到的：** 当前托盘底面贴床、前后盖顶面朝下、榫单独打印。当前沙漏榫和槽在报告中的拓竹默认自动支撑结果为零支撑；托盘底边与前盖杖口处另有已记录支撑。设置是 H2C、PLA Basic、0.4 mm 喷嘴、0.20 mm Standard、tree(auto)、30°。来源：[README.md](README.md)、[REPORT_2026-10-27.md](REPORT_2026-10-27.md)“支撑”。

**推断：** 新旋转腔的槽顶、装配入口与桥接方式改变后，旧切片结果不能沿用。下文找到一个 PLA 无支撑旋转接头实打例子，但它依靠紧配合，不能同时证明本题锁定成立。没有合格候选，故本轮没有“某个合格榫在指定姿态下默认零支撑”的结论；也没有反复拆装不磨松的数据。没有据此虚构断裂或磨损风险。

## 3. 最接近要求的图源与淘汰原因

### 3.1 旋转钥匙式榫：直拔被挡住，但还缺锁定角度的保持

**看到的：** 北京林业大学的 [CN201650964U《快装自锁榫卯结构》](https://patents.google.com/patent/CN201650964U/zh) 提供榫头、卯眼和装配附图；图 6～8 对照插入及转过 90°。扁平止退榫进入口小内大的孔，转后挡住抽出。文字中的定位块限制“继续旋转”；实施例的定位块是金属钉。资料没有说明同一定位块阻止逆向转回。

**拆法及推断：** 转回入口方向再抽出。刚性肩面能挡轴向拉力；单纯轴向推拉也不等于主动拧转，这是它比直槽更接近要求的地方。但该实例没有给出禁止反向解锁的形状约束，不能把“限转到位”理解成“反转也被锁”。而且原结构是构件上的凸榫，并非本手柄的一根独立横插榫。故不计入合格候选。未见 PLA 或本手柄尺寸的实打记录。

**看到的：** [CN206000826U《一种旋转榫卯结构及家具》](https://patents.google.com/patent/CN206000826U/zh)，图 1～4，有旋扣后专门限制反向转动的定位件；该实施例定位件含弹臂与卡入孔的凸起。

**拆法及推断：** 先解除并取出定位件，再反转旋扣，最后抽出。它明确补了“防反转”这一环，但用了本轮禁止的弹性定位，而且增加另一活动件；不能作为合格方案。不能擅自把定位件改成松插刚性栓，再宣称解决了问题——那会重新出现“栓自己怎么不出来”。

这两份专利有清楚线图，**是结构披露，不是本手柄实物验证**；标题里的“自锁”不作为通过依据。

### 3.2 真正打印过的旋转接头：PLA 无支撑有例子，形状锁定仍不完整

**看到的：** 原作者发布的 [Modular Twist-Lock Connectors — No Supports Needed](https://www.reddit.com/r/3Dprinting/comments/k0ti8a/) 有展示图/视频及制作讨论。作者说明使用 PLA、Ultimaker 3，平整面朝下、连接面朝上，无支撑打印；关于转动保持，作者明确说试件靠配合够紧保持。后续 [更新帖](https://www.reddit.com/r/3Dprinting/comments/k5aj8y/) 加了阻止转过头的止挡。

**拆法及推断：** 反转到入口角度，再抽开。连接肩挡直拔；紧配合承担角度保持，止挡只限制继续转过头，未说明阻断逆转。依靠摩擦被本轮直接排除。这个例子只能证明“某种小型旋转接头能用 PLA 无支撑打印”，不能证明改在本手柄壳槽里仍然如此，也不能证明不磨松。

**看到的：** 原设计方 [NERDLOCK](https://www.nerdabstract.com/nerdlock/) 有 H 型三凸耳旋转接头及 R 型闭环轨道的线图。H 型转 60°，由两半中的磁铁保持锁定；R 型需滑到出口再转，但停靠站也用磁铁和定位结构保持。

**推断：** 它没有满足“纯靠形状、无磁铁”的前提；不能只截取旋转/轨道外形，省略资料明确写出的保持机构。故淘汰，不作为实际候选，也不把网页宣传当循环寿命证据。

### 3.3 旋转三柱鲁班锁 / Wyatt 三件互锁：有转动拆法，但未证明适配两片薄壳

**看到的：** [IBM Research 榫锁资料存档 PDF，第 10 页](https://www.cs.brandeis.edu/~storer/JimPuzzles/BURR/000BURR/READING/IbmPage.pdf#page=10)，标题 “Wyatt's three-piece burr”，有部件图与转动说明：一根杆的缺口留下圆柱段，允许转动，给另两根杆让出装配空间。这是带转动的具体版本，不能推广成“所有三柱鲁班锁都能转”。

**看到的：** [Nature Architects 原作者制作记录](https://nature-architects.com/en/blog/2363/) 有三件木锁 CAD、FDM 打印照片及另一个 Osanori Yamamoto 设计的打印照片。必须注意：作者最初复制的那套锁没有成功拆解，怀疑原设计存在问题；不能拿这张打印照片充当“已验证可拆且不自行脱落”的证据。[Printables 的 Three Piece Burr Puzzle](https://www.printables.com/model/1089911-three-piece-burr-puzzle) 搜索索引有作者模型条目，但本轮正文读取失败，未核实其打印设置与动作。

**拆法及推断：** Wyatt 型需要转动一杆、使让位区对齐，再移动相交杆件。它有真正的形状互锁与特殊动作，值得用来理解原理。但来源所示是三根相交的实体杆，不是“已装合的上下薄壳不动，只动一根横榫”；没有给出嵌入本地前端 7.65 mm 隔墙、后端两片 2.4 mm 壁的对应关系，也没有足够的运动约束说明，可以证明在本题的全部普通载荷下不能启动解锁。不能直接列为本手柄候选。这里的缺口是**适配及完整拆法未建立**，不是已经证实这种鲁班锁一甩就散。

## 4. 其余方向：为什么不列为候选

| 查到的结构与图源 | 看到的事实 | 本轮判断（推断） |
|---|---|---|
| 走马销；王佳实等《榫卯中的自锁奥秘与设计创新》，《林产工业》2021(9)，[作者论文内容转载，图 1](https://www.jxcat.com/mobile/articles/17936) | 文中明确描述从大口滑向小口挤紧，退回大口拆卸 | 保持依赖挤紧，第一步仍为推回，违反本轮标准；不是新的候选。这里引用的是原作者论文的转载，未把转载站当实验机构。 |
| 银锭榫、楔钉榫；[同一论文转载，图 3](https://www.jxcat.com/mobile/articles/17936) | 外插件阻止主体分离；文中还借助木材贴合特性 | 没有交代外插件自身沿插入轴的形状防退；不能把“钉住两件”当成“楔钉自己不会出来”。 |
| 日本金輪継；[なんば建築工房实物照片：装好、松开、分解](https://www.nanbakenchiku.co.jp/kiji/blog/9726/) | T 形配合后插入込み栓；展示样品特意做松，栓系了绳 | 栓锁主体，但来源没有展示栓自身的防退出形状。先拔栓再拆主体，不满足本题对最后一件的要求。 |
| 龙凤榫、穿带；[原作者论文转载，图 5](https://www.jxcat.com/mobile/articles/17936) | 沿推插方向可以拆开，横向受形状约束 | 锁住横向却留下插入轴的退路，正是现有沙漏榫尚缺的那一项。 |
| 多方向平移、迷宫式退路 | 未找到能用于这两个位置、且第一步受形状锁住的具体实例 | “先横移再抽”本身不足以通过；不能仅以步骤多，就断言重力和推拉做不出来。此行是未找到，不是虚构一种现成方案。 |

另一类容易误判的论文例子是 [Sun & Zheng, Computational Design of Twisty Joints and Puzzles（2015），§7.3、图 20](https://www.cs.columbia.edu/cg/twisty/twisty-lowres.pdf#page=8)：**看到的**核心连接实际使用带切缝的弹性扣合，部分实物为 SLS 尼龙；**推断**不能用其旋转外观证明本轮所需的刚性、PLA、独立横榫方案。它也不是合格候选。

## 5. 给 Claude 的判断依据

1. **目前不能交付一份“已通过、拿图让 Hsinlung 挑”的榫清单。** 可以交付的是上面可追溯的图源和明确缺口；不能把待解决的角度保持藏在“转一下就锁住”里。证据：第 3 节原作者及专利资料。
2. **最有针对性的后续机制方向是受约束的旋转钥匙榫，但本轮未找到完整现成实例。** 要同时画出装入口、锁定肩、反转限制及释放反转限制的动作；释放动作自身也得通过本轮普通载荷检查。只新增一个直插定位栓，会把问题转移给最后那根栓。此项是根据来源机制做的推断，不是已获认可的新设计。
3. **不要把“转动”本身判成不合格，也不要直接判成合格。** 例如完全轴向、无偏心的推力不会凭空变成拧转；但自由旋转的榫如果没有其他几何约束，就不能仅凭这一点解释甩动、壳体转动冲击和振动下为什么保持锁定。须按具体结构分析，不能在没有尺寸、接触面和动作图的情况下作保证。此项为刚体运动关系推断，并非本手柄实测故障。
4. **“完全固定死”在这里按不能脱出理解。** 不能以缩掉打印间隙、摩擦变大或许诺零游隙来代替形状防脱；本轮没有合格结构的游隙、承载、磨损或循环测量。依据：Hsinlung 本轮要求与本地现有 0.20 mm/面直槽。

## 6. 查过哪里、哪些仍然找不到

- 中国传统榫卯：走马销、银锭、楔钉、穿带、三柱鲁班锁；查作者论文内容及博物馆相关检索结果。故宫 PDF `https://www.dpm.org.cn/Uploads/File/2019/04/30/u5cc823fe93a0f.pdf` 本轮打开报文件过大；北京旅游站的故宫木器修复相关文章 `https://lyzz.visitbeijing.com.cn/news/detail?id=22971` 打开超时。没有把未完整读到的内容作为通过依据。
- 日本木工：金輪継、込み栓、しゃち栓、回转式仕口及木组展示；能读到实物与拆解图的金輪継见第 4 节，没找到适配本题且独立栓自身受形状防退的实例。没有以“日式”或“传统”替代防脱说明。
- 打印圈：检索 Printables、Thingiverse、MakerWorld 的 burr / rotational burr / twist lock / bayonet / locking tenon。可核实的原作者 PLA 实打记录见第 3.2 节；未找到三个平台上完整满足本题的实例。Printables 上述条目正文抓取失败，原作者帖所连 Thingiverse 页面也未成功读取；未下载模型或把搜索缩略图当作装配验证。
- 论文和专利：核实旋转榫的防反转定位件、旋转互锁和打印核心连接；没有找到同时满足“单个独立榫、两片壳、无摩擦/弹性/外加保持件、特定拆法、当前小空间”的公开实例。

**最终状态：0 个已通过候选；旋转钥匙榫是最接近的机制方向，尚缺符合限制的锁定状态保持及本地适配证据。** 这是本轮检索结论，不是对所有可能榫卯的不存在证明。
