Cheerssom/LingTouchCompanion/hardware/models/3mf/Handle_NewPCB_2026-10-20/references/power_bank_screen.md

# 灵触 PCB1_2 充电宝初筛

核查日期：2026-10-20。仅筛选整机，不拆壳、不建模、不修改电路。容量不参与排序。

**结论：优先保留摩米士 IP130、绿联 PB503；第三款推荐绿联 PB507，限外置演示备选。没有找到并确认 8 款同时满足全部硬条件的产品，不能把下表的 8 款初筛对象说成 8 款合格品。** 其中 PB503、PB507 有国内商品页明确写“有货”；IP130 有国内标价及购买按钮，但没有取得明确库存状态。其余的超预算、参数缺口及淘汰理由逐项列出。

几何依据：[同轴手柄 README](../../Handle/Coaxial_v1/README.md) 写握持段**外截面 41.3×32.3mm**，且有圆角；它不是可用内腔。以下“截面”均是假设整机最长边沿杖轴后的外形包络比较，属于**推断**，没有证明与新板共存、接头走线或装配间隙通过。尺寸小于外截面只能保留候选，不能写“确定塞得进”。尺寸单位 mm，重量为整机重量；有疑义者单独注明。

| 截面顺序／型号 | 固定 PD 9V 输出：页面事实 | 完整外形尺寸、重量及来源 | 国内商品、当前价格与库存证据 | 接头／线的位置 | 小电流断电、小电流模式／常开输出 | 对手柄的判断与筛选结果（推断） |
|---|---|---|---|---|---|---|
| 1 小米口红版 **P07ZM** | USB-C **9V⎓2.22A，20W Max**；商品详情明确写 PD 快充。[商品参数](https://www.tvcmall.com/details/xiaomi-p07zm-lipstick-shape-portable-5000mah-power-bank-phone-external-battery-charger-sku663200624a.html) | **94.5×30.6×30.6；约127g**。[零售商规格](https://www.xiaomistore.pk/xiaomi-power-bank-5000mah-lipstick-version)。用三维包络记法，不把它当成精确圆柱。 | 国内[商品页](https://m.xhtxmall.com/product/195398.html) **159元，写“现货”**，可购买；没有确认到预算内的新机现货价。 | 单 USB-C 母口，位于机身端部，无自带输出头／线；见[商品页](https://www.tvcmall.com/details/xiaomi-p07zm-lipstick-shape-portable-5000mah-power-bank-phone-external-battery-charger-sku663200624a.html)。 | 本型号的断电阈值、延时、小电流模式、常开输出：**未查到**。未用其他小米型号说明代替。 | 截面最窄的一组，但厚度与手柄外高度已很接近，不能确认内部安装；**因159元超预算淘汰**。 |
| 2 摩米士 **1-Power Mini IP130，USB-C版** | C线、C口及C直插头均标 **9V⎓2.22A，PD20W**。[厂家规格](https://www.momax.net/products/1-power-mini-3-in-1-power-bank-5000mah) | **77×36×27；100g±10g**。[厂家规格](https://www.momax.net/products/1-power-mini-3-in-1-power-bank-5000mah) | [京东商品页](https://item.jd.com/product/iYbp9l01Kuyz5tsJyXWlNQ.html) **98元**，显示加入购物车／立即购买；**未读到明确“有货”或送达承诺，库存尚不能确认**。 | 自带可折叠 C 公头、自带 C 线，另有 C 母口；厂家页面确认结构，但文字未标公头相对于长轴的具体位置，**朝向未核实**。选 IP130，不混用 IP130MFI 的苹果头规格。 | [商品详情](https://24h.pchome.com.tw/prod/DYAO47-A900ITABZ) 宣传图文字写“小电流设备也能充”；厂家文字未给断电阈值、延时、模式操作或常开承诺。**9V几十mA是否保持输出：未查到**。 | 截面 **36×27**，比后面的直插绿联更有横向余量，且折叠头方便收纳；**装入优先候选，但库存硬条件未闭合**。 |
| 3 绿联胶囊直插 **PB503／35338** | C1/C2 **9V⎓2.22A**，明确 PD3.0/2.0，PD20W。[厂家商品规格](https://us.ugreen.com/products/ugreen-mini-power-bank-5000mah-22-5w-2ports) | **79×38×26；112g**。[中国官网尺寸](https://www.lulian.cn/product/1035.html)、[厂家海外页重量及尺寸](https://us.ugreen.com/products/ugreen-mini-power-bank-5000mah-22-5w-2ports)。独立实测约111g，非另一个型号：[原始测量](https://www.chongdiantou.com/archives/401211.html)。 | [纳思达云商自营商品页](https://www.ninestarmall.com/Store/Product/Product.aspx?pid=477904&sid=180) **99元，库存“有货”**，有购买入口；[厂家对应商品及京东／天猫入口](https://www.lulian.cn/product/1035.html)。库存为页面陈述，未下单。 | 原始拆解记录称**顶部 C 直插公头、侧面 C 母口**，直插头有保护胶盖；不是自带线款。[外观与接口](https://www.chongdiantou.com/archives/401211.html) | 原始观察记录：**长按电源键3秒进入小电流模式**。[实物操作记录](https://www.chongdiantou.com/archives/401211.html)。普通模式断电阈值／延时、小电流模式时限及能否保持9V：**未查到**；未找到无限时常开承诺。 | 截面 **38×26**，有保留价值，但宽度余量很紧，直插头和侧向插线空间仍未知；**本轮内置方向的主要推荐**，电压、国内现货及预算证据最完整。 |
| 4 绿联胶囊自带线 **PB506／35339** | 本轮**未从可核实的厂家／商品参数文字取得9V具体输出电流**；不能仅凭22.5W标题判定合格，也不沿用PB503参数。 | [绿联官方乐天店35339](https://item.rakuten.co.jp/ugreen-gear/35339/) 写 **82.5×40.5×27；220g**，但未说明重量口径。此数值不能当成已确认净重；本轮未解决净重证据缺口。 | [国内商品页](https://ninestarmall.com/Store/Product/Product.aspx?pid=477910&sid=180) **109元，库存“有货”**；超过100元上限。历史优惠不作当前价格。 | 自带 C 线、直插 C 头与支架；型号须与无带线的PB503区分。[对应官方店商品](https://item.rakuten.co.jp/ugreen-gear/35339/)；具体出线方向未核实。 | 可核实的一手资料中，断电阈值、延时、小电流模式及9V常开：**未查到**。未采用自动整理的非官方“说明书”网页参数。 | 按官方店包络，截面 **40.5×27**，宽度几乎达到手柄外宽；**不推荐**，原因是略超预算、固定9V和净重证据不完整，且装入余量更差。 |
| 5 绿联三合一 **PB510／35927** | 官网明确区分移动电源模式：C输出 **9V⎓2.22A**，PD3.0，PD20W；不是只在插墙模式支持。[厂家参数](https://www.lulian.cn/product/1262.html) | **83×48×29；约161g**。[厂家参数](https://www.lulian.cn/product/1262.html) | [国内商品页](https://m.ninestarmall.com/Store/Product/Product.aspx?pid=477932&sid=180) 存在购买入口，但价格“登录可见”，未读到明确库存；**本轮未确认预算内现货**。 | 自带 C 线、独立 C 口、折叠 AC 插脚；无须用其AC插脚给板供电。[厂家结构](https://www.lulian.cn/product/1262.html)。文字未标具体出线方位。 | 本型号断电阈值、延时、小电流模式／常开：**未查到**。 | 截面 **48×29**，宽边超过手柄外宽；**内置淘汰**，额外AC结构没有解决本任务的空间需求。 |
| 6 倍思口袋快充 Type-C版 **PPKDC05C** | C口及C线标 **9V⎓2.22A，20W**。[商品完整参数](https://www.cqxsyp.com/ProductShow.aspx?id=51248)。该文字没有明确列PD协议，故不把本款固定PD能力判为已完整核实。 | **92.6×53.3×23.3；约135g**。[商品参数](https://www.cqxsyp.com/ProductShow.aspx?id=51248) | 同一[国内商品页](https://www.cqxsyp.com/ProductShow.aspx?id=51248) **169元，库存86件**；明确有货但超预算。 | 自带 C 线、独立 C 母口；商品文字未标出线位置。不是自带Lightning线的PPKDC05I。 | 断电阈值、延时、小电流模式／常开：**未查到**。 | 截面 **53.3×23.3**，扁平宽机身；**因宽度及价格淘汰**。 |
| 7 小米自带线口袋版 **P15ZM** | C线／C口 **9V⎓2.23A，22.5W Max**。[厂家规格](https://www.mi.com/tw/product/xiaomi-power-bank-10000mah-integrated-cable/specs/)。原始协议测试确认9V固定PDO：[实测](https://www.chongdiantou.com/archives/350690.html)。 | **105.2×65.2×26.9；商品标200g**。[厂家尺寸](https://www.mi.com/tw/product/xiaomi-power-bank-10000mah-integrated-cable/specs/)、[国内销售商净重字段](https://shop.ntbsj.com/index.php/home/goods/show/51716)。原始实测约214g，不能混成同一精确值：[测量](https://www.chongdiantou.com/archives/350690.html)。 | [京东商品页](https://item.jd.com/product/14eHwEqjzebqQU8oZpodlw.html) **99元**，显示购买按钮；未读到明确库存，**不算已确认现货**。 | 原始观察：**顶部1A1C接口，侧面引出C短线，另一侧有线头收纳槽**。[实物结构](https://www.chongdiantou.com/archives/350690.html) | 原始评测记录**双击按键开启小电流放电模式**：[操作记录](https://www.chongdiantou.com/archives/315567.html)。普通断电阈值、延时、模式时限及9V低电流保持：**未查到**。 | 截面 **65.2×26.9**，明显超宽；**内置淘汰**。外置也不优于库存证据更清楚的PB507，不进入最终三款。 |
| 8 绿联 **PB507** | C口 **9V⎓2.22A，PD20W**；不是拿A口的22.5W代替。[厂家参数](https://www.lulian.cn/product/1263.html) | **112×70×16；190g**。[厂家尺寸和净重](https://www.lulian.cn/product/1263.html) | [纳思达云商自营商品页](https://ninestarmall.com/Store/Product/Product.aspx?pid=478723&sid=180) **82.90元，库存“有货”**；该销售组合含独立双C线，不是自带线机身。 | USB-C／USB-A接口，无自带直插公头、无自带输出线；见[厂家商品](https://www.lulian.cn/product/1263.html)。文字未明确接口相对长轴的位置。 | 该型号的断电阈值、延时、小电流模式、常开输出及9V低电流保持：**未查到**。 | 截面 **70×16**；宽度远超手柄外截面，**不能作为现截面内置方案**。仅保留为预算内、有明确库存的外置演示备份。 |

推荐理由：

1. **摩米士 IP130：按外形优先。** 官方截面36×27mm、自带可折叠C头，最值得先保留给内部空间核对；京东标价98元。但本轮没有取得明确库存证据，不能称“已确认有货”；9V低负载不断电也未确认。
2. **绿联 PB503：当前采购证据最完整的内置候选。** 国内页面明确99元、有货，固定9V输出及完整尺寸重量有厂家来源，还找到小电流模式的实物操作记录。相比IP130更宽，顶部公头、侧面母口和按键都要留使用空间；没有装配验证，也没有9V几十mA连续输出验证。
3. **绿联 PB507：外置演示备选。** 国内82.90元且明确有货，固定9V输出、完整尺寸重量有官网来源。选择它只为有可购买的演示备用电源，**不建议为了容纳它加宽手柄**；若第三款也必须装进当前截面，本轮没有证据足够的第三款，不能凑数。

共同限制：本轮未找到任何一款明确承诺在固定9V、几十mA负载下无限时常开。“可给耳机充电”或“有小电流模式”不等于已经证明这个工况不会断电，也不等于模式仍支持9V。采购前最有价值的未决信息就是对应SKU在此工况下的保持情况，而不是容量。

输入经TPS259470A限流约2.7A、CH224A固定请求9V，是Hsinlung提供的任务前提。上述约20W机型的9V额定电流低于这个板上限流值：**板上限流并不会使充电宝获得更大的输出能力**；本次只按要求的9V≥2A筛选，未声称充电宝已覆盖板子的全部峰值负载。

来源口径：官网／厂店及销售商参数属于“页面写的”；充电头网链接仅引用作者亲测的重量、PDO和操作，已显式标注；装入、排序及取舍属于推断。当前价格／库存指本轮可读取页面的陈述，未提交订单，也没有选定Hsinlung收货地址核对配送。浏览器打开绿联官方参数图片被自动审批拒绝；未绕过该限制，无法核实的图片参数保留为缺口。此文件是证据有缺口的一轮初筛，不是满足全部硬条件的八款采购清单。
