Cheerssom/LingTouchCompanion/hardware/models/3mf/Handle/GripStudy/inputs/EmmaLieker_README.md

# Anatomically Accurate Rigged & Animated Hand Model

<p align="center">
  Turntable animation of the rigged hand model
</p>

<p align="center">
  <a href="https://www.turbosquid.com/3d-models/human-hand-anatomically-accurate-rigged-and-animated-with-skin-texture-3d-model-2564269">
    
  </a>
  
  
</p>

---

A fully rigged and animated human hand model built in Blender with **anatomically correct joint rotation ranges** and **realistic dual-scale skin texturing**. Designed for real-time XR applications, scientific visualization, and motion-capture research.

## Pose Presets

<p align="center">
  All pose presets: OK, neutral, flat, point, fist
</p>

Five pose presets created with Sakura Poselib: OK gesture, neutral, flat, point, and fist — each constrained to anatomically plausible joint angles.

## Rigging

The armature consists of 21 bones covering individual finger joints (DIP, PIP, MCP), metacarpals, thumb CMC, and wrist. Joint rotation limits for flexion, extension, abduction, and adduction are constrained per bone to match the physiological range of motion of a human hand, meaning the rig **cannot be posed into physically impossible configurations**.

<p align="center">
  21-bone FK armature in OK gesture pose
  &nbsp;&nbsp;
  FK armature in neutral pose
</p>

## Topology & UV Layout

Clean tri-dominant mesh (5,790 triangles / 3,007 vertices) optimized for real-time rendering and smooth deformation under all poses. Non-overlapping UV unwrap for artifact-free texturing.

<p align="center">
  Wireframe with UV seams
  &nbsp;&nbsp;
  Wireframe mesh overlay
  &nbsp;&nbsp;
  UV layout — non-overlapping unwrap
</p>

## Features

- **21-bone FK armature** with anatomically correct joint limits
- **Realistic skin texture** with dual-scale mixing to counteract tiling
- **Animated** with multiple pose presets (via Sakura Poselib)
- **Clean topology** — 5,790 tris / 3,007 verts, optimized for real-time
- **Proper weight painting** for natural skin deformation across all poses
- **Non-overlapping UV unwrap** for clean texturing
- **No AI-generated content** — fully hand-modeled, hand-rigged, and hand-textured

## Technical Specifications

| Property | Value |
|---|---|
| Polygons | 5,790 tris |
| Vertices | 3,007 |
| Bones | 21 |
| Rigging | Forward Kinematics (FK) |
| Texture | Dual-scale skin mix |
| Native format | `.blend` (Blender 4.5 LTS) |
| Export formats | `.glb` / `.fbx` |

## Compatibility

- **Blender** 4.5+ (native)
- **Unity** (via FBX/GLB import)
- **Unreal Engine** (via FBX/GLB import)
- **WebXR / Three.js** (native GLB support)

## Use Cases

- VR/AR hand interaction & gesture visualization
- Medical and scientific illustration
- Biomechanics & neuroscience research
- Motion capture data visualization
- Game development
- Animation reference & digital twin applications

## Repository Structure

```
├── README.md
├── LICENSE
├── assets/
│   ├── renders/            # Turntable GIF & pose overview
│   ├── rig/                # Armature visualization
│   ├── wireframe/          # Topology & mesh views
│   └── uv/                 # UV layout
├── exports/
│   └── hand_model.glb      # Ready-to-use export
└── blender/
    └── hand_model.blend     # Source Blender file
```

## Getting Started

1. **Quick use:** Download `exports/hand_model.glb` and import into your engine of choice.
2. **Edit the rig:** Open `blender/hand_model.blend` in Blender 4.5+.
3. **Download:** [Get the model on TurboSquid](https://www.turbosquid.com/3d-models/human-hand-anatomically-accurate-rigged-and-animated-with-skin-texture-3d-model-2564269).

## License

This work is licensed under [CC BY-NC 4.0](https://creativecommons.org/licenses/by-nc/4.0/).  
Free for personal and academic use. Attribution required.

**Attribution:**  
> 3D Rigged Hand Model © 2026 Emma L. D. Lieker

## Author

**Emma L. D. Lieker**  
[GitHub](https://github.com/emmalieker) · [TurboSquid](https://www.turbosquid.com/Search/Artists/Do_Neuroscience)
