Cheerssom/LingTouchCompanion/docs/plans/lingtouch.md

# 灵触·随行 项目现状（队友版）

更新日期：2026-09-16

这份文档只写已经做出来、测过、定下来的真实情况，供答辩准备和分工参考。答辩用的视觉方案正在重新设计，不在本文范围内；旧 PPT 里的视觉内容不作数。

---

## 1. 项目在做什么

灵触·随行是给视障者用的出行辅助设备：用摄像头看前方环境，把"前方哪里有障碍"转换成白杖手柄上一块可刷新的触觉点阵，用户用手摸就能知道前方障碍的大致布局。白杖本身保留，设备是在白杖之外补充"提前知道前面几米有什么"的信息。

- 参赛项目：中国国际大学生创新大赛。
- 分工：
  - 硬件、PCB、固件由项目负责人负责。
  - 摄像头/感知前端另有一名负责人。
- 触觉模组由外部厂家"无界"提供，模组内部机理和参数以对方（郦铖）的说法为准。

---

## 2. 需求依据：视障者访谈

做过 3 名视障人士的半结构化访谈。和设计直接相关的结论：

- 受访者出行只用高德导航加白杖，不用专门的助盲 App（不知道或不喜欢用）。
- 高德只给路线级信息（往哪走、在哪转弯），不告诉用户前方障碍怎么分布。这正是本项目要补的空缺。
- 受访者大多明确不喜欢把摄像头绑在胸前，主动提出希望做成眼镜形态。
- 受访的几位本身完全不戴眼镜，所以把摄像头集成进墨镜不存在"和原有眼镜冲突"的问题。
- 受访者出行时一手白杖、一手手机。

据此已经拍板：**摄像头形态改为智能眼镜。** 对眼镜的要求：
- 视场要大，最好能看到身体左右两侧。
- 一直开着，不需要人去触发。
- 可充电，单次能用一两个小时。

"过马路时看左右来车"作为已知诉求记录下来，但暂不作为核心：这类紧急情况用声音提示不一定比触觉差。

---

## 3. 触觉阵列（核心硬件）

### 3.1 阵列布局
- 15 个触觉模组，排成横 3 列 × 竖 5 行。
- 每个模组 6 个点，排成 2 行 × 3 列。
- 拼起来共 90 个点，按 **10 行 × 9 列** 使用。

### 3.2 实测几何（2026-09-07 用实物量的）
- 模组内点距 2.5mm，和标准盲文点距相同。
- 点凸起高度 0.5mm。
- 竖直方向：模组紧密相接，点距连续 2.5mm。
- 横向：模组之间有略小于 4mm 的缝，所以横向点距不均匀。这道缝把阵列天然分成**左、中、右三块**，手指一摸就能分出障碍偏哪边。

### 3.3 一个点是怎么升起、怎么保持的（无界提供的机理）
- 每个模组里有 **6 个独立的小线圈**（每个点一个），但只有 **1 根共用的记忆合金丝（SMA）**。
- **记忆合金是锁**：通电发热时锁松开，断电冷却后锁重新夹紧。
- **线圈只负责往上推针**，每个点单独控制。
- **针落下靠弹簧或磁铁**，不靠重力。倒过来拿做过实验，照样工作。

一次刷新分四步，时长写在固件里：

| 阶段 | 时长 | 记忆合金 | 线圈 | 作用 |
|---|---|---|---|---|
| A 解锁 | 10ms | 通电 | 断 | 锁松开 |
| B 推起 | 50ms | 通电 | 要凸起的点通电 | 把针推上去 |
| C 等锁夹紧 | 150ms | 断电 | 继续通电 | 记忆合金冷却，锁把针夹住 |
| D 全断 | 10ms | 断 | 断 | 所有输出关闭 |

- 一次完整刷新约 **220ms**。线圈连续通电 200ms，记忆合金通电 60ms。
- 刷新完所有电都断开，图案靠机械锁保持。
- 因为锁是整个模组共用的，**同一个模组里"部分点坏、部分点好"不可能是记忆合金或供电的问题**，只能是单个点本身的问题。

### 3.4 电气参数
- 线圈电阻：万用表实测约 15Ω 稍多。
- 厂家设计的供电（设计意图，不是过压）：
  - 线圈电源 **VCC 3.3V**，经驱动芯片压降后，线圈上约 2.5V。
  - 记忆合金电源 **VCCS 2.0V**，经驱动芯片压降约 0.9–1.1V 后，记忆合金上约 1.1V。
- 模组封装名 "HC-PM127" 只是借用的封装名，不是真实型号，查不到。

### 3.5 焊接注意
- 按无界的说法，模组引脚约 300°C 快速过一遍。
- 模组装上板之后不能再用热风枪，只能用烙铁点焊。

### 3.6 模组可靠性
- 早期板子上出现过部分点不动的情况。排查结论：模组内部的**逐点锁死机构卡住**，电气正常，外部修不了，已反馈给无界。

---

## 4. 驱动板

### 4.1 驱动架构
ESP32-S3 用三根线（数据、时钟、锁存）把数据推进 **16 片串联的移位寄存器（74HC595）**，每片后面接一片**达林顿驱动芯片（ULN2003 类）**。

- 每片移位寄存器用 7 路输出：6 路给线圈，1 路给记忆合金。16 片共 112 路独立输出。
- 板上有 16 个模组位：
  - 15 个正式使用。
  - 第 16 个是测试位，暂时没有用途。
- **所有输出独立、可以同时驱动，不做轮流扫描。** 原因：一个模组的 6 个点必须在同一次"锁松开"的窗口里一起设好；如果轮流扫描，一帧刷新要拉长到 0.4–0.9 秒，就不实时了。这个方案已经否决。
- **驱动芯片沿用达林顿**，没换成 MOS 管驱动。这是为了在等无界回复期间不改驱动方案、减少变量，并不是已经证明达林顿更好。

### 4.2 电源
- **电池**：两节 18650 串联（2S）。
  - 手上有魔力 P28A 和 P30B 两种电芯，各组了一个 2S 包，配杂牌 2S 保护板。
  - 保护板标称 20A 连续放电、10A 连续充电、25A 启动。
  - 电池内阻和保护板带载时的实际门限还没有可靠资料，待验证。
- **板上三路电源**，互相分开：
  - **线圈电源 VCC 3.3V**：大电流同步降压芯片 MPQ8633B（U49），配大容量固态电容。
  - **记忆合金电源 VCCS 2.0V**：单独一颗小降压芯片（U50）。
  - **ESP32 电源 5V**：升降压芯片 TPS63070（U51）。
- **充电**：USB-C（U53）。
- **峰值电流**：固件允许 90 路线圈同时通电，没有数量限制，所以电源按"全部点同时抬起"来设计，峰值在 15A 量级。
- **大容量储能必须用聚合物或固态电容**，普通电解电容内阻太大，这么大的电流下会造成严重压降。

### 4.3 板子版本历史
- **V1 暴露的问题**（V3 已针对性修改）：
  - 逻辑芯片的电源是从线圈电源经一颗磁珠分出来的，线圈一动作，逻辑电压就跟着塌。
  - 记忆合金电源用的 AMS1117 线性稳压，发热约 2.1W，会热关断。
  - 线圈电源没有本地去耦电容。
  - 90 个点里约 33 个点失效，当时没有办法区分是来料问题还是焊接问题。
  - 模组焊死，坏了没法单独更换。
  - 板子装进手柄时是旋转 180° 装的，软件里要做对应的映射翻转（见第 5 节）。
- **PCB1_4（上一版）**：
  - 模组在这块板上一次都没有成功升起过。
  - 出现过一次原因不明的过应力事件，之后实测多处异常：OE# 对地约 2.3Ω、VCC 对地约 58Ω、U11 发热。
  - 无法证明只坏了一处，已决定**不修，重新打板**。
- **V3（当前）**：
  - 原理图正在重画，最新网表日期 2026-09-12。
  - 2026-09-14～15 导出的 PCB 版本是 6 层板，Gerber 几何检查没有发现网络短路或断路。但这不等于载流、温升和实机已经验证通过。当时还发现电源主通路（电池入口、线圈电源降压输出、USB 充电输入）走线偏细，需要加粗。
  - 流程：画原理图 → 无界协助 → 打板 → 找人贴片焊接（含通路检查）→ 自己装模组。
  - 最慢预估约一个月：备料加打板一周、贴片两周、到手验证一周。**板子预计 11 月到。**

### 4.4 新板装配和验证顺序
1. 先焊所有 595（背面）、驱动芯片（正面）和电源部分。
2. 上电，通过测试接口 J_test，把移位寄存器链末端的输出读回来，验证整条链是通的。
3. 最后再焊模组。
- U49、U53、Q1 是底部焊盘封装，只能热风加锡膏焊，锡丝焊不了。

### 4.5 续航
- 目标：触觉部分单独做到 10 小时以上。
- 现状：
  - 没有实测过续航。
  - 固件没有电池电压采样，也没有低电判断和低电关机。
  - 线圈电源芯片 MPQ8633B 的 MODE 脚经 30.1kΩ 接地，按数据手册是"轻载强制连续、800kHz"模式。这个模式在不刷新的空闲时间里仍有明显损耗，对续航不利；改一颗电阻就能切到轻载省电模式，还没决定。
  - 记忆合金的工作电流还没量过。
- 待定：低电时关哪几路电源；线圈电源和记忆合金电源的上电、关断顺序；记忆合金电源要不要和线圈电源合并。

---

## 5. 固件与通信

当前固件版本 **V2.8**（仓库 `firmware/braille_15module_prod/`），用 Arduino IDE 选 ESP32-S3 Dev Module 烧录。

### 5.1 引脚
| 信号 | GPIO |
|---|---|
| 数据 SER / 时钟 SRCLK / 锁存 RCLK | 11 / 12 / 10 |
| 输出使能 OE# / 清零 SRCLR# | 9 / 8 |
| 按键 | 6 |

### 5.2 蓝牙协议
- 服务 UUID `FFE0`。
- **写入特征 `FFE1`**：每次写 15 个字节，一个字节对应一个模组，低 6 位是该模组 6 个点的凸起/平。
- **通知特征 `FFE3`**，事件类型：
  - `0x01` 刷新完成
  - `0x02` 模式切换
  - `0x03` 电池（只定义了编号，没有实现采样）
  - `0x04` 按键请求
- 驱动层每个字节的第 6 位控制该模组的记忆合金，由固件内部生成，手机不用管。

### 5.3 刷新行为
- 每收到一帧，15 个模组**全部刷新一遍**，不做变化检测，约 220ms。
- 刷新途中收到新的一帧，会**立刻中止**当前刷新、关闭输出，改刷新的一帧。
- 刷完通过 `FFE3` 发"刷新完成"。
- 断连后自动重新广播。
- 固件里有两个模式编号：快速避障、局部放大。按键目前只发出"按键请求"事件。

### 5.4 电脑端实验程序的节奏
- 默认约 1 秒发一帧。
- 等收到"刷新完成"再发下一帧；0.8 秒没收到算失败，连续 3 次失败自动暂停。

### 5.5 映射方向
板子是旋转 180° 装进手柄的，所以数据和实际点位之间有一层翻转映射。仓库里两个浏览器调试工具的映射不同：
- `ble_mobile_controller.html` 用 ROT180 映射，对应当前装配方向。
- `ble_testbench.html` 保留旧的 PROD 映射。

用错工具，点位会整个反过来。

---

## 6. 视觉（当前实验原型）

**这是现在真实跑通的原型链路，不是最终的眼镜方案。** 代码在仓库 `visionss/`。

### 6.1 链路
1. 手机（华为 Mate 50 Pro 主摄）挂在胸前 1.40m 高度拍照，上传到电脑。
2. 电脑用 **Depth Anything V2** 米制深度模型（metric hypersim vitl 权重）算出每个像素的距离。
3. 把深度图还原成三维点，在画面底部 25% 找地面并拟合出地面平面。
4. 用"真实相机高度 ÷ 拟合出的相机高度"做尺度校正（这个模型在真实照片上有系统性的尺度偏差）。
5. 保留离地 0.10–1.80m 的点，投影到俯视图，生成 10×9 占据栅格。
6. 转成 15 字节，经蓝牙发给点阵。

### 6.2 栅格的真实几何
- 前方 1 米以内不编码，交给白杖。
- 1 米之后每格 40cm × 40cm：10 行覆盖前方 1.0–5.0m，9 列覆盖左右各 1.8m。
- 输出时行序从远到近，发送前做左右镜像（配合穿戴方向）。
- **注意**：旧路演 PPT 里写过 ±2.0m、0.45m、0.5–5.0m，这些数字不对，已作废，以上面为准。

### 6.3 标定与实测精度
- 相机焦距标定 fx = 3260 像素：用 2.0m 外、宽 0.90m 的门扇测得，和手机主摄理论值偏差约 6%。
- **黑布地面**测试集，椅子距离估计误差：

| 真实距离 | 估计距离 | 误差 |
|---|---|---|
| 2m | 1.66m | −17.0% |
| 3m | 2.58m | −14.0% |
| 4m | 3.50m | −12.5% |
| 5m | 4.09m | −18.2% |

- **换成浅色地面**后，3 米处的椅子误差降到 **−2.1%**。
- 结论：误差主要来自深色、反光地面，让模型近距离的尺度判断失准，不是算法本身的问题。

### 6.4 已知限制（实验得出）
- **障碍物至少要约 0.5m 宽**。气球这类小目标产生的点数比判定门槛低约 3 倍，怎么调参数都检测不到。
- **地面必须浅色、不反光**，而且画面最下方（相机脚下那一段）也不能有深色材质。
- **判断一格有没有障碍要按"填充比例"**，不能按点数多少排序。离得越近点越密（点数和距离平方成反比），按点数排序会被近处地面垄断。
- 输出时左右各多扩一列，方便手指找到。

### 6.5 其他
- 手机浏览器拍摄只能拿到横向 4096×3072 画面，拿不到竖屏，由电脑端旋转。
- 仓库 `vision/` 是更早的图像平面方案，保留作备用，当前不用。

---

## 7. 手机 App

代码在 `app/`，前端 uni-app（Vue），后端 Node.js + Express。**目前是界面原型，多数设备功能是模拟的。**

- **页面**：首页、步行导航、地图、设备（蓝牙连接与点阵控制）、设备诊断。
- **地图**：前端配置的是高德，后端接口用的是百度，两边不一致。所有地图 Key 都是占位值，不能直接调用。
- **语音命令**：后端是规则匹配解析，大模型解析只预留了接口，没有接入。
- **设备状态**：电量固定从 78% 开始显示，连接和断开是模拟的。
- **视觉帧转发**：后端有接收视觉帧（HTTP）和推送给手机（WebSocket）的接口。但当前视觉实验程序是独立运行的，不经过这个后端。

---

## 8. 答辩相关

### 8.1 校内预答辩意见（2026-09-16）
老师提出：用户摸到"左侧 2 米有障碍"，很可能根本没有"2 米"的概念，这需要用户有很强的空间感。

项目负责人的立场：用户不需要准确知道 2 米在哪，知道大概近处有障碍、哪边有障碍就够了。PPT 里是否去掉具体距离、改用远近说法，还没定。

### 8.2 现有材料之间对不上的地方
来自 2026-09-16 的 140 题问辩手册，PPT、商业计划书、答辩稿三份材料在这些地方说法不一致，统一之前答辩时不要随口引用：

| 事项 | 材料 A | 材料 B |
|---|---|---|
| 系统架构 | PPT 第 16 页：眼镜 → 手机 → 点阵 | 计划书 2.1：肩部摄像头 → 树莓派 → 手机 → ESP32-S3 |
| 蓝牙帧长 | PPT：15 字节 | 计划书：18 字节（15 字节点阵 + 1 字节模式 + 2 字节序号） |
| 时间指标 | PPT：约 1Hz、220ms 全刷新、响应小于 100ms | 计划书：500ms 端到端、2–4Hz |
| 距离映射 | PPT：40cm 等距 | 计划书：近密远疏 |
| 高度范围 | 技术页：0.10–1.80m | 功能页：2m |
| 语音 | PPT 第 14 页：大模型已具备 | 计划书 2.1.5：当前规则匹配，大模型是后续方向 |

对照真实情况：
- 固件实际收的是 15 字节。
- 全量刷新约 220ms，实验程序约 1 秒一帧。
- 栅格是 40cm 等距，高度过滤 0.10–1.80m。
- 语音目前是规则匹配。

---

## 9. 资料在哪

| 内容 | 位置 |
|---|---|
| 全部代码（固件、视觉、App） | GitHub 仓库 `zxlzzz/LingTouchCompanion` |
| 固件 | `firmware/braille_15module_prod/`（V2.8） |
| 视觉实验程序 | `visionss/`，入口 `python visionss/phone_server.py` |
| 视觉标定与测距验证记录 | 仓库根目录 `TOPDOWN_VALIDATION.md` |
| 蓝牙调试网页 | `ble_mobile_controller.html`（当前装配方向）、`ble_testbench.html`（旧映射） |
| 手机 App | `app/frontend/`（HBuilderX 打开）、`app/backend/` |
| 原理图、网表、BOM | 立创 EDA 工程 |
| 模组内部问题 | 无界（郦铖） |
