Cheerssom/LingTouchCompanion/docs/plans/视觉方案审阅意见要点_Claude.md

# 对《视觉方案 v1.0》的审阅意见要点（Claude，2026-10-28）

完整版在 claude.ai 的文档"融合方案 v1.0 审阅意见"。这里只留骨架会用到的结论。标"推断"的是没验证过的判断。

## 结论

实测几何管矩阵、模型只补语义的分工保留。要改三处：运行系统整个搬到手机/平板（CS30 直插，不再有 Windows/WSL 和 Radxa）；点阵改成前方 1.0–3.4 m，感知按 0–5 m 做；SpatialLM 要移植到端侧，并先验证喂单帧还是多帧。

## 范围与量程

- 10/11 两帧（默认积分时间 2800 µs，手持）：地面连续只到约 1.3–1.6 m，再远只有零星块，最远读数 5.95 m。3.4–5 m 能否稳定打回来没测过。
- 读数 0 = 无数据；恰好为 1 = 推断是过曝；< 100 mm 低于标称最小量程。三者都按无效处理。
- 远处会相位绕回成近处（推断）：第二帧有四周无数据的 1–10 cm 孤立小块，和 5.2–5.8 m 的远处块在同一水平带，推断绕回点约 6 m。6.5 m 外的东西可能读成 0.5 m，"去掉 10 cm 以下"挡不住，需要识别"四周是空洞的孤立近点"。
- CS30 横向视场约 100°，1 m 处左右只看到约 ±1.2 m，最近一排最外侧几列保持 2。

## 0/1/2 规则

- 1：高度带内有实测点达到支持门槛。1 优先于 0。
- 0：把 40 cm 格切成 4×4 个 10 cm 小块，每个小块都有地面点、且高度带内没有点才给 0；允许缺几个小块由实测定（参数）。理由：比 10 cm 宽的落地物体放在格里，要么测到出点（1），要么没测到时压着的那块地板也测不到（洞→2），要么被挡住地板看不到（2）。原方案的"高度带覆盖达标才给 0"在远排永远达不到：头上相机往下看，要证明格子上方高度 z 是空的，得看到约 d÷(1−z/h) 外的地面，h=1.6 m、d=3.2 m、z=1.0 m 时要看到约 8.5 m。
- 2：其余一律 2（看不到、被挡、视野外、无效）。旧观测失效回到 2，不回到 0。
- 边缘飞点：ToF 在物体边缘会出现悬在前后之间的假点，不滤会在物体后面拖出一串假的 1；滤得太严会吃掉椅腿。这是细障碍回归测试要测的取舍。
- 掩膜和 SpatialLM 框只给已经测出来的点团贴类别名，不生成格子。

## SpatialLM 端侧

- 官方代码依赖 flash-attn、spconv，只能在 N 卡上跑。
- 语言模型（Qwen2.5-0.5B）：鸿蒙上有人在 Mate 60 Pro 用 llama.cpp 跑过；安卓上 MobileVLM 用 llama.cpp 跑过"编码器与语言模型分开加载"的结构。
- 点云编码器（Sonata/PTv3）用了 3D 稀疏卷积，手机推理框架都不支持（2025 年 FALO 论文在骁龙 8 Gen 3 上为此专门避开稀疏卷积，并指出 PTv3 的 xCPE 依赖它）。flash-attn 可关（enable_flash=False）。
- 做法（推断）：邻居表在 CPU 上用哈希表算好，卷积改成"按索引取特征 + 矩阵乘"，池化的 scatter 归约同样改写。
- 验收：同一片点云、同样预处理与种子、同精度（先不量化），平板移植版与电脑官方版的编码器输出和布局文本对上。

## 仍需他（Hsinlung）决定

- 状态 2 在触点上表示成平还是凸（触点只有平/凸两档）。
- IMU 换成什么、怎么接（ICM-42688-P 是裸芯片，需要主板，和"头上不放主板"冲突）。
