Cheerssom/LingTouchCompanion/agent/README.md

# agent — 对话 agent（对话 agent 同学）

| 目录 | 内容 |
|---|---|
| [native/](native/README.md) | C++：语音识别/合成与 agent 接口（本次只有接口）；语言模型接口在 `core/include/lingtouch/inference.h` |
| [backend/](backend/README.md) | Node.js 服务：百度地图、规则式命令解析、视觉帧转发（原 `app/backend`） |
