Cheerssom/LingTouchCompanion/perception/README.md

# perception — CS30 感知（视觉同学）

| 目录 | 内容 |
|---|---|
| [native/](native/README.md) | C++：CS30 取流协议与拆帧、标定解码、深度几何、地面拟合、9×6 的 0/1/2；安卓用的 libusb 取流 |
| [cs30/](cs30/README.md) | CS30 免 SDK 取流的协议材料（10/25 在电脑上做的结论、启动序列、标定 blob、参考帧） |
| [lab/](lab/README.md) | Python 实验位（视觉同学的 Windows 原型和 SpatialLM 复现不在本仓库） |
