Cheerssom/LingTouchCompanion/hardware/models/BrailleModule_Video/pin_lift_handoff/HANDOFF.md

# 在实拍底图上让触点升降 —— 交接（Claude → Codex，2026-10-10）

对话你已经看过。这里只放对话里没有、或者对话里说错了的东西。代码是唯一准确的版本，下面的文字和代码不一致时以代码为准。

## 怎么跑

依赖：`numpy scipy opencv-python`，另需 `ffmpeg` 在 PATH 里（没有的话 step3 改出 PNG 序列）。我这边是 Python 3.13 / OpenCV 5.0.0 / numpy 2.5 / scipy 1.18；用到的函数 OpenCV 4.x 都有，但没在 4.x 上跑过。

```
python step1_detect_dots.py     # 找 90 个针头 → work/grid.npy
python step2_fit_camera.py      # 拟合一台相机 → work/cam.npz
python check_all_dots.py        # 全升起底图 + 90 个点逐个落下/升起对照
python step3_render_clip.py     # 原速测试片段（Hsinlung 10/10 看过、说"差不多了"的那一版）
python check_10_vs_11.py        # 10 和 11 的关系
python real_video/stabilise.py  # 实拍视频稳定
python real_video/measure_rise.py   # 实拍节奏的数
```

`out/` 里是我跑出来的结果。同一环境下重跑，`test_real_rhythm_varied.mp4` 与它逐帧逐像素相同，可以拿来确认你那边环境没走样。

## 做法在哪个文件

- 每个点怎么画：`generator.py` 开头的说明和 `pin_patch()` / `render()`。入口是 `frame(H)`，`H` 是 10×9 的高度（mm）。
- 节奏：`step3_render_clip.py` 的 `profile()`（升起曲线）和 `height()`（某个点某一时刻多高）。
- 图案：`step3_render_clip.py` 顶上的 `ev`，是我编的测试图案，不是指定图案。

## 哪些是量的，哪些是调的，哪些没验证

**量的（脚本可复现）**
- 10 和 11 是同一张图，只差 4 个直径 53 像素的圆；11 这四个圆是同一排中间那个点的复制加固定亮度差。
- 90 个针头位置能用"一台相机 + 每个模组各自摆位"对上：平均 0.60 像素，最大 1.89。
- 实拍视频（30 帧/秒，342 帧）里三次动作的逐帧"像升到位的程度"，整模组和逐点的数都在 `measure_rise.py` 的输出里。结论：升起 = 先到七八成 → 第三帧回落（同模组同一帧，逐点深浅 0.29–0.80）→ 两三帧爬到位；约六个点里一个晚一帧；落下两帧。
- 10 里四个升起点相对落下状态：亮度 ×1.19–1.28，亮斑宽 32–34 像素（落下 30–31）。

**调的（视觉调节值，不是实测，可以改）**
- 保持高度 `HOLD=0.5 mm`、针头半径 0.71 / 顶高 0.45（来自仓库 `parameters.json`，那里写明是按图纸估的）、`D0=0.33`（落下时能看见多深，我对着中间模组调的）。
- "每升高 1 mm 画面挪多少像素"（顶排约 12、中间 9、底排 5）：是上面那台相机算出来的，而相机假设了方像素、无畸变、光心在图中心。你说 10 经过视角编辑，那这台相机只代表"这张图自洽的相机"。这组数和高度一样属于调节值。
- 每个点各自的差异范围（高度 ±10%、偏移、大小 ±2%、亮度 ±2.5%、轮廓、下沿多露一点）：按 10 里四个点的差异量级定的，四个样本，只能叫调节范围。
- 我在对话里写的"10 里四个点高度 0.45–0.65 mm"作废：那是拿高光位移除以上面的调节值得到的，不是高度实测。
- 把"像升到位的程度"直接当高度比例用：假设。我只在生成器自己身上核过两者大致成正比。

**没验证**
- 顶排、底排升起的样子（顶排挪得多）在这张图里没有实物可对。
- 升起的针投在黑面上的影子：没做。
- 高于 0.45 mm 时露出的杆身（`render()` 里 `ex_side` 那段）：只看过单点静帧，没在片段里用过。
- 原速连续播放的目视判断：只有 Hsinlung 能下。他的尺子是"不想看着电脑渲染的感觉太重"。
- 别的分辨率：文件里所有像素常数（窗口 38、羽化 1.4、阈值 80/42/24 等）都按这张 1086×1448、约 23 像素/mm 的图调的，换图要跟着缩放或重调。

## 踩过的坑（改代码前先看）

1. **相邻点的窗口会重叠。** 每个点在自己的 77×77 窗口里画；早先整窗写回，会把上面那个点已经画好的升起状态用底图盖回去一条（顶排每个点下面一条亮杠）。现在只写这个点自己动过的像素（`render()` 里的 `wm`）。
2. **轮廓不能从阈值斑块拟合。** 有些点一侧在阴影里或被孔沿挡住，斑块是歪的，拟合出的椭圆会带出"双轮廓"。现在轮廓形状由相机给，只用"外侧是纯黑"的那段边缘定圆心（`prep()` 里的 `limb`）。
3. **补纹理时高光会被抹到边上。** 往外延伸纹理用的是 inpaint，源区域里有高光就会拖出一道白。现在先把高光也挖掉求一份只有漫反射的填充，高光只保留在原位（`hl` / `nohl`）。
4. **好坏区域交界会漏一条暗线。** 混合权重在交界处给了暗像素一部分权重。现在坏区先膨胀、好区先腐蚀再模糊（`bad_dark` / `keep`）。
5. **孔口倒角的反光会连进针头斑块。** 清孔时按斑块擦会多擦一块，出缺口。现在斑块擦除限制在轮廓 1.24 倍半径以内（`om`）。
6. **拖影法做杆身不行。** 把针头沿位移方向一步步叠出侧面，会叠出一圈一圈的条纹，像柱子。现在针头是一次重映射，杆身单独用模糊过的同一块纹理。
7. **每帧取值要落在曝光时间里。** 升起曲线按帧给值，线性插值再做快门平均会把回落那一帧冲淡一半。现在每个值在曝光期间保持、在两帧之间过渡（`height()` 里 `up()` 的 0.6/0.4）。
8. 看图时放大用 Lanczos 再转 uint8 会溢出成彩色噪点，那是查看脚本的问题，不是生成结果。

## 还没定的

- **同一根针的快慢。** 现在 `profile()` 每次升起重抽整条曲线，所以同一根针这次准时、下次晚一帧。你的建议（模组共用基本节奏，每根针固定的响应差异，每次只小幅波动）我同意，改 `profile()` 一处：把晚不晚、回落深浅、稳定快慢改成只按点取种子，再叠一个小的逐次扰动。实拍里每个点只动过一次，固定还是变化视频证明不了，这是合理性选择。
- **仓库暂定的三阶段（先到 0.7 再落回 0.45）和实拍对不上。** 实拍是先到七八成、回落、再到位，没有哪一帧比稳住时更"到位"。现在用的是实拍这个形状。"三阶段"原话是 Hsinlung 说的，他指的是哪一种要问他。
- **图案和刷新节奏**（比如一秒刷新两次）：Hsinlung 说现在先不考虑。实拍里只有三次手动动作，看不出刷新周期。
- **成片分辨率和底图**：现在全部建在 11 这张 1086×1448 上。

## 我在对话里说错、后来更正的（别沿用旧说法）

- "接近正俯视" → 视线偏离针轴约 13°（底排）到 32°（顶排），同样依赖上面那台相机。
- "升起在相邻两帧内完成 / 连续基本看不见" → 只是第一下；整个升起约 5 帧，中间高度必须做。
- "0.45–0.65 mm 是量的" → 见上，作废。
