Cheerssom/LingTouchCompanion/hardware/models/3mf/Handle_NewPCB_2026-10-20/HANDOFF_CC_2026-10-27.md

# 交接给 Claude Code：盲杖手柄外壳 PCB1_2，三块壳 + 榫（2026-10-27）

你接手的是 Hsinlung 的灵触盲杖手柄外壳。这份说明分三层：**他的原话**（验收只对这一层）、**已查清的事实**（可以直接用，但用前自己核一遍）、**上一个 Claude 的分析**（是推出来的，不是他的要求，你自己判断，不对就扔）。

## 0. 开工前必读（整份读，别跳）
1. `3mf/Shell_Lessons.md`：R01–R26 需求、P01–P30 问题。注意：出处写"C20，10 行"的是 Claude 写给 Codex 的任务说明，不是他的原话。R13"九个主模组共用一个窗"是 Claude 自己写的，已作废（现在是三条窗加隔条）。R10 尾端封口、R16 直插 J1、R17/R18 不拆壳充电和按电源键，都已被下面第 1 节取代或推后。
2. 原手柄（他找人建的，是基准）：`3mf/Handle/Handle_Print.3mf`，`3mf/Handle/VERIFIED_FACTS.md`（A 节是核过的事实，`check_facts.py` 5 秒复核）。原手柄结构：深腔下壳 + 一块平顶上盖，上盖顶朝下打，侧墙往上长，内腔不用支撑。
3. 本文件夹的 `README.md`、`REPORT_2026-10-23.md`、`build.py`、`slice.py`、`verify.py`。这些是 10/26 终版，他判"不如我之前找人建的模"。
4. 仓库根 CLAUDE.md 的 Handle 一节停在 10/11，已过时，别信。

## 1. 他的原话

### 1.1 这一版的方向（10/27，一字未改）
> 三块壳加榫。下托盘底面平放；前盖是杖口加模组区，顶面做成一整块平面，顶朝下放；后盖是握把加尾段，也一样。
> 打印规则：拓竹默认会给所有朝下、而且比 30° 平的面加支撑，悬空搭桥的地方也一律加。所以每块壳平放以后，不能有朝下的面。不许往里填实心料来躲支撑。
> 盖子和托盘之间的前后两根榫，是为了拆开充电、烧程序，再随时装回去固定。前盖和后盖之间那根，只是打印分块的妥协，作用是把两块盖并回一整块，放在板子上方，比前后两根高。
> 模组区到握把的那段缓坡改陡到 45°，整段归前盖。两块盖之间的缝放在坡底、ESP 前面。

榫的作用，他另一句原话："前后盖加榫是你对于打印的妥协，而上半部分和下半部分加榫是为了便于拆卸和随时固定"。

### 1.2 开工前问他的三条，他的回答
- 杖口段（现在比模组面低 3 mm）要不要加高：**"加支撑也行，不要额外加内容了，把模型整太复杂很麻烦"**。不加高，那段顶面下让拓竹加支撑。
- 圆角（当时问的是"盖子顶面四周那一圈边，手心和拇指摸得到的那圈棱，圆的还是斜切"）：**"第二条你先做成园的吧"**。圆的，接受那圈边底下长一条细支撑。
- 尾端要不要往下的钩：**"第三条不用"**。

### 1.3 长期有效的尺子（原话）
- 基准是原手柄。10/27："我tm完全不觉得你现在做的垃圾比我之前找人建的模好，我没看出你建模的任何优点"。交付时先回答：哪里比原手柄好、哪里不如。
- 握持段尽量窄："盲人朋友体验的时候感觉手握的地方有点太宽了"；"只有握持的地方做窄点就行，别的地方就做宽点也可以啊"。
- 同轴盲杖手柄，杖口 Ø25 沿用原手柄。
- PCB1_2 改不了。用板上两个安装孔定上下高度（Ø1.2）。
- 绿联 PB503 装壳里，放板后的尾段、居中在杖轴上。J1 怎么连是他的事："我接根线完全没问题，并且tm也不需要接线"。外壳不为接线建模。
- 先把基础的做对："我tm要充电会自己拆开自己冲……你知道自己不能一次做好还tm要把所有能想到的点都加进去？"。充电口、电源键、SW2 开孔，等他说了再做。
- 支撑："支撑是需要bambu自己分析自己生成的"。改模型，不找角度："我tm自己会找角度，我是让你改模型"。锁合"按能卡住就行甚至保证不了也无所谓"。
- 榫卯："类似榫卯结构插进去就行"，"只要你别直接卡死就行"，"上下都挖槽然后用一个榫卡住"（单独打印的榫，插进两块壳上的槽）。长在壳上的凸起不行（"用几次都掉了"）。能打印的别让他另买。
- 开口：模组区三条长窗，条间有隔条（"中间加线"，不许删）；U48 单独开窗（"要单独开窗啊，不然tmu48还有啥用"）；SW1 普通圆孔；不要按钮加长件（"我tm不需要按钮增高"）；触觉面上不许有螺钉头、螺母六角窝。开口不为躲支撑变形。
- 模组固定顶面和壳面齐平。
- 尾端不要封口墙（"不用后盖"）；后榫放在充电宝后面。
- 左右对称；整体尽量短小、看起来一体；"别做太麻烦"；"还是尽量减小体积"。
- 判断不了哪个部件有啥用，就问他，别自己删。

### 1.4 他否掉的，别再提
靠倾斜或特定摆放躲支撑；为某个摆放削斜面；窗口做成尖头、斜收口；一个 3×3 大窗；按钮加长件；外购钢销；长在壳上的凸起销；竹签/木棍；直方条销；弹片、倒钩、劈缝、压筋、硬止挡这类复杂锁合；**往内腔里填实心料来减支撑**（10/26 的 45° 斜顶 haunch，原话："tm你不会以为加这种东西就会不需要拓竹自己加支撑了吧，加这堆玩意又没用又tm让模型变重"）；顶面紧固件/六角窝；侧面外凸护罩；长绕线；为 J1 偏心放宽尾段或加转接线。

## 2. 已查清的事实（10/27，用前自己再核）
- 拓竹默认（`models/h2c_process.json`）：support_threshold_angle 30，bridge_no_support 0，max_bridge_length 0，support_type tree(auto)。即朝下且比 30° 平的面、任何悬空搭桥，都会加支撑。
- 高度：模组面 FACE = 26.504；握把顶 GRIP_TOP = 21.554（ESP 定的）；尾段顶 BANK_TOP = 21.527；底 GRIP_BOTTOM = −10.5，尾段 BOTTOM = −10.473；杖口段顶 = AXIS+18 = 23.527；AXIS = 5.527。后盖顶和尾段顶只差 0.027，托盘底同理，可以直接拉平成一个面。
- X 位置（板坐标，build.py 同一套）：三条模组窗 X 23.47–45.17；U48 窗 X 47.47–54.17；SW1 中心 (15.92, −0.38)；ESP 板前端 X 72.425；两个安装孔 (1.143, 15.240)、(134.366, −15.113)。
- X 55–76 一段板上器件最高 Z = 4.1（U9/U7/U8），这段最高的是 U23 到 3.9。中间那根榫要从这上面过。
- 10/26 拓竹实切：托盘自己有 0.6 g 支撑，在底边那圈。原因是 GPT 给托盘底边加的"先 45° 再圆"斜面切在圆弧中段，贴床那一小段圆弧仍比 30° 平。
- 10/26 的上壳整块顶朝上、分缝朝下打，所以杖孔上方做了 45° 尖顶（build.py 的 `roof`），天线槽（`FPC` recess，Z 20.6–21.2、宽 10、X −25 到 −0.2）是一条 0.55 mm 高的扁缝。现在前盖改成顶朝下打，这两样的前提都变了。
- `build.py` 读安装孔要用 `../../.pcba-workflow/pcb1_2-recheck-20261018/live-check-evidence.json`，你在他电脑上能直接读到。

## 3. 上一个 Claude 的分析（推出来的，不是他的要求，自己判断）
- 坡的位置：U48 窗后留一点实料就开始 45° 往下，落差 26.504−21.554=4.95，坡长约 5 mm，缝落在约 X 61，离 ESP 还有 11 mm。这样握把高度那段更长，更合"握持段尽量窄"。原话只说了"坡底、ESP 前面"，没说坡从哪开始。
- 中间那根榫要是把前后两根的沙漏截面直接转 90°，沙漏两侧的斜边会接近水平，盖子顶朝下打时，槽里就有一面朝下、比 30° 平。一个做法是截面上边平、下边是两道 45° 斜边在缝处顶成一个尖（像倒 V 的缺口），两块盖的槽都只剩竖面、平的顶和 45° 斜面。两块盖往外分开时，斜面把榫往上挤，平顶压住，就卡住了。榫穿过两块盖的侧壁，横跨腔体，高度大约 Z 5–12（器件最高 4.1，后盖内顶 19.15）。榫头要不要跟侧面齐平，自己判断：它在握把前端，手会碰到；它又不用于拆卸。
- 天线槽：前盖顶朝下以后，扁缝就成了内部搭桥，打不出来。思路是改成"平面一侧贴天线、另一侧 45°"的三角槽，在杖孔段跟杖孔通着，前盖拆下来以后从杖孔那半边就能放天线。杖孔本身可以回到正圆。
- 托盘里放板子的两条长边台阶（Z −1.3 到 0），底下是一个朝下的小平面，按规则也会加支撑，要看切片结果再定改不改。
- 托盘底边：他回答"圆的"时，问的只是盖子顶边。托盘底边原来是同一个问题里的另一半。上一个 Claude 打算也做成圆的，没跟他确认过。你要么照做并在汇报里说一句，要么问他。

## 4. 这件事上犯过的错（具体）
- 10/26 交终版时报"逐条对过你的原话"，实际对的是 Claude 自己的转述。GPT 说"外形不加高就做不成自撑斜顶"，被直接当了结论。他一打开就骂"tm这么多垃圾支撑"。
- 10/26 统计支撑用的是 GPT 3MF 里自带的 G-code（开了"仅从热床生成"，还放了支撑屏蔽体），得出约 13 g，实际约三分之一。**支撑量只认拓竹默认自动支撑、不带任何屏蔽，重新切。**
- 10/23 只核了数据（件数、碰撞、支撑点、截面）就报"可以拿去打印、六件"，没看几何，也没发现其中三件是加出来的按钮加长件。放行前要真看模型，逐件核有没有他不要的零件。
- 10/23 把两块盖合成整块上壳，自己写了"支撑只出现在壳里面"，汇报时却只说"外表面一点支撑都没有"。
- 10/21、10/23：J1 偏心、要不要加线，被他否了四次。别再提。
- 10/26："外形一律不准为支撑改"是 Claude 自己加的，跟他说的"改模型"冲突。别给自己加他没说过的约束。
- 10/26 跟他讲"一根直条横穿合缝就能锁住"，错了：上下壳是靠沙漏截面锁住的。
- 10/27：他说"加了"什么，先去模型里找加了什么。每个零件先想清楚它为什么存在，再说它怎么受力。

## 5. 要做的事
1. 读完第 0 节，再动 `build.py`。这次是结构变化：托盘、前盖、后盖，前榫、后榫、中间榫。保留已核过的硬件参考、窗口、安装孔、销位。删掉 haunch。打印件就是这三块壳加三根榫，别多出别的零件。
2. 每块壳按规定的面贴床：托盘底面朝下，两块盖顶面朝下，不旋转、不找角度。逐面查：除了贴床那个面，有没有朝下且比 30° 平的面、有没有搭桥。例外只有他认可的两处：杖口段顶面下（他说"加支撑也行"），以及圆角贴床那一圈细带。
3. 用 `slice.py` 调拓竹默认设置真切（支撑开、无屏蔽、无涂抹），按件、按位置报支撑在哪、多少克。上面两处以外还有支撑，就去改模型，别靠参数。
4. 跑 `verify.py`。它是给两块壳写的，要跟着改成三块壳加三根榫，碰撞、装配、拆盖都要查。拆的检查要分开：盖和托盘之间要能拆；前后两块盖之间不用拆。
5. 出图，自己真看：外观、顶朝下打印姿态、杖口、坡、缝、三根榫的截面。
6. 原地更新本文件夹的 README、REPORT、两个 3MF，不留旧版。

## 6. 回他的话怎么写
- 中文，短。先给结论，再用大白话说原因。不列尺寸表，不堆术语，不用自己造的部位名。指位置用他看得懂的词（杖口、模组区、坡、握把、尾巴、托盘、前盖、后盖），要指具体地方就配一张标了记号的图。
- 第一句回答：跟原手柄比，哪里好、哪里不如。
- 支撑只报拓竹真切的结果，说清在哪。
- 他没要的东西不加。有拿不准的，只问会改变做法的问题，每个问题说清它决定什么。
- 别估时间，别因为时间砍范围。
