Cheerssom/LingTouchCompanion/docs/plans/HANDOFF_2026-10-28.md

# 交接：仓库按人重构 + 端侧工程骨架（2026-10-28）

写给在分支 `claude/trusting-brown-h7384r` 上接手的 Claude Code。来源是 claude.ai 上和 Hsinlung 的对话，你对那段对话一无所知，以本文为准。做完后 Hsinlung 在本地合并。

本文分两类内容：**"他说的"** 是 Hsinlung 本人的要求，验收以它为准；**"Claude 判断的"** 是对话里另一个 Claude 做的技术决定，他已同意整体方向，照做即可，发现明显错误时在报告里写清证据再改，不要静默偏离。

材料都在 `handoff_2026-10-28/`：
- `cs30_protocol/`：10/25 在他电脑上做的 CS30 免 SDK 取流可行性结论（`REPORT.md` 先读）、41 条启动控制请求 `startup_sequence.json`、PC 端独立实现 `independent_proof.py`、两份 763 字节标定 blob、3 张真实深度帧 `reference_*.bin`（640×480 uint16 小端毫米）、Android libusb 说明。
- `plans/`：视觉同学的方案、交互同学的 App 方案、Claude 对视觉方案的审阅意见要点。

## 1. 他说的

- 要真做出来，不只是给答辩用。
- CS30 直插手机或平板，所有计算都在手机/平板上。头上只放 CS30 和 IMU，不放主板。
- 安卓、鸿蒙各至少有一款机型能跑。iOS 先不管（原话"反正现在没比赛，有问题再说"）。先以鸿蒙平板为主，因为马上要参加华为的比赛；平台开发顺序"其实无所谓"。
- 点阵 9 列 × 6 行，每格 40 cm：左右 ±1.8 m，前方 1.0–3.4 m。感知按 0–5 m 预留冗余。
- SpatialLM 保留，要能在端侧跑。
- 技术栈：前端按部署的平台各自选，后端（本文叫"核心"）统一用 C++。以后的语言交互模型、视觉识别模型都放进核心。
- 大范围重构现有项目，把每个人的部分放到单独的文件夹里。
- 9/29 为华为比赛做的版本（`LingTouch.zip`）"本来就只是应付比赛的，运不运行无所谓"。

## 2. Claude 判断的（已定）

**架构。** 一个共用的 C++17 核心（CMake），加两层原生外壳：安卓 Kotlin，经 JNI 调核心；鸿蒙 ArkTS，经 Node-API 调核心。核心里不能出现任何平台相关依赖，以后加 iOS 只多一层 Swift 外壳。外壳只放界面和只能用平台接口的东西：USB 的打开与授权、蓝牙、录音放音、读屏、后台保活、地图显示。

**CS30 取流。** 拆帧和解析在核心里，两边共用。
- 安卓：Kotlin 里 UsbManager 授权并拿到 fd，交给核心；核心用上游 libusb 的 Android 方案（`libusb_wrap_sys_device`）做等时传输。设备是 UVC 类（0x0e），内核若已绑定 uvcvideo，按 REPORT 用 detach/force claim 拿回来。
- 鸿蒙：`@ohos.usbManager` 的 `usbSubmitTransfer` 支持实时（等时）传输，要求 API 18（HarmonyOS 5.1.0）及以上，所以 `compatibleSdkVersion` 至少 5.1.0(18)。（2026-10-28 更正：原写 API 16 / 5.0.4；OpenHarmony 的 usbManager 文档把 `usbSubmitTransfer`、`UsbDataTransferParams`、`UsbEndpointTransferType` 标为 18+。）ArkTS 收到等时包后经 Node-API 交给核心拆帧。这一层每秒约 8.6 MB，扛不扛得住要真机测，代码里把收包和拆帧之间的接口做成按批传入，别每包一次跨层调用。
- 启动序列、超时（控制请求 15 s，Commit 正常要约 2.36 s）、挂等时传输的时机、拆帧规则、停流顺序全部照 `REPORT.md`，序列数据从 `startup_sequence.json` 生成，不要手抄。

**推理与语音（本次只定接口，不集成库）。** 核心里定统一的推理后端接口：鸿蒙接 MindSpore Lite（系统内置，可用麒麟 NPU，有 C API），安卓接 ONNX Runtime。大模型（SpatialLM 的语言部分、agent）用 llama.cpp。语音识别和合成用 sherpa-onnx（官方支持鸿蒙和安卓，离线，C API）。SpatialLM 的点云编码器以后要把稀疏卷积改写成"预算邻居表 + 取特征 + 矩阵乘"，本次不做。

**点阵编码。** 单独一个模块，本次只实现旧板协议：BLE 服务 FFE0，写 FFE1，15 字节，每字节低 6 位对应一个模组；FFE3 通知 0x01 刷新完成、0x04 按键扫描请求。位映射以 `visionss/frame_converter.py` 为准（硬件验证过，含 MODULE_ROT180 开关，不要重猜）；9/29 比赛版里的 `hw/phone/entry/src/main/ets/frame/TactileFrame.ets` 与它逐字节对过，可作 ArkTS 参考。9×6 放进旧板 10×9 逻辑栅格的最近 6 行（两者都从 1.0 m 起、每格 40 cm），其余 4 行全平。新板是 9+1 个模组，协议等固件定了再加一个编码器，别的模块不动。

**状态 2 在触点上表示成平还是凸，他还没定。** 编码函数必须显式传入这个策略，不设默认值；配置里写明"待 Hsinlung 定"。

**几何链与 0/1/2（初版，视觉同学可以改）。** 坐标：x 向右、y 向前（相机前方在地面的投影）、z 向上，原点为相机在地面的垂直投影，地图跟随头部朝向。第一阶段不用 IMU：镜头离地高度和俯仰、横滚由地面拟合得到，拟合失败输出降级状态、整张图为 2。高度带 0.10–1.90 m，可配置。规则见 `plans/视觉方案审阅意见要点_Claude.md`："0 = 格内 4×4 个 10 cm 小块都有地面点且高度带内无点"，1 优先于 0，其余一律 2。无效值：0、恰好 1、小于 100 mm；疑似相位绕回的孤立近点（四周大多是无效像素）也判无效，阈值做成参数。边缘飞点滤波做成参数，默认偏松，保住细腿。所有门槛都是参数，不要写死。

**深度相机内参。** 先尝试从两份标定 blob（protobuf，763 字节）无 schema 解码出内参。解不出可信值时，可以用规格书视场推一组临时内参，但必须在配置和报告里标"临时值，非标定"，并保留以后换真标定的入口。深度是光轴 Z 还是径向距离也要在报告里写清依据；查不到就写"未确认"，代码按可切换处理。

**界面不放假数据。** 没连设备就显示"未连接"，拿不到的值不显示。这是他对比赛提交件定过的规矩，App 照此执行。

**后台保活。** 安卓用前台服务。鸿蒙申请长时任务，声明 bluetoothInteraction 和 location；"计算任务"类型只开放给 2in1 设备，平板用不了。能否在息屏下持续取流和计算只能真机测，代码先按这两个类型写好。

## 3. 任务 A：按人重构

先 `git status` 确认干净。用 `git mv` 移动，保留历史。目标布局：

```
README.md            布局、每个文件夹归谁、各入口（重写）
CLAUDE.md            只留仍然有效的环境说明（Python 环境路径等），旧的 10/09 审阅内容移进 archive
core/                大家共用：类型、接口、点阵编码、顶层 CMake
perception/          视觉同学（CS30 算法）
  native/            C++：CS30 取流与拆帧、几何、0/1/2
  cs30/              CS30 协议材料（从 handoff_2026-10-28/cs30_protocol 移入）
  lab/               Python 实验位（他的 windows_obstacle_grid、spatiallm_demo 不在本仓库，留 README 说明，别去找）
agent/               对话 agent 同学
  native/            C++：agent、语音接口（本次只放接口）
  backend/           原 app/backend（Node.js：导航、命令解析）
apps/                交互同学
  android/
  harmony/
hardware/            Hsinlung
  firmware/          原 firmware/
  models/            原 3mf/、BrailleModule/、BrailleModule_Video/
  pcb/               原 PCB_REDESIGN_2026-10-08/
  headset/           原 glass.md
  tools/             原 ble_mobile_controller.html、ble_testbench.html
experiments/chi2027/ Hsinlung 的论文实验通路：原 visionss/、single_point/、TOPDOWN_VALIDATION.md、validate_distance.py、check_balloon_depth.py、prep_new_pics.py、depth_preview.html
docs/plans/          方案文档（handoff_2026-10-28/plans 移入）、本交接、lingtouch.md
archive/             不删，只移：app/frontend（uni-app）、vision/、LingTouch.zip、旧 CLAUDE.md
```

要求：
- **只移动，不改内容**的范围：`3mf/` 下全部模型与脚本（本分支最新提交正是手柄榫卯的活，`Handle_TwistKey_2026-10-27/` 一个字节都不改）、固件代码、PCB 文件。
- 修所有引用：README 和各子 README 里的相对链接、Python import、脚本里的相对路径。注意 `visionss/depth_runner.py` 用 `_REPO_ROOT / "Depth-Anything-V2"` 找权重：`Depth-Anything-V2/`、`pics/`、权重、实验日志这些在他本机、不进 Git，合并后仍在仓库根目录。移动后这些路径必须仍能解析到仓库根，改成可靠地定位仓库根或用环境变量，别靠"往上几层"。
- 能在云端跑的都跑一遍：Python 全部 `py_compile`，各脚本 `--help` 或能无硬件启动的入口跑起来，`3mf/regenerate.py` 这类依赖本机运行时的写明没跑。
- 提交拆开，方便他看：第 1 个提交只有移动；第 2 个提交只有引用修复；骨架另起提交。

## 4. 任务 B：端侧工程骨架

目标只有一个：把最容易卡住的连接点打通。**核心能被两边调用，两边能从 CS30 收到深度帧，两边能通过蓝牙给手柄发一帧点阵。**

- **core/ + perception/native/（C++17，CMake，无平台依赖）**
  - 类型：深度帧（含时间戳、内参版本）、9×6 栅格（状态 0/1/2 和诊断信息）、各模块接口（取流源、地面姿态、几何栅格、推理后端、大模型、语音、点阵编码）。接口按视觉方案第 9 节的模块划分命名，没实现的只留接口。
  - 实现：CS30 等时包 → 614400 字节帧的拆帧器；启动序列表；深度 → 点 → 地面拟合 → 高度带 → 9×6 栅格与 0/1/2；旧板点阵编码。
  - 主机测试（云端能跑）：拆帧器用合成的包流测（FID 翻转、EOF、错误位、空包）；几何用合成场景测（已知高度的地面加一个已知位置的箱子，断言箱子格为 1、身后被挡的格为 2、看全地板的格为 0）；3 张真实参考帧跑一遍不崩、输出确定、打印栅格；编码器与 `frame_converter.py` 的 `grid_to_bytes` 在同一批输入上逐字节对比。
- **apps/android/（Kotlin）**：USB 授权 → 打开 CS30 → 核心开流 → 读屏可读的栅格显示 → 连接手柄写一帧；前台服务。云端能装 Android SDK/NDK 就把 APK 编出来，装不了就只写代码，并在报告里写明。
- **apps/harmony/（ArkTS，Stage 模型）**：usbSubmitTransfer 收包 → Node-API 交给核心 → 栅格显示 → BLE 写一帧；声明长时任务。云端大概率没有鸿蒙 SDK，写好代码，由他在 DevEco 编译。BLE 部分可以参考 9/29 比赛版里的 `hw/phone/entry/src/main/ets/device/HandleLink.ets`。
- 这次不做：SpatialLM、YOLO、agent、语音、导航、地图。只留接口位置。

## 5. 写一份真机验收清单

放在 `docs/device_tests.md`，他合并后在本地照着测：
1. 安卓：CS30 开流收帧，与电脑上厂家 SDK 逐像素对比（方法同 10/25：同曝光帧哈希一致），记录帧率。
2. 鸿蒙平板：同上，另记 usbSubmitTransfer 路径的帧率和丢包。不够就去查鸿蒙 C 层的 USB 接口（USB DDK），这条没人查过。
3. 两边喂同一帧，核心输出的 9×6 完全一致。
4. 息屏 / 后台至少 10 分钟，持续取流、计算、发蓝牙不停。
5. 发一帧到手柄（旧板 V2.8 固件），手摸确认位置和方向对（注意 ROT180）。
6. RGB 流和标定能否走同一套协议拿到：SET_CUR 0xa100 的类型字段 `02` 是深度，RGB 的值未知，需要像 10/25 那样抓 SDK 开 RGB 时的包。

## 6. 规矩

- 只在本分支提交、推送；不碰 main，不 force push。
- 不删除任何文件，旧东西进 `archive/`。
- 厂家 SDK 的二进制、反汇编、strings 不进仓库。
- 被卡住时（缺 SDK、编译不了、没设备）：照常写完代码，在报告里写清哪一步没编、没测、原因是什么。不要用假数据或桩把它"跑通"。
- "测过"只指真的跑过的东西；没跑的写"未运行"。
- 完成后把长报告写进 `docs/REPORT_2026-10-28.md`：做了什么、每个提交干什么、跑了哪些测试与结果、没验证的清单、你改动 Claude 判断的地方及理由。给他的最终回复只要几行：分支、提交列表、报告位置、最要紧的未验证项。
