Cheerssom/LingTouchCompanion/hardware/pcb/PCB_V2_ROUTER_RULES_2026-10-18/net-rule-assignment.csv

net | current_A | track_rule | via_rule | outer_default_mm | inner_default_mm | basis
DRV01_A |  | V2_SIGNAL | V2_VIA_SIGNAL | 0.18 | 0.18 | signal or coil (<=0.2 A)
DRV01_B |  | V2_SIGNAL | V2_VIA_SIGNAL | 0.18 | 0.18 | signal or coil (<=0.2 A)
DRV01_C |  | V2_SIGNAL | V2_VIA_SIGNAL | 0.18 | 0.18 | signal or coil (<=0.2 A)
DRV01_D |  | V2_SIGNAL | V2_VIA_SIGNAL | 0.18 | 0.18 | signal or coil (<=0.2 A)
DRV01_E |  | V2_SIGNAL | V2_VIA_SIGNAL | 0.18 | 0.18 | signal or coil (<=0.2 A)
DRV01_F |  | V2_SIGNAL | V2_VIA_SIGNAL | 0.18 | 0.18 | signal or coil (<=0.2 A)
DRV01_SMA |  | V2_SIGNAL | V2_VIA_SIGNAL | 0.18 | 0.18 | signal or coil (<=0.2 A)
DRV02_A |  | V2_SIGNAL | V2_VIA_SIGNAL | 0.18 | 0.18 | signal or coil (<=0.2 A)
DRV02_B |  | V2_SIGNAL | V2_VIA_SIGNAL | 0.18 | 0.18 | signal or coil (<=0.2 A)
DRV02_C |  | V2_SIGNAL | V2_VIA_SIGNAL | 0.18 | 0.18 | signal or coil (<=0.2 A)
DRV02_D |  | V2_SIGNAL | V2_VIA_SIGNAL | 0.18 | 0.18 | signal or coil (<=0.2 A)
DRV02_E |  | V2_SIGNAL | V2_VIA_SIGNAL | 0.18 | 0.18 | signal or coil (<=0.2 A)
DRV02_F |  | V2_SIGNAL | V2_VIA_SIGNAL | 0.18 | 0.18 | signal or coil (<=0.2 A)
DRV02_SMA |  | V2_SIGNAL | V2_VIA_SIGNAL | 0.18 | 0.18 | signal or coil (<=0.2 A)
DRV03_A |  | V2_SIGNAL | V2_VIA_SIGNAL | 0.18 | 0.18 | signal or coil (<=0.2 A)
DRV03_B |  | V2_SIGNAL | V2_VIA_SIGNAL | 0.18 | 0.18 | signal or coil (<=0.2 A)
DRV03_C |  | V2_SIGNAL | V2_VIA_SIGNAL | 0.18 | 0.18 | signal or coil (<=0.2 A)
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
M8.PIN8 |  | V2_SIGNAL | V2_VIA_SIGNAL | 0.18 | 0.18 | signal or coil (<=0.2 A)
M8.PIN9 |  | V2_SIGNAL | V2_VIA_SIGNAL | 0.18 | 0.18 | signal or coil (<=0.2 A)
M9.PIN11 |  | V2_SIGNAL | V2_VIA_SIGNAL | 0.18 | 0.18 | signal or coil (<=0.2 A)
M9.PIN2 |  | V2_SIGNAL | V2_VIA_SIGNAL | 0.18 | 0.18 | signal or coil (<=0.2 A)
M9.PIN3 |  | V2_SIGNAL | V2_VIA_SIGNAL | 0.18 | 0.18 | signal or coil (<=0.2 A)
M9.PIN4 |  | V2_SIGNAL | V2_VIA_SIGNAL | 0.18 | 0.18 | signal or coil (<=0.2 A)
M9.PIN6 |  | V2_SIGNAL | V2_VIA_SIGNAL | 0.18 | 0.18 | signal or coil (<=0.2 A)
M9.PIN8 |  | V2_SIGNAL | V2_VIA_SIGNAL | 0.18 | 0.18 | signal or coil (<=0.2 A)
M9.PIN9 |  | V2_SIGNAL | V2_VIA_SIGNAL | 0.18 | 0.18 | signal or coil (<=0.2 A)
MAIN_BST |  | V2_SIGNAL | V2_VIA_SIGNAL | 0.18 | 0.18 | signal or coil (<=0.2 A)
MAIN_FB |  | V2_SIGNAL | V2_VIA_SIGNAL | 0.18 | 0.18 | signal or coil (<=0.2 A)
MAIN_ILIM |  | V2_SIGNAL | V2_VIA_SIGNAL | 0.18 | 0.18 | signal or coil (<=0.2 A)
MAIN_MODE |  | V2_SIGNAL | V2_VIA_SIGNAL | 0.18 | 0.18 | signal or coil (<=0.2 A)
MAIN_SS |  | V2_SIGNAL | V2_VIA_SIGNAL | 0.18 | 0.18 | signal or coil (<=0.2 A)
MAIN_SW | 4.1 | V2_POWER | V2_VIA_POWER | 0.5 | 0.5 | 4.1 A; widen by hand / pour after routing where it carries >1 A
MAIN_VCC_INT |  | V2_SIGNAL | V2_VIA_SIGNAL | 0.18 | 0.18 | signal or coil (<=0.2 A)
OE# |  | V2_SIGNAL | V2_VIA_SIGNAL | 0.18 | 0.18 | signal or coil (<=0.2 A)
PGOOD |  | V2_SIGNAL | V2_VIA_SIGNAL | 0.18 | 0.18 | signal or coil (<=0.2 A)
RCLK |  | V2_SIGNAL | V2_VIA_SIGNAL | 0.18 | 0.18 | signal or coil (<=0.2 A)
RUN_LED_A |  | V2_SIGNAL | V2_VIA_SIGNAL | 0.18 | 0.18 | signal or coil (<=0.2 A)
SER_02 |  | V2_SIGNAL | V2_VIA_SIGNAL | 0.18 | 0.18 | signal or coil (<=0.2 A)
SER_03 |  | V2_SIGNAL | V2_VIA_SIGNAL | 0.18 | 0.18 | signal or coil (<=0.2 A)
SER_04 |  | V2_SIGNAL | V2_VIA_SIGNAL | 0.18 | 0.18 | signal or coil (<=0.2 A)
SER_05 |  | V2_SIGNAL | V2_VIA_SIGNAL | 0.18 | 0.18 | signal or coil (<=0.2 A)
SER_06 |  | V2_SIGNAL | V2_VIA_SIGNAL | 0.18 | 0.18 | signal or coil (<=0.2 A)
SER_07 |  | V2_SIGNAL | V2_VIA_SIGNAL | 0.18 | 0.18 | signal or coil (<=0.2 A)
SER_08 |  | V2_SIGNAL | V2_VIA_SIGNAL | 0.18 | 0.18 | signal or coil (<=0.2 A)
SER_09 |  | V2_SIGNAL | V2_VIA_SIGNAL | 0.18 | 0.18 | signal or coil (<=0.2 A)
SER_10 |  | V2_SIGNAL | V2_VIA_SIGNAL | 0.18 | 0.18 | signal or coil (<=0.2 A)
SMA_BST |  | V2_SIGNAL | V2_VIA_SIGNAL | 0.18 | 0.18 | signal or coil (<=0.2 A)
SMA_FB |  | V2_SIGNAL | V2_VIA_SIGNAL | 0.18 | 0.18 | signal or coil (<=0.2 A)
SMA_SW | 1.0 | V2_POWER | V2_VIA_POWER | 0.5 | 0.5 | 1.0 A; widen by hand / pour after routing where it carries >1 A
SRCLK |  | V2_SIGNAL | V2_VIA_SIGNAL | 0.18 | 0.18 | signal or coil (<=0.2 A)
SRCLR# |  | V2_SIGNAL | V2_VIA_SIGNAL | 0.18 | 0.18 | signal or coil (<=0.2 A)
SW_VIN |  | V2_SIGNAL | V2_VIA_SIGNAL | 0.18 | 0.18 | signal or coil (<=0.2 A)
U1.SER |  | V2_SIGNAL | V2_VIA_SIGNAL | 0.18 | 0.18 | signal or coil (<=0.2 A)
USB_CC1 |  | V2_SIGNAL | V2_VIA_SIGNAL | 0.18 | 0.18 | signal or coil (<=0.2 A)
USB_CC2 |  | V2_SIGNAL | V2_VIA_SIGNAL | 0.18 | 0.18 | signal or coil (<=0.2 A)
USB_DVDT |  | V2_SIGNAL | V2_VIA_SIGNAL | 0.18 | 0.18 | signal or coil (<=0.2 A)
USB_EN |  | V2_SIGNAL | V2_VIA_SIGNAL | 0.18 | 0.18 | signal or coil (<=0.2 A)
USB_ILM |  | V2_SIGNAL | V2_VIA_SIGNAL | 0.18 | 0.18 | signal or coil (<=0.2 A)
USB_OVLO |  | V2_SIGNAL | V2_VIA_SIGNAL | 0.18 | 0.18 | signal or coil (<=0.2 A)
V5S | 0.5 | V2_POWER | V2_VIA_POWER | 0.5 | 0.5 | 0.5 A; widen by hand / pour after routing where it carries >1 A
VBUS | 3.0 | V2_POWER | V2_VIA_POWER | 0.5 | 0.5 | 3.0 A; widen by hand / pour after routing where it carries >1 A
VBUS_DIV |  | V2_SIGNAL | V2_VIA_SIGNAL | 0.18 | 0.18 | signal or coil (<=0.2 A)
VCC |  | V2_PLANE_FANOUT | V2_VIA_POWER | 0.4 | 0.4 | In4 VCC plane: short pad-to-via fan-out only
VCCS | 1.0 | V2_POWER | V2_VIA_POWER | 0.5 | 0.5 | 1.0 A; widen by hand / pour after routing where it carries >1 A
VCC_LOGIC |  | V2_SIGNAL | V2_VIA_SIGNAL | 0.18 | 0.18 | signal or coil (<=0.2 A)
VIN_SYS | 3.0 | V2_POWER | V2_VIA_POWER | 0.5 | 0.5 | 3.0 A; widen by hand / pour after routing where it carries >1 A
