Cheerssom/LingTouchCompanion/hardware/models/BrailleModule_Video/pin_lift_handoff/out/lingchu_json_frames.csv

frame | t_ms | row | col | target | level | height_mm
0 | 0.0 | 2 | 6 | 0 | 0.0 | 0.0
0 | 0.0 | 2 | 7 | 0 | 0.0 | 0.0
0 | 0.0 | 3 | 6 | 0 | 0.0 | 0.0
0 | 0.0 | 3 | 7 | 0 | 0.0 | 0.0
0 | 0.0 | 4 | 6 | 0 | 0.0 | 0.0
0 | 0.0 | 4 | 7 | 0 | 0.0 | 0.0
0 | 0.0 | 5 | 6 | 0 | 0.0 | 0.0
0 | 0.0 | 5 | 7 | 0 | 0.0 | 0.0
0 | 0.0 | 6 | 6 | 0 | 0.0 | 0.0
0 | 0.0 | 6 | 7 | 0 | 0.0 | 0.0
0 | 0.0 | 7 | 6 | 0 | 0.0 | 0.0
0 | 0.0 | 7 | 7 | 0 | 0.0 | 0.0
0 | 0.0 | 8 | 6 | 0 | 0.0 | 0.0
0 | 0.0 | 8 | 7 | 0 | 0.0 | 0.0
0 | 0.0 | 9 | 6 | 0 | 0.0 | 0.0
0 | 0.0 | 9 | 7 | 0 | 0.0 | 0.0
1 | 33.333 | 2 | 6 | 0 | 0.0 | 0.0
1 | 33.333 | 2 | 7 | 0 | 0.0 | 0.0
1 | 33.333 | 3 | 6 | 0 | 0.0 | 0.0
1 | 33.333 | 3 | 7 | 0 | 0.0 | 0.0
1 | 33.333 | 4 | 6 | 0 | 0.0 | 0.0
1 | 33.333 | 4 | 7 | 0 | 0.0 | 0.0
1 | 33.333 | 5 | 6 | 0 | 0.0 | 0.0
1 | 33.333 | 5 | 7 | 0 | 0.0 | 0.0
1 | 33.333 | 6 | 6 | 0 | 0.0 | 0.0
1 | 33.333 | 6 | 7 | 0 | 0.0 | 0.0
1 | 33.333 | 7 | 6 | 0 | 0.0 | 0.0
1 | 33.333 | 7 | 7 | 0 | 0.0 | 0.0
1 | 33.333 | 8 | 6 | 0 | 0.0 | 0.0
1 | 33.333 | 8 | 7 | 0 | 0.0 | 0.0
1 | 33.333 | 9 | 6 | 0 | 0.0 | 0.0
1 | 33.333 | 9 | 7 | 0 | 0.0 | 0.0
2 | 66.667 | 2 | 6 | 0 | 0.0 | 0.0
2 | 66.667 | 2 | 7 | 0 | 0.0 | 0.0
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
