Cheerssom/LingTouchCompanion/archive/SCHEMATIC_TASK_ROLLBACK_2026-10-11.md

# 原理图任务的问题整理与还原记录

日期：2026-10-11。按 Hsinlung 的要求停止本轮原理图检查、设计和固件修改，撤回此前的“检查通过”结论。

## 我的处理问题

1. **把检查和必要修复扩大成复杂改版。** 在没有充分证明必要性的情况下，新增了 34 件 USB 相关器件，没有落实“哪个简单选哪个”的要求。
2. **用新增电路解决自己选型带来的条件。** 新控制器需要额外供电、启动和监控电路，这些新增件并不对应 34 个原设计错误，却扩大了设计和审查负担。我没有先比较更小的改动是否足够。
3. **通过结论超过了证据。** 文件、引脚和部分参数核对，不能证明整机可靠；没有完成实际通电验证和当前 CAD 的完整 ERC／DRC，就不能声称原理图“完全没问题”。新加器件也没有因此获得可靠性保证。
4. **没有正确处理你的质疑。** 你已经表达简单优先，我仍反复提问；你质疑改动过多时，我继续提出改版方向和泛泛回应，没有先核清必要性并直接回答。
5. **扩大了修改范围。** 在原理图任务中同时改了正式固件和固件说明，使你需要接受和复核的内容进一步增加。

## 还原范围

状态：已完成还原，并核对文件内容。

- 已将 `firmware/braille_15module_prod/braille_15module_prod.ino` 和 `firmware/README.md` 从本轮修改前的备份逐字节恢复，原有换行保持一致。
- 已移除本轮生成的 `PCB_SCHEMATIC_AUDIT_2026-10-11/`、`PCB_SCHEMATIC_FIX_2026-10-11/` 和 `.build/firmware-fix-20261011/`，包括新增原理图／PCB 副本、审查报告、工具和构建产物。三处目录均已确认不存在。
- 原始 `PCB_REDESIGN_2026-10-08/Revised_Schematic.epro`，以及 `PCB_RELAYOUT_2026-10-11/` 中两块原有布局，均与本轮审查开始时的文件哈希一致；没有被覆盖。
- 其他工作目录、既有未提交内容和项目说明保留。还原前后逐项核对的其他已跟踪修改／删除状态均未改变；没有执行 Git 整体回退。
- 没有向当前 CAD 导入本轮改版，也没有烧录固件。没有继续设计或检查。

恢复后的固件文件 SHA256：

| 文件 | SHA256 |
| --- | --- |
| `firmware/braille_15module_prod/braille_15module_prod.ino` | `afacfbeabfb87673b3433e049022ebeea285a2e91b416872cf7948680b141543` |
| `firmware/README.md` | `0510753ec58025188bc82f76bc3b3817a467fd4884733c03b998ad1461588892` |

本轮只保留这份问题整理与还原记录。

这份文件记录处理失误与还原结果，不是原设计的电气签核。
