Cheerssom/LingTouchCompanion/hardware/models/3mf/Handle/GripStudy/AdultRightHand.png

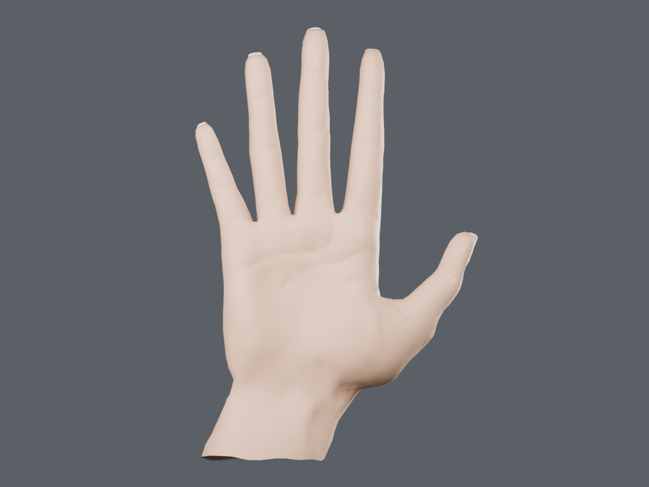
hardware/models/3mf/Handle/GripStudy/AdultRightHand.png
