Cheerssom/LingTouchCompanion/hardware/models/3mf/Handle_NewPCB_2026-10-20/references/PCB1_2_module_socket_fit.png

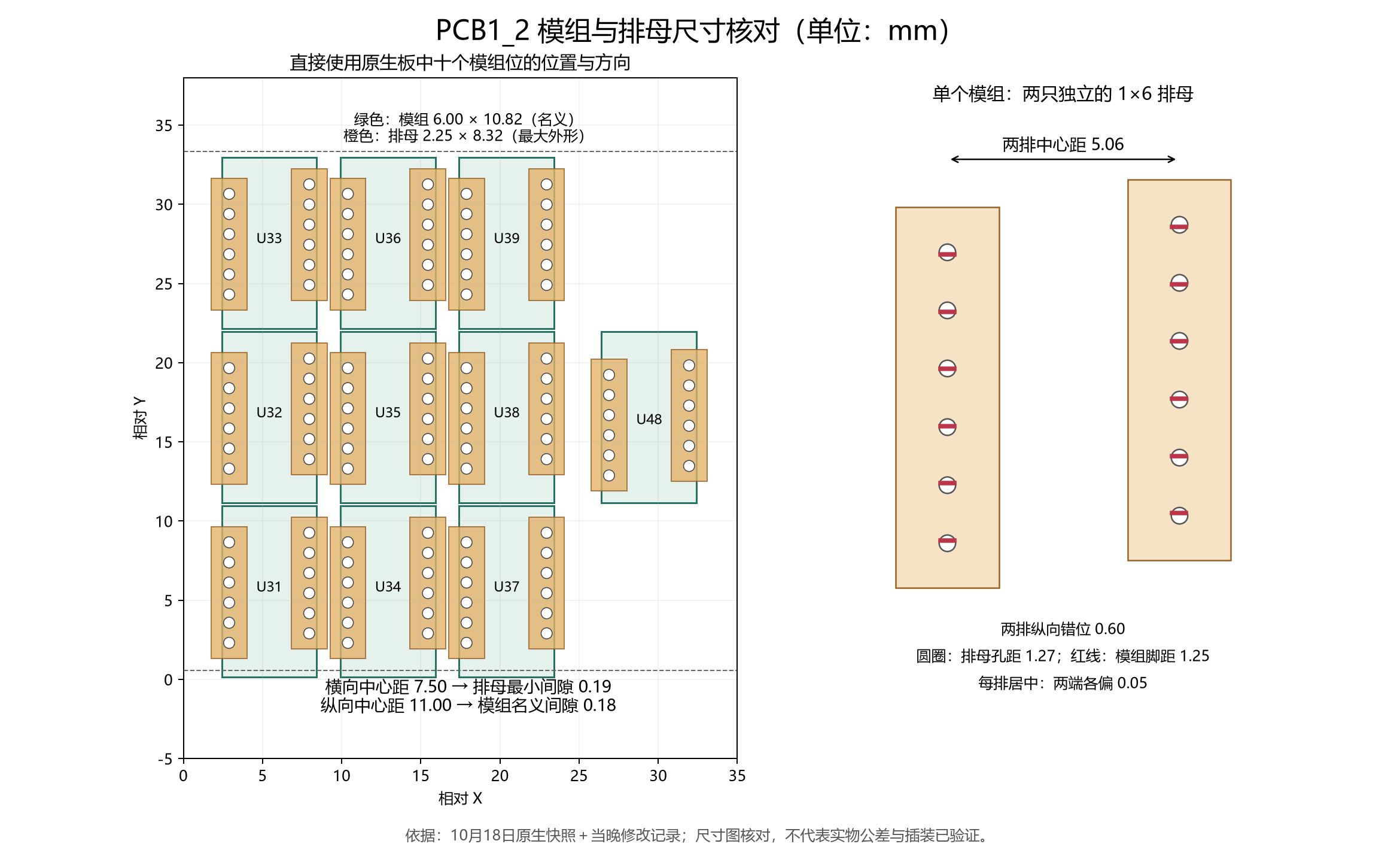
hardware/models/3mf/Handle_NewPCB_2026-10-20/references/PCB1_2_module_socket_fit.png
