Cheerssom/LingTouchCompanion/hardware/models/3mf/Handle_NewPCB_2026-10-20/renders/02_side.png

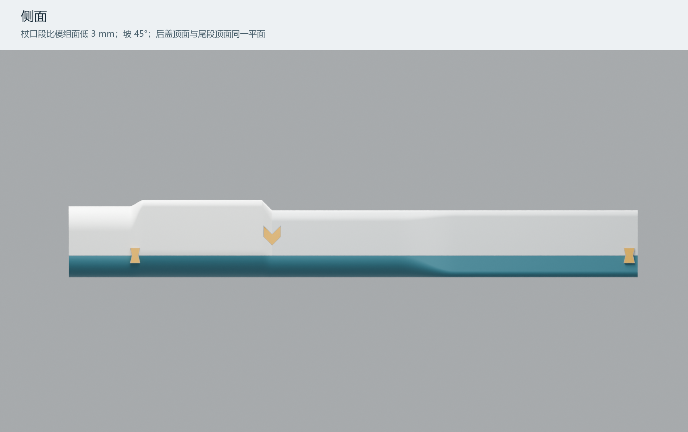
hardware/models/3mf/Handle_NewPCB_2026-10-20/renders/02_side.png
