Cheerssom/LingTouchCompanion/hardware/models/3mf/Handle_NewPCB_2026-10-20/renders/03_top.png

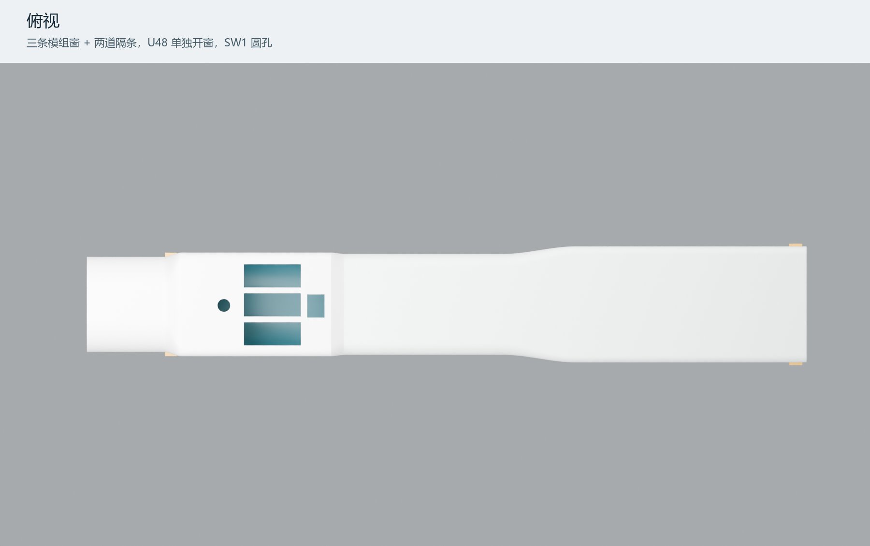
hardware/models/3mf/Handle_NewPCB_2026-10-20/renders/03_top.png
