Cheerssom/LingTouchCompanion/hardware/models/3mf/Handle_NewPCB_2026-10-20/renders/03_top_windows.png

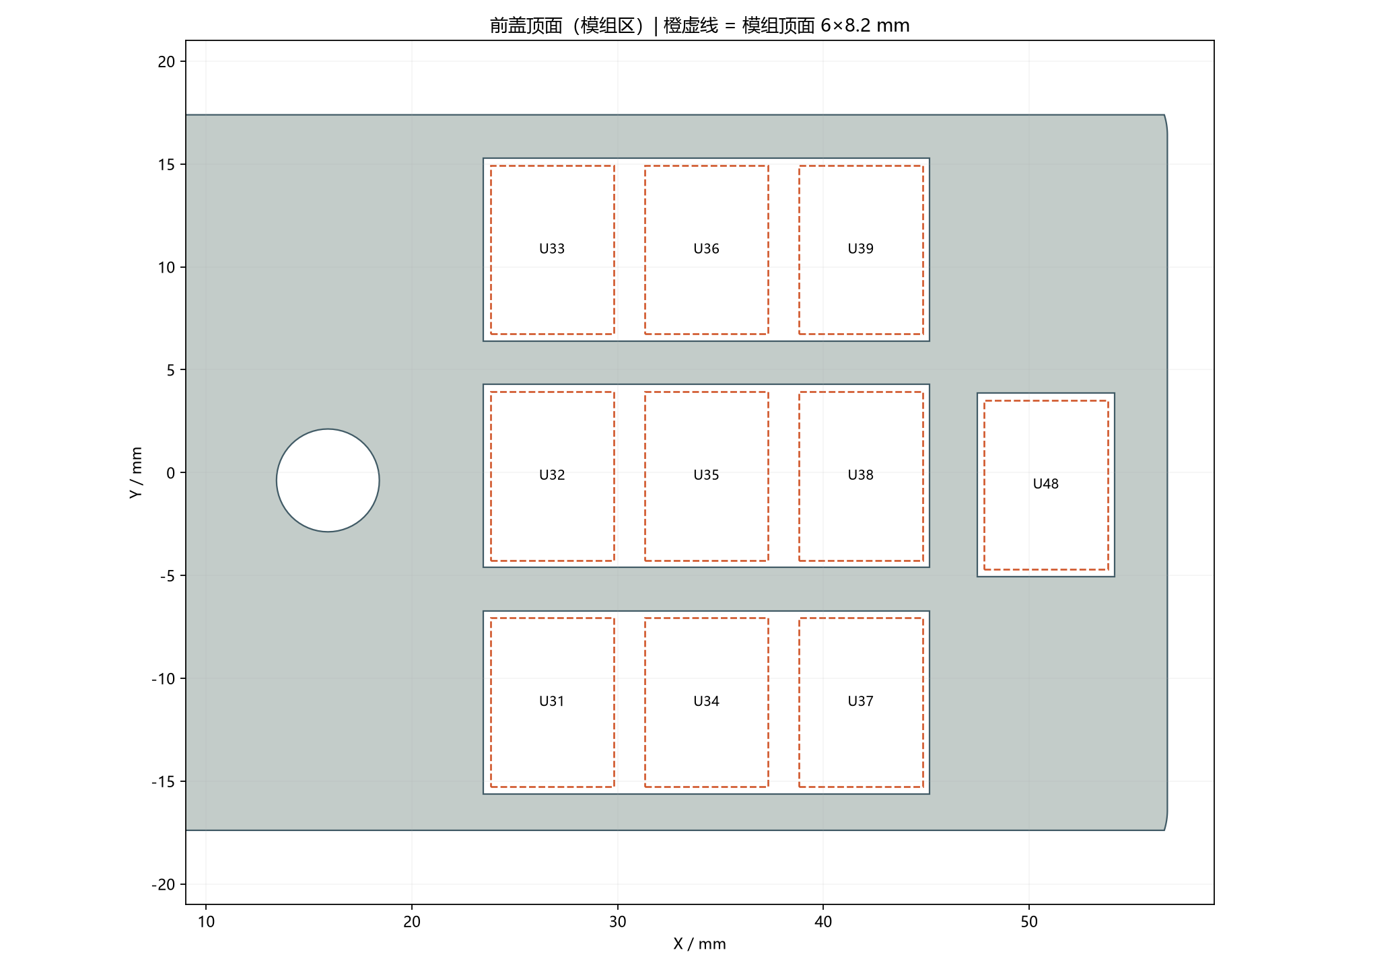
hardware/models/3mf/Handle_NewPCB_2026-10-20/renders/03_top_windows.png
