Cheerssom/LingTouchCompanion/hardware/models/3mf/Handle_NewPCB_2026-10-20/renders/05_cane_mouth.png

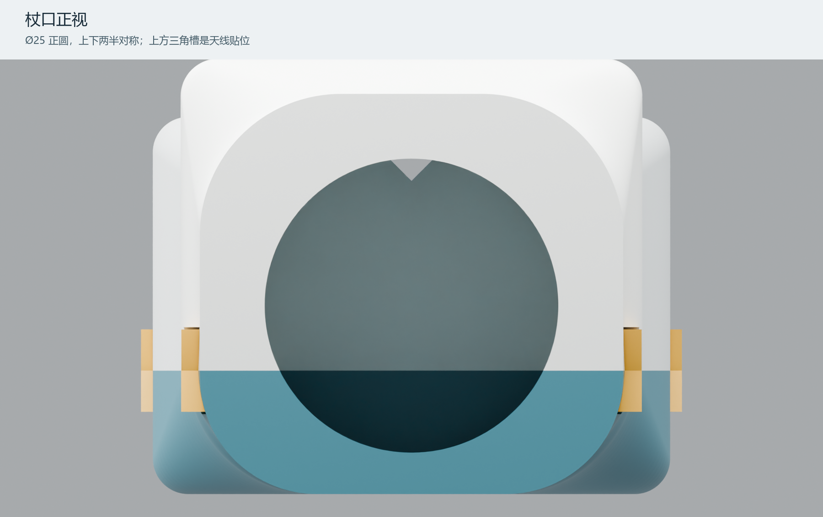
hardware/models/3mf/Handle_NewPCB_2026-10-20/renders/05_cane_mouth.png
