Cheerssom/LingTouchCompanion/hardware/models/3mf/Handle_NewPCB_2026-10-20/renders/13_bambu_support.png

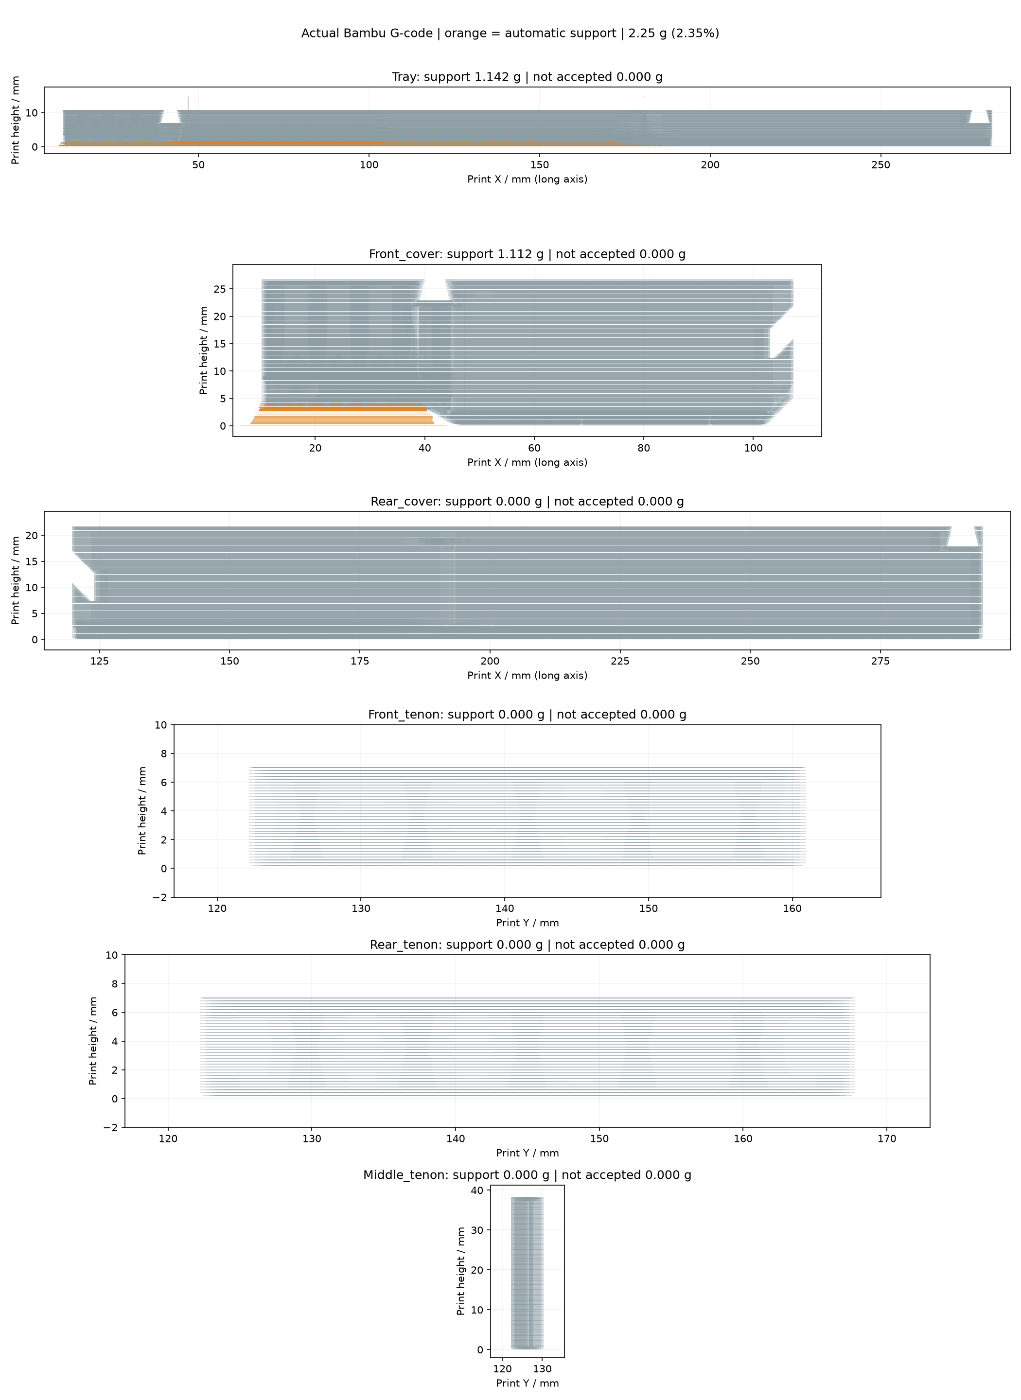
hardware/models/3mf/Handle_NewPCB_2026-10-20/renders/13_bambu_support.png
