Cheerssom/LingTouchCompanion/hardware/models/3mf/Handle_NewPCB_2026-10-20/renders/14_cover_interior.png

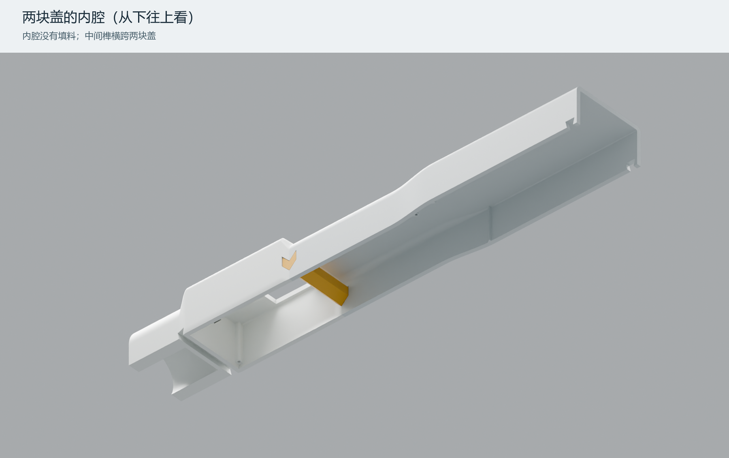
hardware/models/3mf/Handle_NewPCB_2026-10-20/renders/14_cover_interior.png
