Cheerssom/LingTouchCompanion/hardware/models/3mf/Handle_NewPCB_2026-10-20/renders/15_tail_open.png

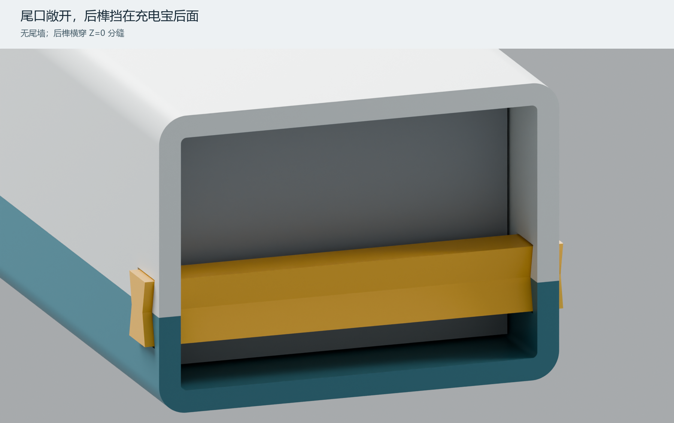
hardware/models/3mf/Handle_NewPCB_2026-10-20/renders/15_tail_open.png
