Cheerssom/LingTouchCompanion/hardware/models/3mf/Handle_NewPCB_2026-10-20/renders/section_pcb_holes.png

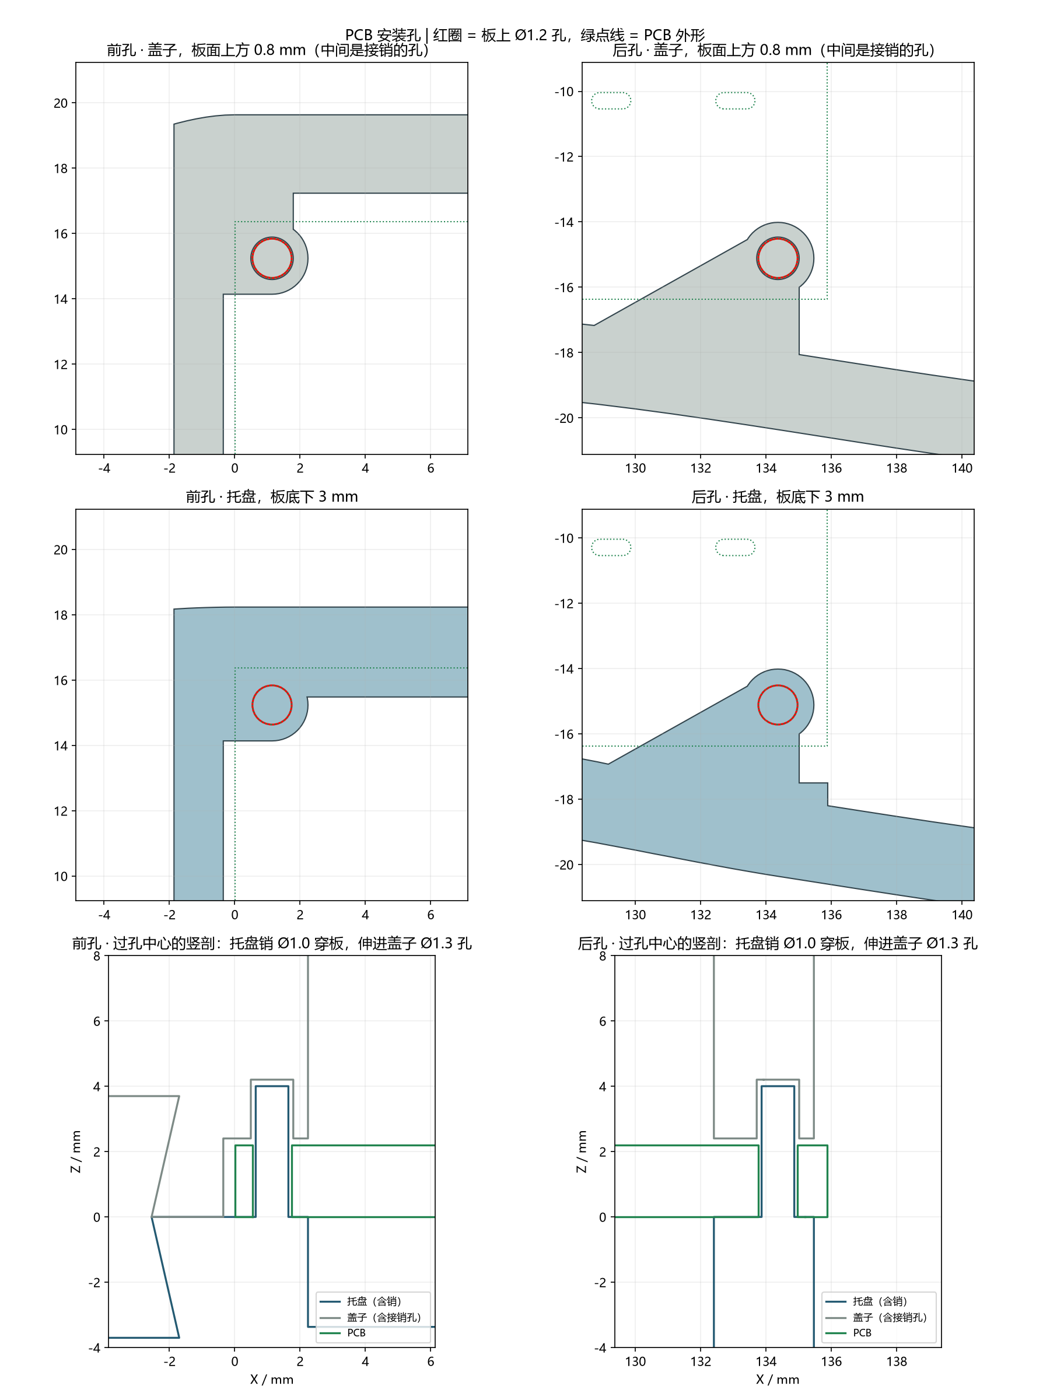
hardware/models/3mf/Handle_NewPCB_2026-10-20/renders/section_pcb_holes.png
