Cheerssom/LingTouchCompanion/hardware/models/3mf/Handle_NewPCB_2026-10-20/renders/section_tenons.png

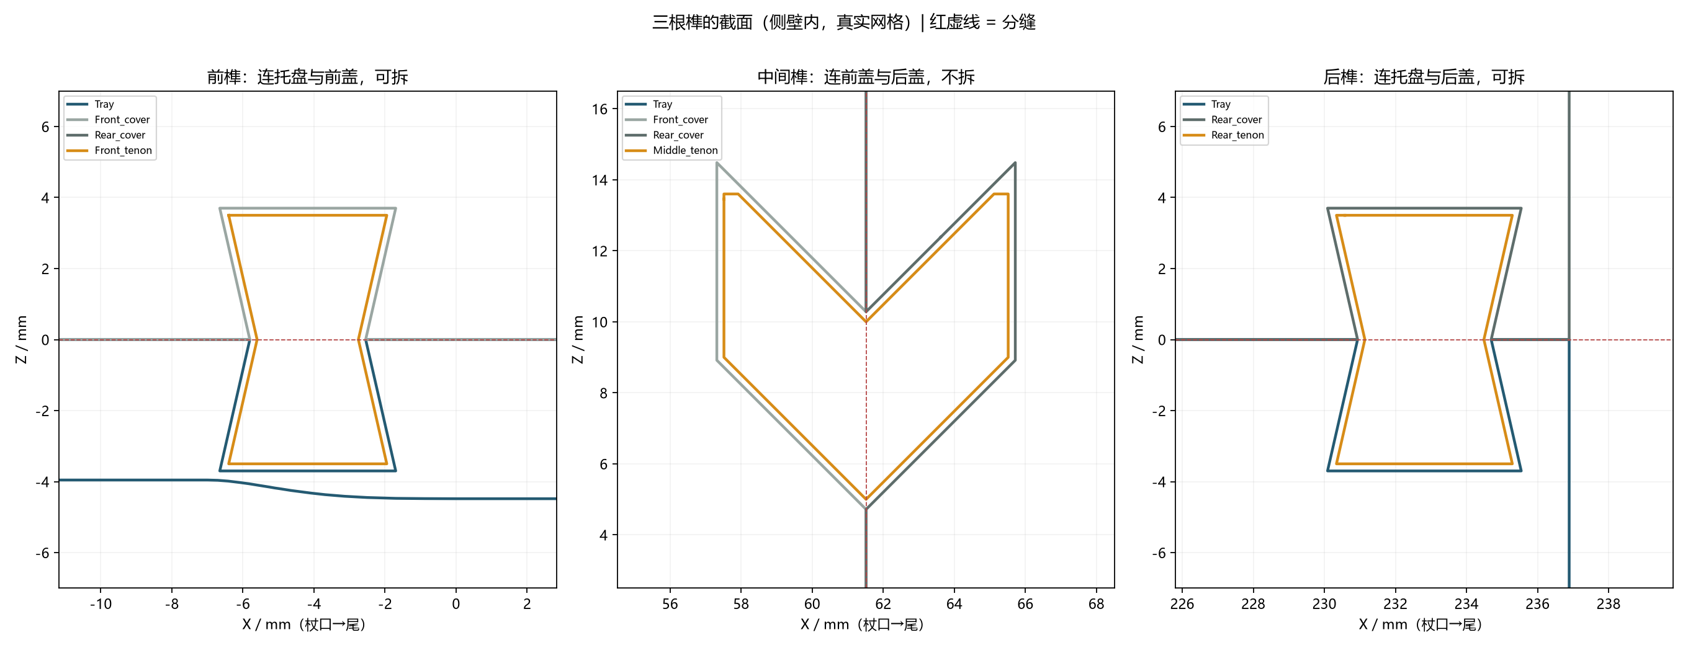
hardware/models/3mf/Handle_NewPCB_2026-10-20/renders/section_tenons.png
