Cheerssom/LingTouchCompanion/hardware/models/3mf/Handle_TwistKey_2026-10-27/key_detent_preview.png

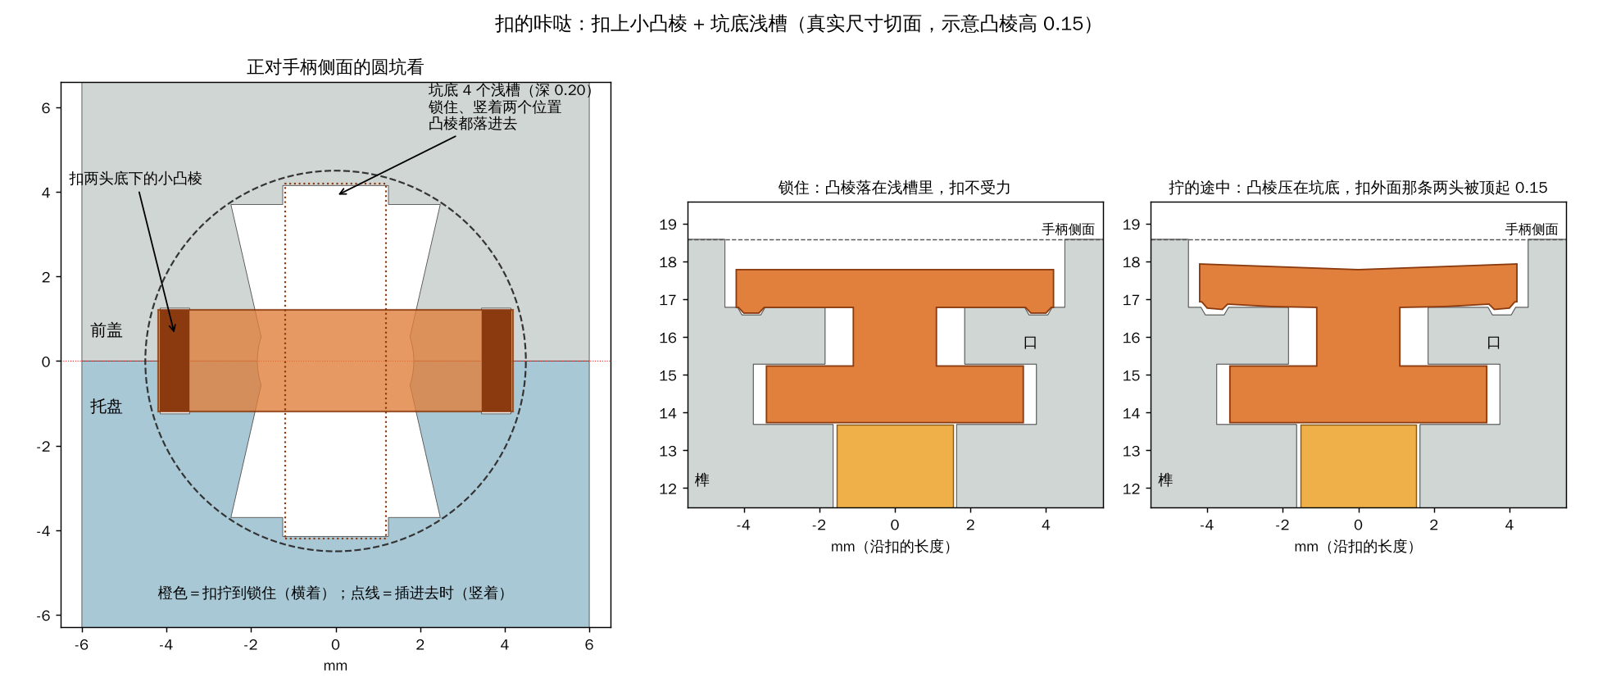
hardware/models/3mf/Handle_TwistKey_2026-10-27/key_detent_preview.png
