Cheerssom/LingTouchCompanion/hardware/models/BrailleModule_Video/inputs/PrototypeSurface_A.jpeg

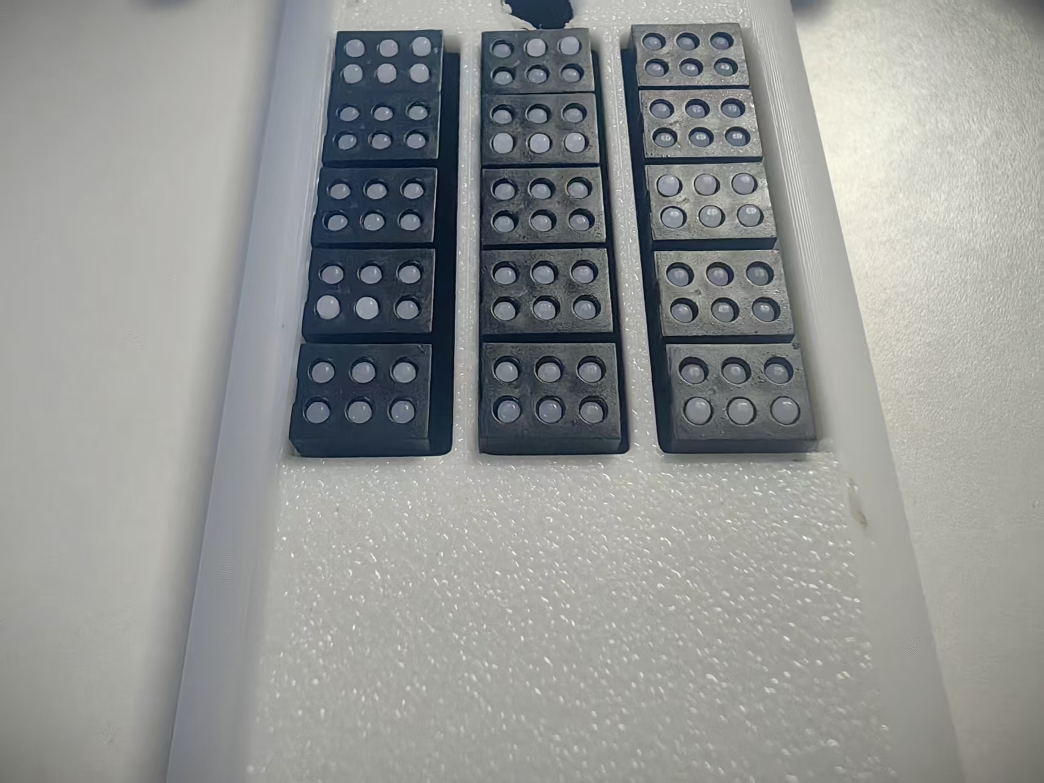
hardware/models/BrailleModule_Video/inputs/PrototypeSurface_A.jpeg
