Cheerssom/LingTouchCompanion/hardware/models/BrailleModule_Video/inputs/PrototypeSurface_B.jpeg

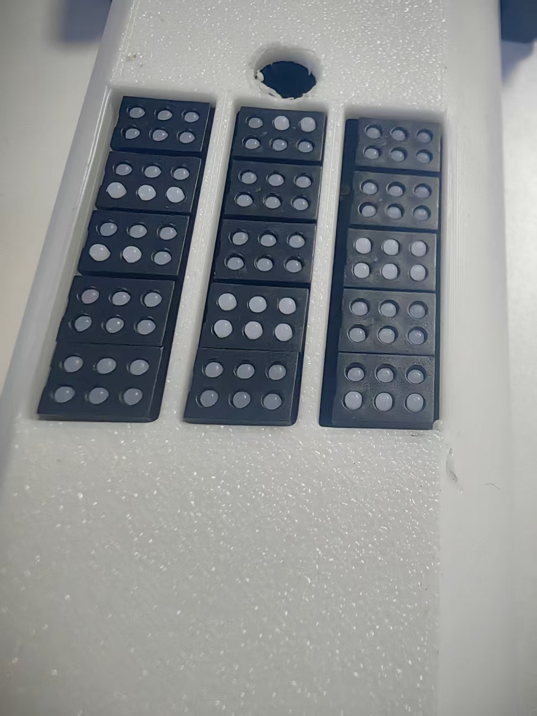
hardware/models/BrailleModule_Video/inputs/PrototypeSurface_B.jpeg
