Cheerssom/LingTouchCompanion/hardware/models/BrailleModule_Video/inputs/TI_DotPad_085s.png

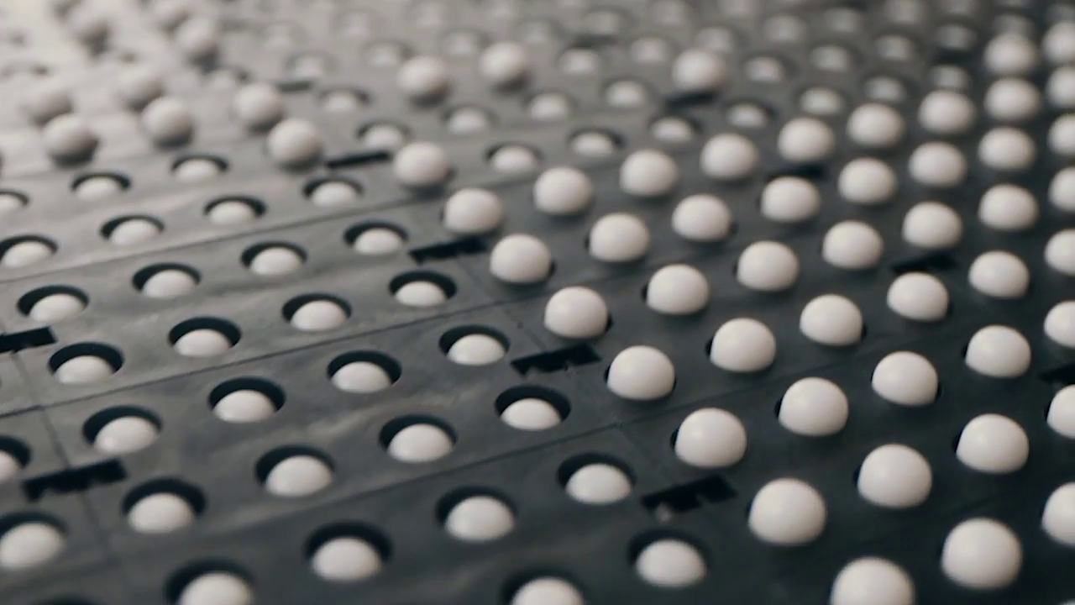
hardware/models/BrailleModule_Video/inputs/TI_DotPad_085s.png
