Cheerssom/LingTouchCompanion/hardware/models/BrailleModule_Video/pin_lift_handoff/inputs/10_reference.png

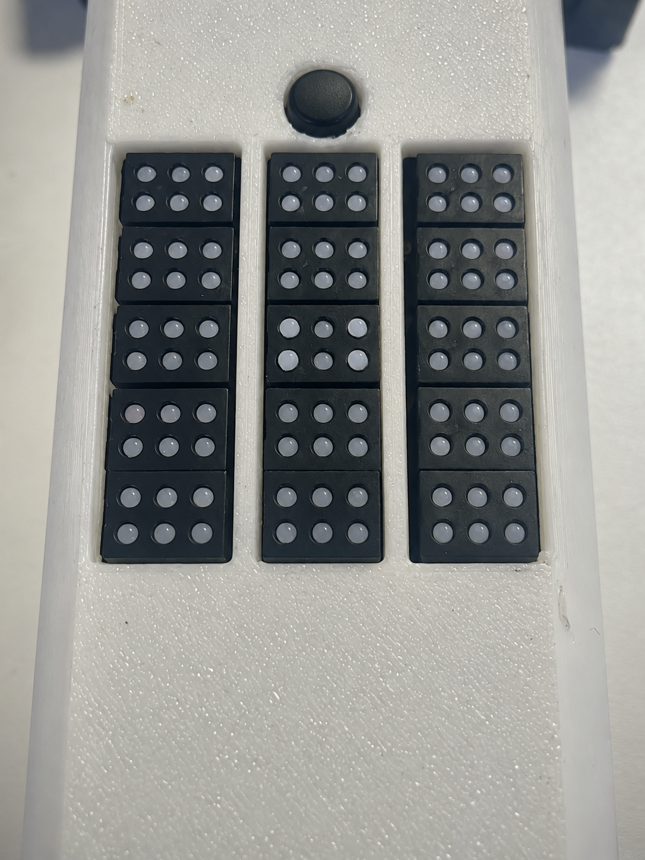
hardware/models/BrailleModule_Video/pin_lift_handoff/inputs/10_reference.png
