Cheerssom/LingTouchCompanion/hardware/models/BrailleModule_Video/pin_lift_handoff/out/lingchu_json_review.png

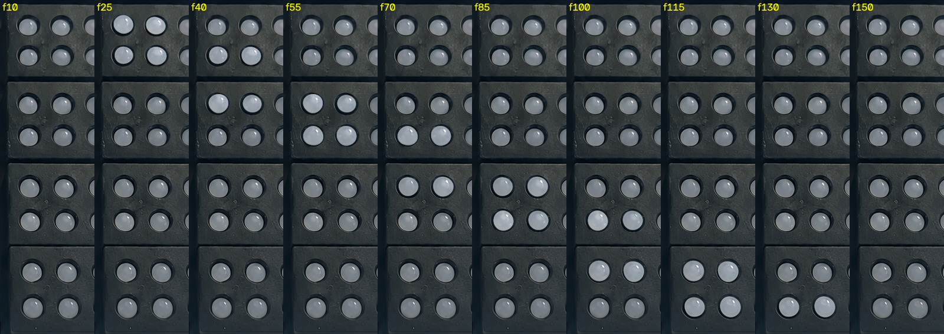
hardware/models/BrailleModule_Video/pin_lift_handoff/out/lingchu_json_review.png
