Cheerssom/LingTouchCompanion/image_prompt_comparison_2026-10-10/09_real_pin_source.png

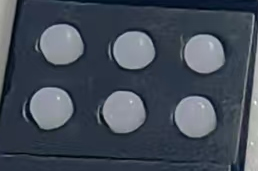
image_prompt_comparison_2026-10-10/09_real_pin_source.png
