Cheerssom/LingTouchCompanion/hardware/models/3mf/Handle_NewPCB_2026-10-20/Handle_Assembly.3mf

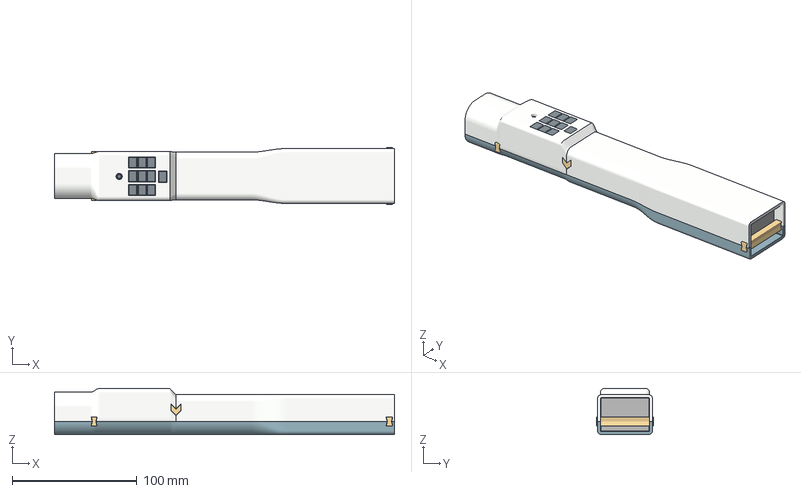
[picture p45: CAD file, 2026-10-27]
hardware/models/3mf/Handle_NewPCB_2026-10-20/Handle_Assembly.3mf
272.9 x 46.0 x 37.0 mm
Tray
Front_cover
Rear_cover
Front_tenon
Rear_tenon
Middle_tenon
Board
L1
C75
C80
C74
C76
R7
R8
R9
R10
R12
R32
R38
R46
R14
R5
R13
R1
R3
R6
R11
R25
R43
R44
R45
R48
R49
R50
R51
L2
L3
D3
U58
J_test
C1
C5
C6
C7
C33
C35
C36
C62
C72
C82
C91
C94
C95
C97
C9
C31
C100
C8
C4
C2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
