Cheerssom/LingTouchCompanion/hardware/models/3mf/Handle/Handle_Print.3mf

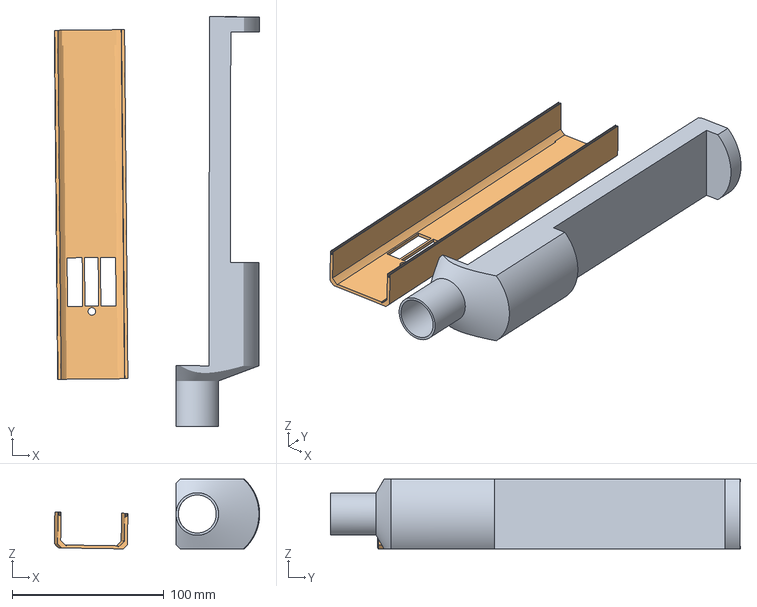
[picture p46: CAD file, 2026-10-28]
hardware/models/3mf/Handle/Handle_Print.3mf
135.3 x 270.2 x 46.0 mm
零件2.STEP
零件1.STEP
