Cheerssom/LingTouchCompanion/hardware/models/3mf/Handle_TwistKey_2026-10-27/Key_Detent_Test.3mf

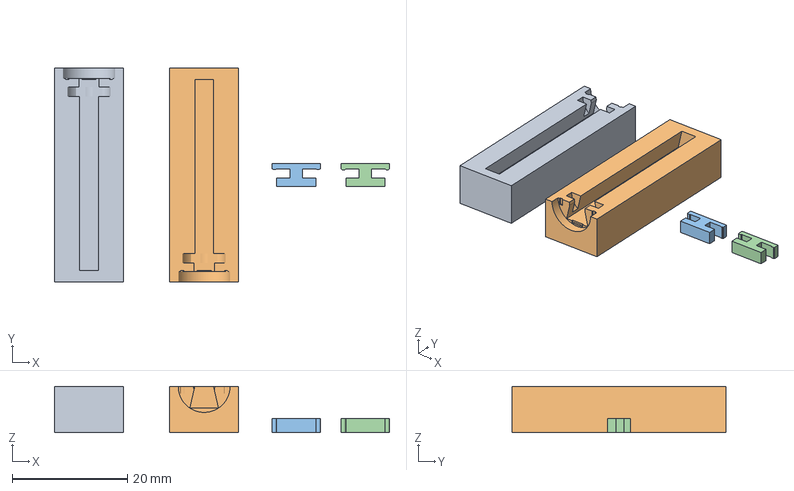
[picture p47: CAD file, 2026-10-28]
hardware/models/3mf/Handle_TwistKey_2026-10-27/Key_Detent_Test.3mf
58.2 x 37.2 x 8.00 mm
Detent_Test_Tray
Detent_Test_Cover
Detent_Test_Key_ridge0.10
Detent_Test_Key_ridge0.15
