Cheerssom/LingTouchCompanion/hardware/models/3mf/Headset_Rear/revised/Rear_Revised_Print_Ready.3mf

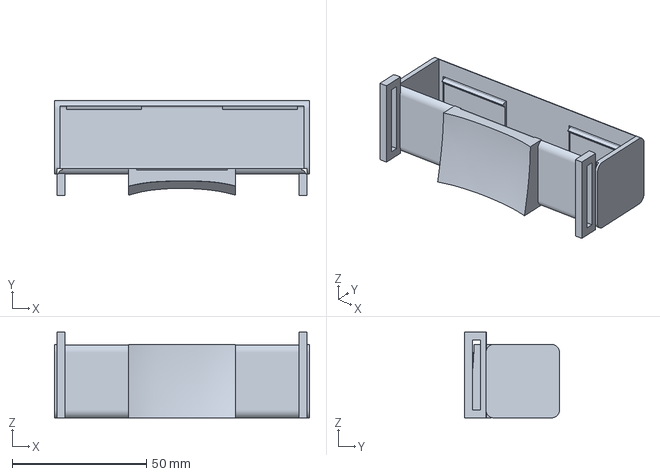
[picture p48: CAD file, 2026-10-28]
hardware/models/3mf/Headset_Rear/revised/Rear_Revised_Print_Ready.3mf
95.0 x 35.4 x 32.0 mm
