Cheerssom/LingTouchCompanion/hardware/models/3mf/Headset_WOAD_Front_2026-10-03/camera_mount/Front_CS30_Mount_Print.3mf

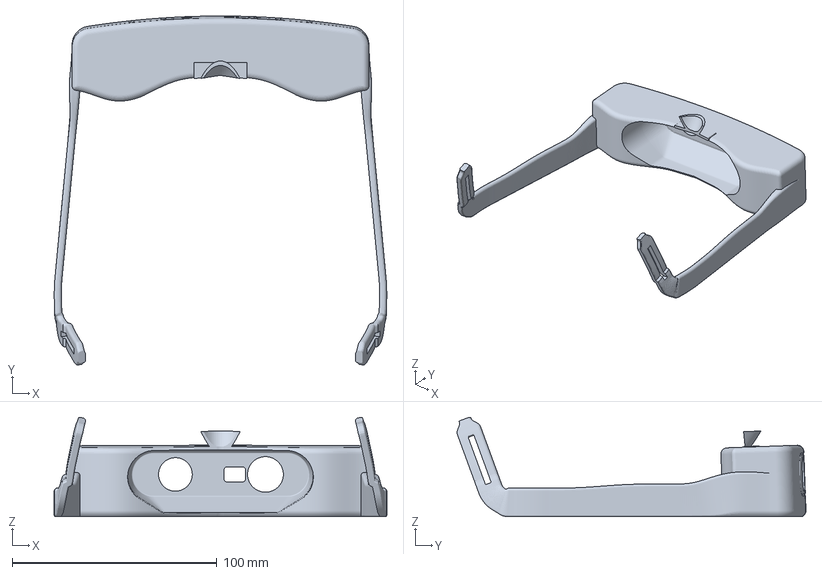
[picture p49: CAD file, 2026-10-28]
hardware/models/3mf/Headset_WOAD_Front_2026-10-03/camera_mount/Front_CS30_Mount_Print.3mf
162.5 x 170.5 x 48.6 mm
