Cheerssom/LingTouchCompanion/hardware/models/3mf/PCB/3D_PCB1_5_2026-09-15_no_U31-U45_U48_headers.step

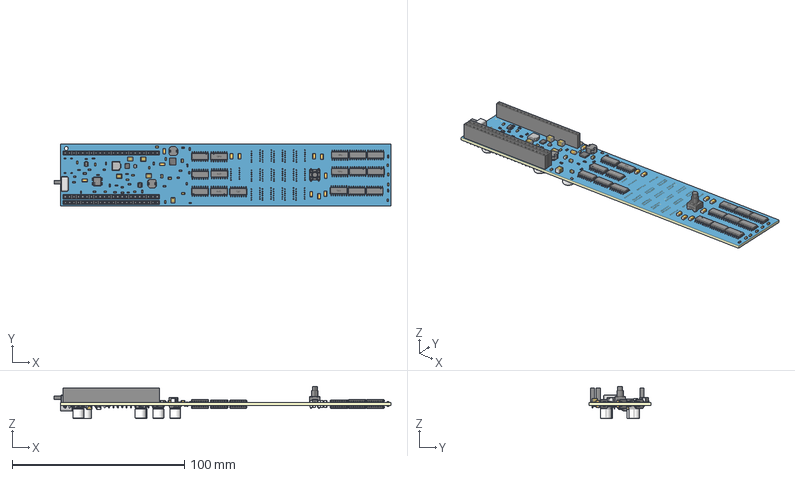
[picture p50: CAD file, 2026-10-28]
hardware/models/3mf/PCB/3D_PCB1_5_2026-09-15_no_U31-U45_U48_headers.step
195.4 x 35.7 x 18.8 mm
Board~qOkW
TopCopper~qOkW
BottomCopper~qOkW
TopSilkscreen~qOkW
BottomSilkscreen~qOkW
TopFpcStiffener~qOkW
BottomFpcStiffener~qOkW
SC-70-6_L2.0-W1.3-P0.65-LS2.1-BL~SC-70-6_L2.0-W1.3-P0.65-LS2.1-BL~uosG
TSOT-23-6_L2.9-W1.6-P0.95-LS2.8-BR~TSOT-23-6_L2.9-W1.6-H1.1-LS2.8-P0.95~Opjs
CAP-SMD_BD6.3-L6.6-W6.6-FD~CAP-SMD_BD6.3-L6.6-W6.6-FD~HCT5 x 6
R0805~R0805_L2.0-W1.3-H0.6~y6TF
SOT-23-6_L2.9-W1.6-P0.95-LS2.8-BL~SOT-23-6_L2.9-W1.6-H1.5-LS2.8-P0.95~l1t3
HDR-TH_22P-P2.54-V-F~HDR-TH_22P-P2.54-V-F~lpO1 x 3
POWERVDFN-8_L6.0-W5.0-P1.27-BL~POWERVDFN-8_L6.0-W5.0-H1.0-P1.27~o22u
VQFN-HR-15_L3.0-W2.5-P0.50-BL_TPS63070RNMR~VQFN-HR-15_L3.0-W2.5-H0.9-P0.50-BL_TPS63070RNMR~hWiu
CAP-SMD_BD6.3-L6.6-W6.6-LS7.2-FD~CAP-SMD_BD6.3-L6.6-W6.6-LS7.2-FD~ZWFw
R0603~R0603~DT92 x 35
IND-SMD_L5.3-W5.1~IND-SMD_L5.3-W5.1~OYvT x 2
SW-TH_4P-L6.1-W6.1-P4.50-LS6.5~SW-TH_4P-L6.1-W6.1-P4.50-LS6.5~2TRX
C0603~C0603_L1.6-W0.8-H0.8~JeRV x 31
C1206~C1206_L3.2-W1.6-H1.3~mKgy x 19
SOIC-16_L9.9-W3.9-P1.27-LS6.0-BL~SOIC-16_L9.9-W3.9-H1.8-LS6.0-P1.27~37DY x 16
C1210~C1210_L3.2-W2.5-H2.5~RXVH x 7
SW-TH_SK-12D07-VG4-NS-PA~SW-TH_SK-12D07-VG4-NS-PA~O8lM
IND-SMD_L5.4-W5.1_SPM5020T-100M-LR~IND-SMD_L5.4-W5.1_SPM5020T-100M-LR~QVpA
TYPE-C-SMD_TYPE-C-6P_1~TYPE-C-SMD_6P-L8.9-W6.8-H3.2-P1.00~io5I
LED0603-RD~LED0603-RD~LF2A x 2
VQFN-24_L4.0-W4.0-P0.50-BL-EP2.5~VQFN-24_L4.0-W4.0-H1.0-P0.50-BL-EP2.5~OIXM
C0805~C0805_L2.0-W1.3-H1.3~CLmc x 5
TSSOP-14_L5.0-W4.4-P0.65-LS6.4-BL~TSSOP-14_L5.0-W4.4-H1.0-LS6.4-P0.65~ouAr
TQFN-21_L4.0-W3.0-P0.40-TL_MPQ8633BGLE-Z~TQFN-21_L4.0-W3.0-P0.40-TL_MPQ8633BGLE-Z~MLlr
SOP-16_L10.0-W3.9-P1.27-LS6.0-BL~SOP-16_L9.9-W3.9-H1.5-LS6.0-P1.27~rBug x 16
