Cheerssom/LingTouchCompanion/hardware/models/BrailleModule/BrailleModule.step

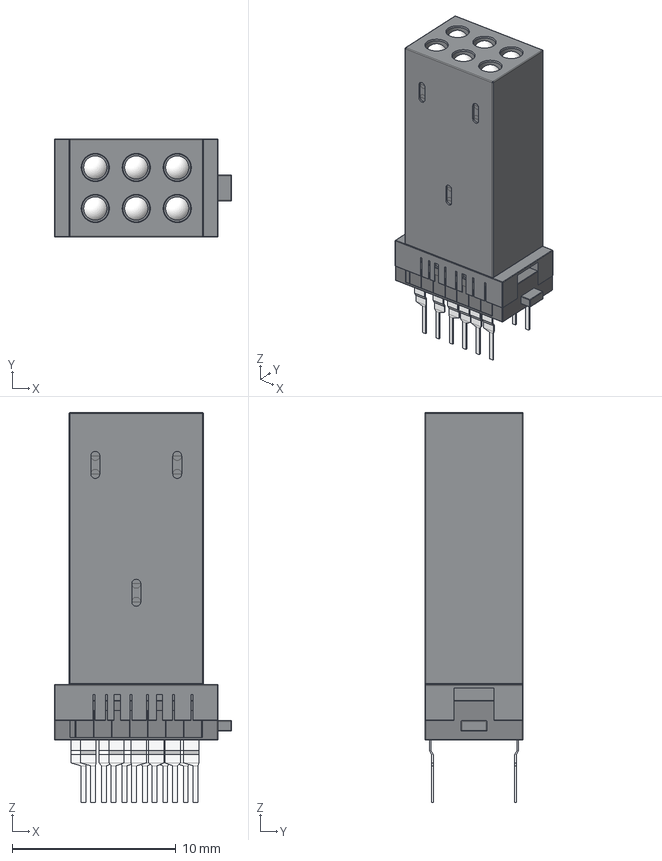
[picture p51: CAD file, 2026-10-28]
hardware/models/BrailleModule/BrailleModule.step
10.8 x 6.00 x 23.8 mm
Housing
Base_Collar
Base_Insert
Orientation_Tab
Pin_01
Pin_02
Pin_03
Pin_04
Pin_05
Pin_06
Pin_07
Pin_08
Pin_09
Pin_10
Pin_11
Pin_12
Dot_1
Dot_2
Dot_3
Dot_4
Dot_5
Dot_6
