Cheerssom/LingTouchCompanion/hardware/models/3mf/Handle_NewPCB_2026-10-20/Handle_Print_H2C.3mf

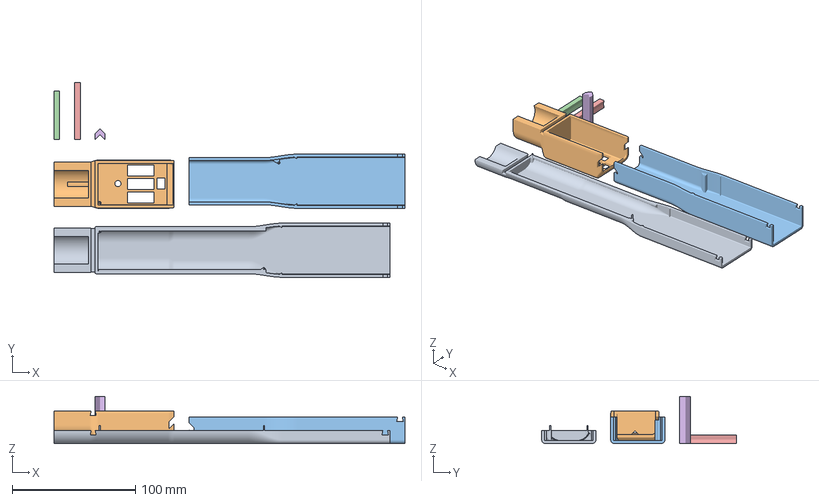
[picture p52: CAD file, 2026-10-27]
hardware/models/3mf/Handle_NewPCB_2026-10-20/Handle_Print_H2C.3mf
284.9 x 158.0 x 38.3 mm
Tray
Front_cover
Rear_cover
Front_tenon
Rear_tenon
Middle_tenon
