Cheerssom/LingTouchCompanion/hardware/models/3mf/Handle_TwistKey_2026-10-27/Tenon_Test.3mf

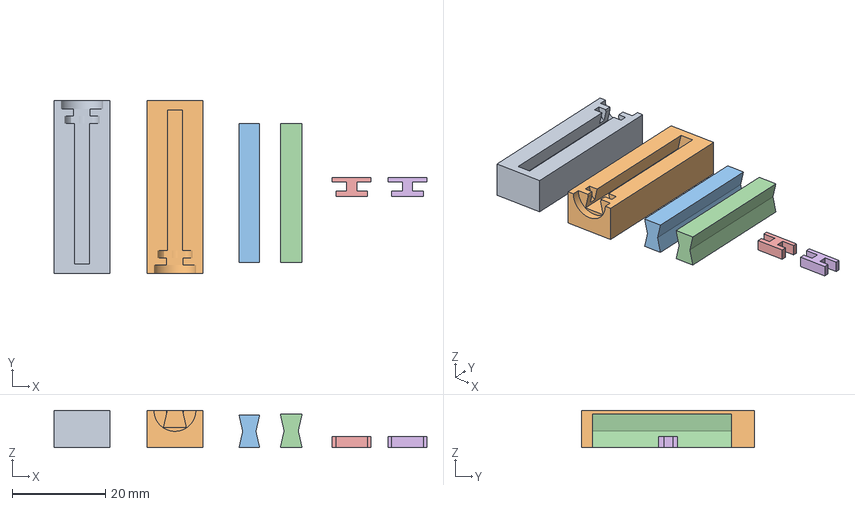
[picture p53: CAD file, 2026-10-27]
hardware/models/3mf/Handle_TwistKey_2026-10-27/Tenon_Test.3mf
80.2 x 37.2 x 8.00 mm
Tenon_Test_Tray
Tenon_Test_Cover
Tenon_Test_Tenon_gap0.2
Tenon_Test_Tenon_gap0.1
Tenon_Test_Key
Tenon_Test_Key_spare
