Cheerssom/LingTouchCompanion/(list of files, cad)

Other CAD files:
hardware/models/3mf/Headset_Inputs/Medium_Symmetry.stl
hardware/models/3mf/PCB/inputs/3D_PCB1_5_2026-09-15.step
hardware/models/3mf/Headset_Rear/revised/Rear_Revised_Wearing.3mf
hardware/models/3mf/Handle/GripStudy/AdultRightHand.blend
hardware/models/3mf/Handle/GripStudy/inputs/EmmaLieker_Hand.blend
hardware/models/BrailleModule/BrailleModule.blend
hardware/models/BrailleModule_Video/ArrayPreview/EnclosedArray.blend
hardware/models/BrailleModule_Video/ArrayPreview/ModuleArray.blend
hardware/models/BrailleModule_Video/BrailleModule.blend
hardware/models/BrailleModule_Video/MotionPreview/AppearanceStudy.blend
hardware/models/BrailleModule_Video/MotionPreview/ModuleMotion.blend
hardware/models/BrailleModule_Video/PhotoStudy/ReferenceStudy.blend
