Cheerssom/LingTouchCompanion/hardware/models/3mf/Handle_NewPCB_2026-10-20/renders/11_print_poses.png

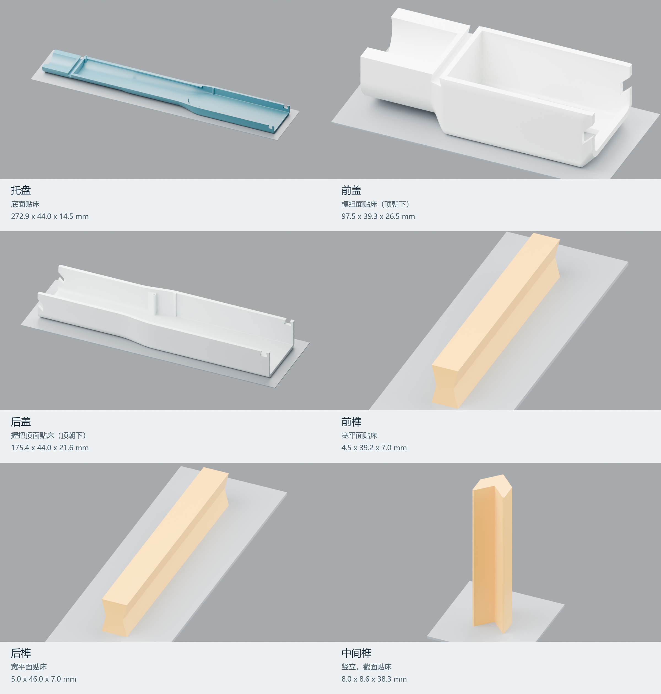
hardware/models/3mf/Handle_NewPCB_2026-10-20/renders/11_print_poses.png
