Cheerssom/LingTouchCompanion/hardware/models/3mf/Handle_NewPCB_2026-10-20/renders/16_assembly_hardware.png

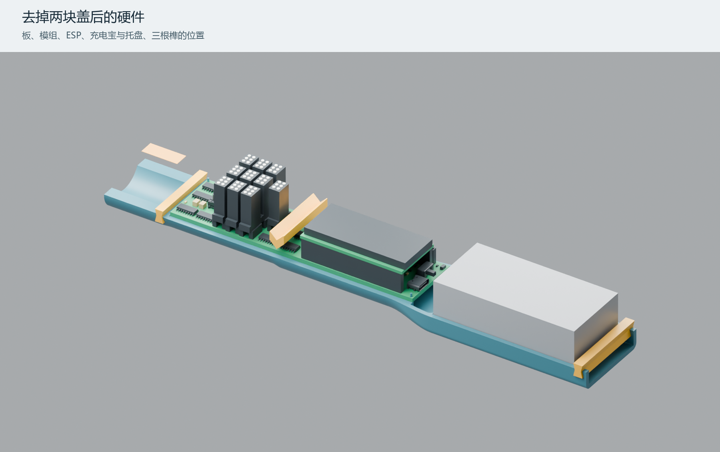
hardware/models/3mf/Handle_NewPCB_2026-10-20/renders/16_assembly_hardware.png
