Cheerssom/LingTouchCompanion/hardware/models/3mf/Handle/VERIFIED_FACTS.md

# 手柄：已核实事实清单（2026-10-11）

这份清单让后续工作不必再从原件重新推导。

使用方法：先在仓库根目录运行

```powershell
3mf/.runtime/structural-runtime/Scripts/python.exe -B 3mf/Handle/check_facts.py
```

- 约 5 秒跑完。
- 全部 `OK`：下表 A 节可直接引用，不必重读原件。
- 出现 `MISMATCH`：说明对应原件变了，相关条目必须重新推导。

## A. 已核实（附依据）

| 事实 | 依据与方法 | 脚本复核 |
|---|---|---|
| 原手柄是两件式：外壳 + 上盖，零间隙榫槽，槽两侧各只剩 0.5 mm 壁 | `inputs/Handle_Original.3mf` 网格切片 | 原件 hash |
| 原上盖窗口 32.0 mm 长，宽 10 / 9 / 10 mm；开关孔 Ø5，位于 X 44.5 | 上盖 Y 22.5 截面 | ✓ |
| 原手柄尾端在止挡以上敞开（约 42 × 33 mm）；杖口内孔直通腔体，没有限位 | 截面与渲染 | ✓（尾端） |
| PCB1_5 在手柄坐标中应居中；Codex 所有手柄模型都向 −Z 偏了 2.75 mm | 板上焊孔：15 个模组焊盘、SW1、ESP 两排插座、板外形全部对称于同一条中线 | ✓ |
| 偏差来源：Codex 用借来的 12P 排母占位模型中心（正好在 −11 / 0 / 11）对齐窗口 | 原始 STEP 中占位模型的位置 | — |
| 模组本体中心 X = 52.79 + 6.5k（取 SW1 = X 44.5 时）；针脚在 6 mm 本体正中 | 焊孔；供应商图纸第 3 页像素测量（针脚对中误差约 0.03 mm） | ✓（焊孔） |
| 原上盖“开关孔→窗口”间距比板子短 1.79 mm：开关与模组只能对准其中一个 | 焊孔 vs 上盖截面 | ✓ |
| ESP 是 YD‑ESP32‑S3 V1.4：板子 27.94 × 57.15 mm，天线伸到 63.39 mm，两排针距 25.40 mm；USB 端朝 SW2，天线端朝模组 | 厂商公制尺寸图（`Coaxial_v1/inputs`）；`../PCB/PCB_PREPOWER_REVIEW` | hash |
| J1（USB‑C）口在板尾 X 192.0，位于板下侧；SW2 拨杆 2 × 2 mm，伸到 X 195.8，中心高出板面 2.75 mm | STEP 逐件网格 | — |
| 板下最深的是电解电容，比板底低 7.75 mm，集中在 X 121–150 和 173–186 | STEP 逐件网格 | — |
| 打印机为 Bambu Lab H2C（330 × 320 × 325 mm），原工程用 PLA，层高 0.2 mm | 原 3MF 工程设置 | 原件 hash |
| 原工程里上盖在打印盘上斜放了 0.9°，顶面没贴平 | 原 3MF 构建变换 | — |
| 白杖用途：阵列放在握持区附近，出发前读取 | 论文中文合并稿第 3 节 | — |

## B. Codex 文档中已确认不对、不应再引用的内容

- `Redesign/`、`Concepts/`、`GripStudy/` 里的 PCB 摆位（`T_PCB` 的 Z = −4.146），以及由它推出的结论：
  - “PCB 偏向 −Z”；
  - 32 mm 版为 C78/C79 加的让位鼓包；
  - 前端定位榫放在 +Z 的理由；
  - 各概念中元件与外壳的间隙数值。
- 按修正后的位置，34/32 mm 版前端定位榫的根部会压到 PCB 边缘。
- `Redesign/*/Handle_Print.3mf` 中外壳是开口朝上立放的，约 11,700 mm² 需要支撑，不宜直接打印。

## C. 仍是假设 / 未核实

- 保护板的实际尺寸（v1 只预留了 24 × 19.5 × 7.6 mm）。
- SW1 实际高度 20 mm 的具体含义（是否含针脚）。
- J_test 是否焊接（v1 按已焊计算）。
- 所有打印公差（需要打小样确认）。
- 握持舒适度：只有通用成人手模型的姿势示意，没有真人测试。
- 杖口（Ø25 孔、1.5 mm 壁）在白杖使用时的强度。
