Cheerssom/LingTouchCompanion/hardware/models/3mf/Handle_TwistKey_2026-10-27/tenon_test_preview.png

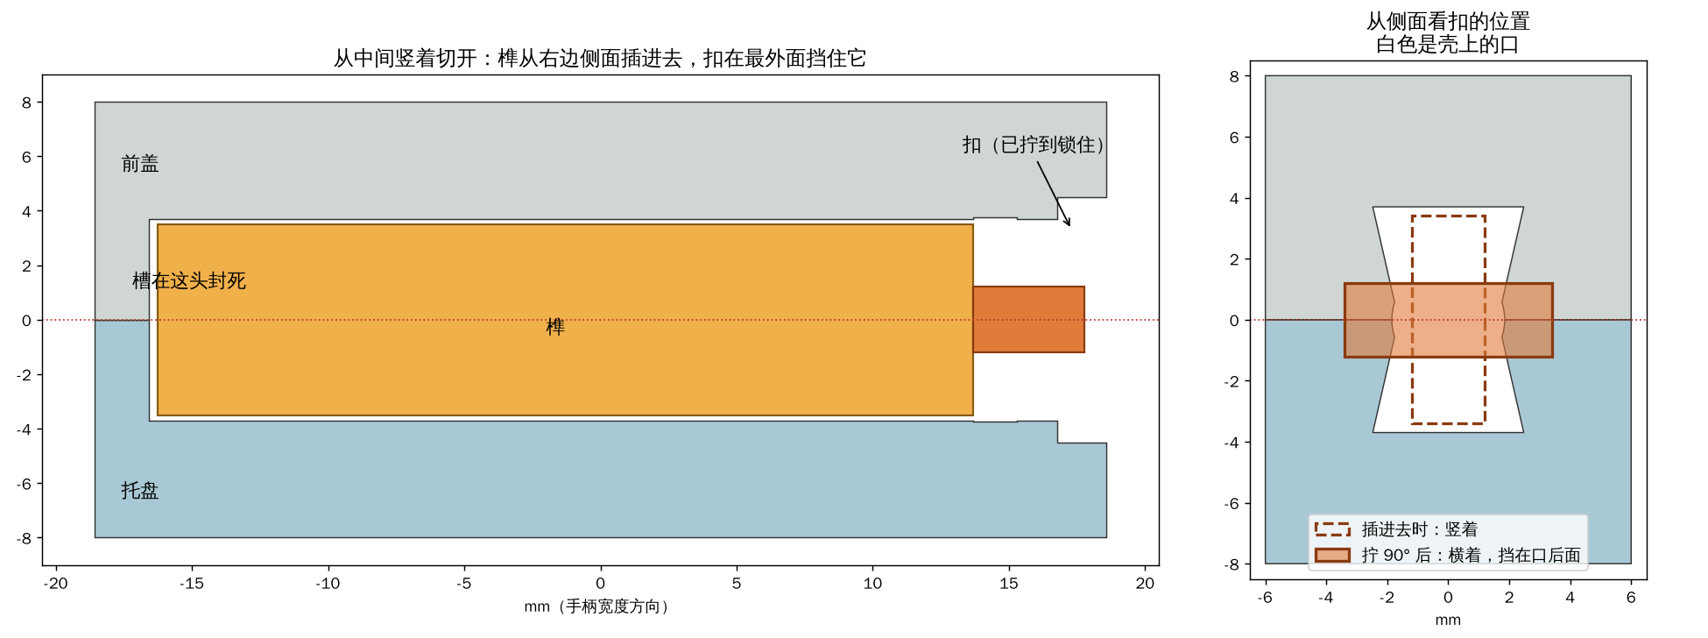
hardware/models/3mf/Handle_TwistKey_2026-10-27/tenon_test_preview.png
