Cheerssom/LingTouchCompanion/hardware/models/3mf/Shell_Lessons.md

# 灵触盲杖手柄外壳：下一版开工前先读

10/20 当前版违反两条需求：**没有把已有安装孔纳入固定设计；握持段沿用充电宝所需底面，多撑厚约 2.47 mm。**
**需要 Hsinlung 确认孔径：**按嘉立创专业版圆形字段推算约 Ø1.2 mm，README 写成了 0.6 mm；这又与早先接受的“两端各一个 M2 孔”不符，请在 EDA 中核对。
本文合并三份整理稿，独有内容已回查原材料；共 **26 条需求记录、30 条问题**。只更新本文，未改模型、脚本或另外两份稿件。

整理日期：2026-10-20。“当前版”指 [Handle_NewPCB_2026-10-20](Handle_NewPCB_2026-10-20/README.md) 当前保留文件；当天初稿的问题及修改另列。实物反馈、数字几何错误、尚未完成的设计和验证，按实际证据注明。

## 出处索引

会话日期按 UTC+8，行号为原始 JSONL 的物理行号。以下简称沿用原材料，派生会话中的重复记录只算一次。

| 简称 | 原始记录 |
|---|---|
| C06 | Codex，10/06：`C:/Users/Hsinlung/.codex/sessions/2026/10/06/rollout-2026-10-06T15-11-36-01a1100d-b3ce-7cb1-ba40-92719f7f7db2.jsonl`。 |
| C10 | Codex，10/10：`C:/Users/Hsinlung/.codex/sessions/2026/10/10/rollout-2026-10-10T15-34-50-01a124bc-6926-7e90-9692-aaf5f19914bd.jsonl`。 |
| C11 | Codex，10/11：`C:/Users/Hsinlung/.codex/sessions/2026/10/11/rollout-2026-10-11T08-58-02-01a12877-7e93-7700-871b-f17e72df417c.jsonl`。 |
| L11 | Claude Code，10/11：`C:/Users/Hsinlung/.claude/projects/c--Users-Hsinlung-Desktop-LingTouchCompanion/d46657c2-4c7f-457c-a345-b00e85217a57.jsonl`。543 行为审查，549 行为本人回答，621–627 行为方向讨论与授权，1186 行为 v1 交付。 |
| L16 | Claude Code，10/16：同一 Claude 项目目录下 `521818a4-b4c0-44ba-b4b5-c8942b7ddba5.jsonl`，475 行为本人回复，含“两端各一个 M2 孔”。 |
| C20a | Codex，10/20：`C:/Users/Hsinlung/.codex/sessions/2026/10/20/rollout-2026-10-20T16-55-02-01a15885-6dff-7d20-8401-d664a4c135da.jsonl`，12、53 行确认新手柄使用 PCB1_2。 |
| C20 | Codex，10/20：`C:/Users/Hsinlung/.codex/sessions/2026/10/20/rollout-2026-10-20T17-35-25-01a158aa-68ae-7cc2-8c3e-8cf0d84e78cf.jsonl`，10 行为制作任务，807 行为看过初稿后的四项纠正。 |
| U20 | Hsinlung 10/20 整理任务及本次合并要求，直接补充安装孔、握持段高度、供电位置和孔径确认事项。 |

主要文件：

- 原件：[README](Handle/README.md)、[原始 3MF](Handle/inputs/Handle_Original.3mf)、[初步方案／测量](Handle/ENCLOSURE_BRIEF.md)、[VERIFIED_FACTS](Handle/VERIFIED_FACTS.md)、[10/11 检查图](Handle/Claude_Review_2026-10-11/README.txt)。首轮整理已运行只读 `check_facts.py`，结果 `ALL OK`。
- 旧方案：[Redesign](Handle/Redesign/README.txt)、[GripStudy](Handle/GripStudy/README.txt)、[Concepts](Handle/Concepts/README.txt)、[Coaxial_v1](Handle/Coaxial_v1/README.md)及其 [shape.py](Handle/Coaxial_v1/shape.py)。
- 当前版：[README](Handle_NewPCB_2026-10-20/README.md)、[build.py](Handle_NewPCB_2026-10-20/build.py)、[verify.py](Handle_NewPCB_2026-10-20/verify.py)、[静态结果](Handle_NewPCB_2026-10-20/models/verification.json)、[运动结果](Handle_NewPCB_2026-10-20/models/motion_verification.json)、[器件缓存索引](Handle_NewPCB_2026-10-20/models/pcb_parts.json)。
- 新孔来源：[10/18 实时复查](../.pcba-workflow/pcb1_2-recheck-20261018/live-check.md)、[原始差异证据](../.pcba-workflow/pcb1_2-recheck-20261018/live-check-evidence.json)。

Git 的手柄路径日志主要找到 `6f46dfa`（10/08，整合模型来源），后续版本过程以文件和会话为据。原始 `Handle_Print.3mf` 是原件的保留副本，不另算修正版。项目约定提到的 `Desktop/news-game/docs/asset-production-mistakes.md` 在指定位置未找到，本文未借用头戴件或其他项目的未经核实经验。

## 一、需求

### Hsinlung 本人提出的现行要求

| 编号 | 要求 | 出处、原话及后续变化 |
|---|---|---|
| R01 | 右手握，右拇指读取触点。 | C10，308 行：“右手握住大拇指感知”。C11，1455–1620 行反复纠正手模左右，最后要求先镜像成右手。 |
| R02 | 真正手握的部分尽量窄，其他位置可以宽。 | C11，194 行：“盲人朋友体验的时候感觉手握的地方有点太宽了”；355 行：“只有握持的地方做窄点就行，别的地方就做宽点也可以啊”。L11，627 行：“握持端要更合理确实是关键”；C20 和 U20 重申。 |
| R03 | 先弄清手怎么放，再定握持外形。 | C11，355 行：“你先想下手到底应该咋放的”；406 行要求可活动手模，“先按比例做一个成人手即可”。应继承的是掌心、四指、虎口和拇指的关系；成人手模是当时采用的分析手段。 |
| R04 | 外形要对称。 | C06，1294 行：“你做的都不对称了……先把你做的内容都删了吧”；1297 行 AI 承认不对称。此条针对外形；J1 偏心、内部器件和局部接口的真实偏置不在此列。 |
| R05 | 外壳适配指定 PCB，保留板的形状与器件布局。 | C06，800 行：“pcb文件的模型肯定不能改了”；C11，2438 行：“先保留现有 PCB，重做外形与内部摆放”。旧任务用 PCB1_5；C20a，53 行指定改用 PCB1_2。 |
| R06 | 板和模组按真实焊盘、孔定位。 | C20，10 行：“板子和模组的位置必须按 PCB 自己的焊盘/孔定位，不能按占位模型”，明确要求避开旧 2.75 mm 偏移。 |
| R07 | 同轴直柄，杖口与手柄同轴。 | L11，549 行：“同轴的吧”；C20，10 行重申。C11，2429 行允许自由探索形态，是此前的概念阶段授权，后来已选回同轴。 |
| R08 | 杖口内孔沿用原手柄 Ø25 mm。 | C06，1117 行：“和手杖连接的半径是固定的”；C20，10 行明确为“杖口内孔沿用原手柄”；孔径见 VERIFIED_FACTS／原件测量。外壁可按承力需要调整。 |
| R09 | 去掉原来的长滑槽，插接留出余量、避免薄边。 | C10，308 行反映“对不上”“容易掰断”，允许用凸起凹陷；C11，194 行：“也不需要滑槽了……类似榫卯结构插进去就行”，并提醒“只要你别直接卡死就行”。 |
| R10 | 尾端封口，必要接口与开关保留操作位置。 | L11，549 行确认旧敞口“没有，是随便做的”；C20，10 行明确要求“尾端封口”。 |
| R11 | 尾端应帮助握住、起到防滑脱的作用。 | C10，308 行：“尾端是方便握持（类似卡住）”。Coaxial_v1 把止挡移到掌根附近是 AI 的实现；本人没指定止挡坐标。此功能与尾端封口同时保留。 |
| R12 | 模组固定顶面与盖面齐平。 | C20，10 行：“模组顶面和盖面齐平（原手柄的做法）”。升起的触点高于这个固定表面。 |
| R13 | 九个主模组共用一个窗，U48 单独开窗且要使用。 | C20，10 行第 2 点；取代旧十五模组、三条窗及旧 U48 可选的安排。 |
| R14 | 触觉面只留主阵列窗、U48 窗、SW1、SW2；紧固件全部从底面进出。 | C20，807 行：“上表面（触觉面）上不许有螺钉头、螺母六角窝”，原因是“拇指就在阵列附近滑动”。 |
| R15 | PB503 放在壳里，接在板后，避开手握位置。 | C20，10 行指定绿联 PB503；U20：“充电宝不要放在手握的位置。J1（USB 口）在板子最后，所以充电宝只能接在板子后面。” |
| R16 | 用 PB503 自带 C 公头直插 J1；对不上才用尽量短的现成 PD、3A 公对母延长线。 | C20，807 行要求撤掉 25 cm 双弯头线，备用线提供可买出处和插头包络。取代初始任务中允许 AI 自选直插或 C-C 线的安排。 |
| R17 | PB 侧面 C 口从壳外充电，不拆壳、不拔供电接头，开口平齐。 | C20，10、807 行；后一次明确取消侧面外凸护罩和“拔线再充”的操作。 |
| R18 | PB 原电源键从外面能按到，并能长按三秒。 | C20，10 行第 3 点，说明演示前长按三秒开小电流模式。 |
| R19 | 新版 SW1、SW2 都能从壳外操作。 | C20，10 行第 4 点，取代 C10，308 行“轻触开关现在没用，放着就行”的旧安排。 |
| R20 | ESP 为插在 8.5 mm 排母上的 IPEX 版；留远离模组、大铜面的 FPC 天线贴位，烧程序可开盖。 | C20，10 行第 5 点；L16，475 行另要求 ESP 的 USB 朝板尾、IPEX 端留插线空间。旧板载天线图仅供外形参考。 |
| R21 | H2C、PLA，好打印、支撑少。 | C20，10 行第 6 点及交付要求：摆好打印姿态的打印 3MF、含 PCB／模组／ESP／PB 参考体的装配 3MF。 |
| R22 | 整体尽量短小、外形一体，尾部平顺过渡，说明各段长度。 | C06，670 行先提“手柄需要尽量小一点”；C20，10、807 行要求压缩 287 mm 初稿的连接段与杖口空位。270 mm 是原壳比较值，未指定为新的绝对长度上限。 |
| R23 | 不确定尺寸集中参数化，保留来源和短测量清单，交付可再生成脚本及简短报告。 | C20，10 行点名模组插装高、IPEX ESP 外形、PB 公头／口键位置、打印间隙；要求报告整体尺寸、间隙、装配检查和打印朝向。 |
| R24 | 板上已有安装孔必须纳入外壳固定考虑。 | U20 明确指出现版没用两孔。L16，475 行早先接受过“两端各一个 M2 孔，阵列底下不打孔”；现存孔径推算与此不符，见 P28。 |

### 已被替代的旧要求

| 编号 | 当时要求与出处 | 后来怎样变化 |
|---|---|---|
| R25 | C10，308、388 行：两节 18650、独立保护板、无电池盒，PCB 位于电池上方；前深腔用于电池。 | C11，194 行已说“电池的位置其实也可以改”。C20 改为 PCB1_2＋壳内 PB503；U20 明确电源在板后。旧电芯和保护板的深腔退出当前方案。 |
| R26 | L11，549 行：“先考虑直接焊死，另外，板子高度现在不用细究”。 | 针对旧十五模组板；C20 已用 HX PM1.27-1x6P 排母和插装总高。旧直焊 20 mm 本体高须由新插装关系取代。 |

旧开关用途、窗口数量、供电连接选择和形态探索的替代关系，已分别放进 R19、R13、R16、R07，去重后不另计条数。

### AI 提案和参数，单独看待

[ENCLOSURE_BRIEF](Handle/ENCLOSURE_BRIEF.md) 的沿厚度提盖、短榫与独立螺钉、PCB 留在下壳，属于讨论提案。Coaxial_v1 的挂钩、M2.5×30、41.3×32.3 mm／128 mm 周长、保护板 24×19.5×7.6 mm 占位，以及当前版 ST2.9×25、板边托位／压指、泡棉、0.2／0.35 mm 间隙，都是 AI 的选型或假设。具体结构由 AI 决定的授权，与尺寸经过实物确认，是两件事。

## 二、每版出过的问题

### 旧问题、发现过程与后续处理

已修改的旧问题统一列在下表；最后一列同时保留经验有没有传下来的线索。未获认可、未解决的项目也注明现状。

| 编号／版本 | 具体错在哪、怎样发现（出处） | 后来怎样处理；经验留下了什么 |
|---|---|---|
| P01／10/06 压缩候选 | 外形不对称。C06，1294 行本人指出，1297 行 AI 承认。 | 两套候选于 1318 行确认删除。具体哪段偏了多少，模型已不在；R04 现明确保留外形对称要求。 |
| P02／原手柄 | 榫厚／突出 1／2 mm，槽宽／深同为 1／2 mm，余量为零。C10，308 行实物反馈“对不上”；ENCLOSURE_BRIEF、VERIFIED_FACTS 测量吻合。 | Redesign 改短榫每面 0.25 mm，v1 改止口，10/20 改定位柱。长滑槽问题已避开，实际配合仍需试合。 |
| P03／原手柄 | 2 mm 壁中开 1 mm 槽，槽两边各剩 0.5 mm；C10，308 行反馈脆弱易掰断。 | 后续取消长槽。经验是核对局部剩余料厚，而非只报普通壳壁厚；新短榫又出现 P15。 |
| P04／原盖＋PCB1_5 | 开关孔与模组窗相对距离差约 1.79 mm，对齐一边另一边就偏。L11，543、604 行按焊孔、模组图和盖截面查明；VERIFIED_FACTS 可复核 1.786 mm。 | v1 按焊盘重开窗和 SW1 孔，10/20 按新板重新定位。早先视觉阵列对窗没同时约束开关。 |
| P05／原件实拍 | 两侧 10 mm 窗的模组比中间 9 mm 窗歪，模组宽 8.2 mm；开关孔边有崩边。来源是 L11，543 行 Claude 的历史看图记录，原照片本次未重取。 | v1 改 8.9 mm 窗并加板固定；10/20 按新要求改大共窗。歪斜、崩边的实物修复验收查不到；窗口宽与歪斜的因果未证实。 |
| P06／原手柄 | 尾端止挡以上敞口约 42×33 mm，USB／拨杆又离尾口约 34–38 mm。L11 剖面审查及 549 行本人确认敞口并非有意。 | v1 缩尾、封口并单独开 USB／SW2 口；10/20 封尾并设置操作件。旧规划只说保留止挡，没识别上方缺壁。 |
| P07／原手柄 | 杖孔直通电池腔，无插入限位。L11，425、543 行与 VERIFIED_FACTS 的剖面记录。 | **v1 已有止挡**：`shape.py` 的 `X_BULK=-8` 注明止挡在 X=−10…−8；10/20 孔底 −6、内腔起点 −3.5，留 2.5 mm 实体。原整理稿漏掉的 v1 修改在此补正。 |
| P08／原件及早期研究 | 没落实 PCB 独立支撑／固定，只摆了显示位置。L11，543 行指出旧板一个 Ø2.2 孔、各早期壳缺托板结构；初步提案也列为待解决项。 | v1 加托台和六个压指；10/20 加三对托位／压指和端挡，但又排除了已有安装孔，见 P28。 |
| P09／原打印工程 | 上盖在打印盘上斜约 0.9°，顶面未贴平。VERIFIED_FACTS 根据原 3MF 构建变换确认。 | 后续重新摆盘；10/20 上下壳平面贴床。没找到由这 0.9° 单独造成的打印故障记录。 |
| P10／Redesign、GripStudy、Concepts | 按借来的排母占位中心找位置，PCB 横向偏 2.75 mm，旧 `T_PCB.Z=-4.146`。L11 按模组焊孔、SW1、ESP 排座和板框共同中线查出，VERIFIED_FACTS A/B 留证。 | v1 居中；10/20 按原生焊盘定位。几组研究共用错误变换，导致各自检查都沿用同一前提。 |
| P11／34/32 mm Redesign | 板移回正确位置后，前定位榫根部压板边。L11，454、543 行；VERIFIED_FACTS B；检查图 `08_34mm_front_key_vs_pcb.png`。 | 旧稿结论撤回，后改用 v1 新连接。旧 `review_constraints.json` 的间隙是在错误板位下算的。 |
| P12／32 mm Redesign | 为 C78/C79 在负 Z 做两处 1 mm 单侧鼓包，也基于错误板位。Redesign README／`build_redesign.py` 的旧解释与更正、VERIFIED_FACTS B 对照可见。 | 避让理由撤回，旧模型保留更正。P10 的共同坐标错误未先解决，局部补形反而固化了错前提。 |
| P13／早期装配研究 | 把模组顶面挪到盖面，却让模组悬在板上约 3.6 mm；若直焊，触面会低约 3.6 mm。L11，543 行。 | v1 按直焊把板顶设 Y=3.5、固定触面 Y=23.5；10/20 改用待测插装总高 24.30 mm，见 P30。 |
| P14／34/32 mm Redesign | 只收下部，上面仍宽 46 mm；完整外廓 46×35.5 mm，握持周长仅 159.8→153.3 mm，约减 4%。Redesign README、L11，543 行。 | v1 改完整截面与大圆角，报 41.3×32.3 mm、周长约 128 mm。10/20 又按远处电源统一定底，重复“没按握持段自己的需要收薄”的问题，见 P29。 |
| P15／Redesign 短榫 | 螺钉导孔上方只剩约 0.6 mm 料。L11，543 行的截面评审；Redesign 采用假设 M2×5、导孔 Ø1.6。 | v1 换连接；10/20 前柱最薄径向约 1.55 mm、导孔上方留 9.17 mm。长薄槽改短榫后，局部薄壁仍被漏过。 |
| P16／Redesign 打印文件 | 壳开口朝上立放，仅弧底接床，约 11,700 mm² 需支撑。L11，543 行、VERIFIED_FACTS B。 | v1 比较方向后仍用尾面朝下、238 mm 高竖打，需 brim／支撑；10/20 才改长壳平放、杖孔分半。早期只完成导入排版。 |
| P17／GripStudy 前期 | 左手当右手。C11，1455、1526、1598 行本人纠正，1519 行 AI 仍否认，1604、1613 行终于承认成品用了左手。 | 1620 行授权后整体镜像皮肤、骨架、指甲；Concepts README／GripStudy 记录来源左手。检查须看成品，文件名 `AdultRightHand` 曾误导判断。 |
| P18／GripStudy 前期 | 掌心铺在盖上、拇指横过柄、四指只勾对边。C11，1011 行本人否定；1076、1111 行 AI 承认。1262 行又发现中指、无名指中段悬空。 | 改侧掌、拇指沿长轴、四指包下方，并调整关节；后续仍有 P19。先按几个触点贴壳，没先摆出完整包握。 |
| P19／Concepts A/B | A 掌托弱、拇指根交叠约 1.46 mm；B 食指根约 1.72 mm。Concepts README 及 `hand_studies/*/actual_shell_audit.json`；C11，3210、3232 行承认带问题交出。 | C 静态整手未检出重叠；A/B 没查到最终消除版。后续试做 Reform。连通、硬件占位和手壳接触的检查没有一起决定交付。 |
| P20／Concepts | 先拼长电路盒和独立握杆，整体过大。C11，3232 行 AI 承认“主要是在转盒子、换杆方向”；L11，543 行报 A/B 约 226×200×83 mm、实心塑料折算约 360 g，原件约 107 g。 | 当时获准探索，后来 L11，549 行明确选回同轴；未见 A/B 收敛成产品。窄握杆没有解决整根手柄的体积和形态。 |
| P21／Concepts | 未落实打印分件、接缝、紧固及完整装配。Concepts README 第 50–51 行明确未包含最终紧固、保护板、布线、ESP 本体及插装保证；只检查外形连通和占位。 | 后续 v1、10/20 才补分件、固定和装配结构。这一轮的工作范围本就是探索，遗留物只能作为概念参考。 |
| P22／Reform | 局部补形、接触和包覆反复改后，整体仍被拒。C11，3386 行重做掌托，3658 行发现板鼻外露并补包覆，3843 行报完成，3854 行本人要求全删。 | 当前 Reform 成品已不在；最终具体哪处还错，查不到。能确认局部检查没解决整体形态，删除前的完成汇报没有成为认可结果。 |
| P23／Coaxial_v1 | 沿用 Ø25 孔、1.5 mm 杖口壁厚，README 自述承弯强度偏弱、本版未改。属于设计风险，无实物断裂记录。 | 10/20 增厚前段并加止挡、底面紧定，承力仍待实物验证。孔径固定与外壁加固应分别处理。 |
| P24／10/20 初稿 | 触觉面前后四五个螺母六角窝妨碍拇指滑动。C20，807 行本人看图与脚本后指出。 | 改底面 ST2.9 螺钉和上壳盲孔；运动结果中额外触觉面缺口体积为 0、孔底至顶面约 9.17 mm。v1 已避开握持面紧固件，这个经验到初稿未落实，随后才形成 R14。 |
| P25／10/20 初稿 | 25 cm 双弯头线在板下绕圈，占空间。C20，807 行撤回。 | 改 PB 自带公头直插，PB 本体起点 X=136.705；备用短延长线需要重新安排连接段。初始允许 AI 自选连接，但没有先选紧凑排列。 |
| P26／10/20 初稿 | 侧面外凸护罩，并需拔供电线再充电。C20，807 行明确否决。 | 改侧母口专充电、壳口平齐 16×10 mm，尾段连续加宽过渡。供电和充电口最初没有分清安排。 |
| P27／10/20 初稿 | 总长 287 mm，比原 270 mm 还长；连接与杖口段有空长。C20，807 行要求缩短、列各段长度。 | 当前壳长 259.705 mm、含按帽 260.305 mm；五段为 34／135.890／0.815／79／10 mm。旧 v1 已删过 38 mm 尾空段，新稿仍未先按实际占用算各段。 |

表中“为何漏掉”来自会话自述或文件之间可见的依赖；没有记录的动机不补写。历史照片观察 P05 未在本次重新核图；数字薄壁、重量折算和碰撞结果保留其原证据类型。

### P28｜10/20 当前版：绕过了已有安装孔，孔径记录还存在冲突

**违反 R24。** 当前 README 明写“新增两孔不用作支撑”“不用新增 0.6 mm 孔承重”；`build.py` 第 176 行也写 `no reliance on the new 0.6 mm holes`。PCB 仅靠 X=`[4.0,55.0,132.4]` 的三对板边托位／压指和端挡定位。装配参考板仍是未含新孔的 STEP，外壳没有按两孔中心做配合。

原始差异证据保存的两孔为孔层 `FILL`，其 `path` 是 `CIRCLE`：

| ID | 原始 path | 按当前平移后的孔中心／mm | 中心至板边 |
|---|---|---|---|
| `8a08118428949267` | `['CIRCLE', -5010, -1095, 23.622]` | `(1.143, 15.240)` | 约 1.1 mm |
| `845a3a28dd9fe12d` | `['CIRCLE', 235, -2290, 23.622]` | `(134.366, −15.113)` | 约 1.3 mm |

来源：[live-check-evidence.json](../.pcba-workflow/pcb1_2-recheck-20261018/live-check-evidence.json)。坐标按 mil×0.0254，再加当前脚本平移 `(128.397,43.053)`；板包络为 X=0…135.890、Y≈±16.383 mm。上表边距是孔中心到最近板边的距离。

**孔径推断：**按嘉立创 EDA 专业版 `CIRCLE` 格式，第三个数值参数 `23.622 mil` 是半径，换算约 0.600 mm，因此孔径约 **1.200 mm**。README 的“0.6 mm 孔”把该数当成了孔径。按这个推断，两孔孔边到最近板边约剩 0.5–0.7 mm。

**需要 Hsinlung 在 EDA 确认：实际孔径，以及它是否符合原来的安装意图。** L16，475 行本人早先接受“两端各一个 M2 孔，阵列底下不打孔”，与推算 Ø1.2 mm 对不上。本文记录冲突，保留板和壳原样。

经验没用上的直接证据是：制作时知道新增孔，仍在实现中明确排除它们，没有把孔位、孔径与原固定意图一起核对。

### P29｜10/20 当前版：握持段按充电宝底面定高，多撑厚约 2.47 mm

**违反 R02，重复 P14 的握持收窄问题。** 充电宝已放在板后，但它的底面仍决定了前方握持段的高度。

当前 `build.py` 第 47–52 行的计算是：

```text
FACE = PCB_TOP + MODULE_SEATED_HEIGHT = 2.204 + 24.30 = 26.504
PB_Z = 3.334，PB_THICKNESS = 26.5，PB_CLEAR = 0.65，WALL = 2.4
PB 所需外底面 = 3.334 − 26.5/2 − 0.65 − 2.4 = −12.966
AXIS = (FACE + PB 所需外底面)/2 = 6.769
BOTTOM = 2*AXIS − FACE = −12.966
```

`tube_envelope()` 在握持段、X=105、PB 段和尾端共用 `BOTTOM/FACE`。于是 [verification.json](Handle_NewPCB_2026-10-20/models/verification.json) 报握持段 **39.266×39.470 mm**、尾段 **56.538×39.470 mm**，两段一样高。

回读 `models/pcb_parts.npz` 及索引，板底最低器件是 **C76，底 Z=−7.750 mm**，在当前坐标 X≈82.714…90.514 mm。按同样普通间隙 0.35 mm、壳壁 2.4 mm比较：

```text
握持段本地最低器件所需外底面 = −7.750 − 0.350 − 2.400 = −10.500 mm
当前底面多下探 = −10.500 − (−12.966) = 2.466 mm，约 2.47 mm
```

因此，“握持段尽量窄”没有落实到本段硬件包络：脚本直接让远处充电宝决定了整段底面。Coaxial_v1 已有分段收底，`shape.py` 的 `YBOT` 从电池段 −22.3 收到握持段 −8.79，再到尾部 −15.0；10/20 没沿用这种按段处理。两版坐标轴不同，比较的是分段方法，非照抄旧尺寸。

**能收到多少还要重核同轴、螺柱、按钮和装配约束。** 这不改变当前把充电宝所需高度带到握持段、违反收窄要求的结论。

### P30｜多版重复：自检通过，但没查到真正要解决的问题

旧 Redesign／GripStudy 在错误板位下得到零相交或正间隙，板移正后榫根才压板；手能活动、几处贴壳，也没挡住左右手错、掌根悬空和穿模。来源见 P10–P19，以及 `GripStudy/review_constraints.json`、`articulation_check.json`、Concepts 的手壳审查文件。共同遗漏是检查的前提、对象和最终握持目标没一起核对。

10/20 当前仍有以下具体缺项：

| 缺项 | 文件、参数与现状 |
|---|---|
| 没留下本版握位和扫读核对 | README、`build.py`／`verify.py`、静态／运动结果检查硬件、按杆、滑块、拆盖和插头；未查到本版手模或真人握持范围、掌根止挡接触、拇指扫完整阵列的结果。R03、R11 尚缺判断依据。 |
| 接口位置由假定公式自洽 | `PB_Y=J1_Y−PB_PLUG_OFFSET_Y`、`PB_Z=J1_Z−PB_PLUG_OFFSET_Z`，随后检查公头轴线等于 J1。偏心默认 0、伸出 7／插入 6 mm，验证的仍是同一组假定。PB 侧口距前端 12 mm、尾键位置也待实测。 |
| 实装高度待确认 | `FACE=PCB_TOP+MODULE_SEATED_HEIGHT` 后报告固定顶面等于盖面；`MODULE_SEATED_HEIGHT=24.30`、IPEX ESP 外形均待实物核对。 |
| 原生切片未完成 | 当前 README 记 Bambu CLI 返回 −6、旧 3MF 对照未完成、GUI 被自动审批拒绝；已完成的是标准 3MF 重读。 |
| 打印配合及承力未闭合 | 自攻底孔、热熔螺母底孔、定位柱、按杆／滑块配合、杖口受弯与反复拆装尚无实打结果。v1 也遗留保护板实际尺寸、绝缘／接线固定、SW1 露出高度等旧未决项。 |

当前 README 已把多数参数标为待测，问题是这些缺口尚未补上。零碰撞只覆盖输入包络和检查姿态，以上项目须分别取得对应证据。

## 最后对照：10/20 当前版还违反什么

| 当前违反项 | 对应需求、旧问题 | 可追到的证据 |
|---|---|---|
| **安装孔未纳入固定。** | R24；P08→P28 | `build.py:176–185` 的板边托位／压指和排除小孔的注释；README 的“不用”；孔中心及 Ø1.2 mm 推断详见 P28。 |
| **握持段被尾部充电宝撑厚。** | R02；P14→P29 | `AXIS/BOTTOM` 按 PB 底面计算；当前底面 −12.966，而本段 C76 按同样间隙／壁厚所需约 −10.500，多约 2.47 mm；v1 曾有分段收底。 |

**合计 2 条违反。需要 Hsinlung 确认的是孔径和原 M2 安装意图。** P30 另列握持、接口、配合和打印验证缺项。

充电宝本体 X=136.705…215.705，PCB 尾 X=135.890，已在板后；其与手掌的关系归入 P30。当天初稿的顶面孔窝、长线回环、护罩和 287 mm 长度已修改，处理结果统一保留在上表 P24–P27。当前同轴、Ø25 内孔、封尾、按新板焊盘定位、主阵列与 U48 分窗、底面紧固和外部操作机构均已进入模型；下次应继续处理上述两项违反及明确的验证缺口。
