Cheerssom/LingTouchCompanion/(list of files, drawings)

Other design files:
hardware/models/3mf/Handle/Coaxial_v1/cache/pcb_parts.json
hardware/models/3mf/Handle_NewPCB_2026-10-20/models/pcb_parts.json
hardware/pcb/PCB_REDESIGN_2026-10-08/Revised_Schematic.epro
