Cheerssom/LingTouchCompanion/(commit log)

2026-10-27 交接手柄外壳现状，供云端 Claude Code 接续修改
    [Handle_Assembly.3mf, Handle_Print_H2C.3mf, h2c_machine.json, pcb_parts.json]
2026-10-27 Add real-size twist-key tenon test coupon
    Hourglass tenon in a slot blind at the far side; a flat key inserted
    upright through the mouth and turned 90 degrees stops the tenon backing
    out. Includes two tenon clearances (0.2 / 0.1 mm per face), assembly and
    lock checks, and a support-free print layout.
    Claude-Session: https://claude.ai/code/session_013PZTDqQcpcjmkSmuYG6pND
    [Tenon_Test.3mf]
2026-10-28 Add twist-key detent test coupon (ridged keys, recess grooves)
    Key gets two small ridges under the knob ends and clamps the lip; the tray
    and cover blocks get four shallow grooves at the locked and upright angles.
    Two keys (ridge 0.10 / 0.15) for comparison; the 0.1 mm tenon is reused.
    Records Hsinlung's 10/28 test feedback in the handoff.
    Claude-Session: https://claude.ai/code/session_013PZTDnZ3VibEqX3CcjYb3A
    [Key_Detent_Test.3mf]
2026-10-28 交接：仓库按人重构与端侧工程骨架（含 CS30 协议材料与两份方案）
2026-10-28 按人重构仓库（只移动，不改内容）
    本提交只有 git mv，316 个文件全部是 100% 相同内容的重命名，引用修复在下一个提交。
    - perception/cs30/ ← handoff_2026-10-28/cs30_protocol/
    - docs/plans/ ← handoff_2026-10-28/plans/、HANDOFF_2026-10-28.md、lingtouch.md
    - agent/backend/ ← app/backend/
    - hardware/firmware/ ← firmware/
    - hardware/models/ ← 3mf/、BrailleModule/、BrailleModule_Video/（三个目录同级保留）
    - hardware/pcb/PCB_REDESIGN_2026-10-08/ ← PCB_REDESIGN_2026-10-08/
    - hardware/headset/ ← glass.md
    - hardware/tools/ ← ble_mobile_controller.html、ble_testbench.html
    - e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
    [3D_PCB1_5_2026-09-15.step, 3D_PCB1_5_2026-09-15_no_U31-U45_U48_headers.step, AppearanceStudy.blend, BrailleModule.blend, BrailleModule.step, EnclosedArray.blend, Front_CS30_Mount_Final.3mf, Front_CS30_Mount_Print.3mf]
2026-10-28 修复移动后的引用（链接、import、仓库根路径、.gitignore）
    只改因移动而失效的引用，不改功能。根目录 README 在后面的文档提交里整篇重写，这里不动。
    - 新增 experiments/chi2027/visionss/repo_paths.py：先看环境变量 LINGTOUCH_ROOT，
    否则向上找含 .git 的目录。Depth-Anything-V2/、pics/、experiment_runs/ 留在
    本机仓库根，不再靠"往上几层"定位：
    depth_runner.py、experiment_server.py、evaluate_obstacle_scenes.py、
    validate_distance.py、check_balloon_depth.py、prep_new_pics.py
    （后三个原来按当前目录找 pics/，现在按仓库根）
    - experiment_server.py 找同级 single_point/ 仍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
2026-10-28 交接更正：鸿蒙等时传输要求 API 18，不是 16
    usbSubmitTransfer、UsbDataTransferParams、UsbEndpointTransferType 在 OpenHarmony
    usbManager 文档（docs 仓库 master，apis-basic-services-kit/js-apis-usbManager.md）
    里都标为 18+。交接里的"API 16 / 5.0.4(16)"改为"API 18 / 5.1.0(18)"，并在原句后注明更正。
    Hsinlung 已确认按 API 18 走。
    Claude-Session: https://claude.ai/code/session_013PZTDpY4GQ11Z8pFGrKuPb
2026-10-28 新增本机迁移脚本：合并后把被忽略的本机文件挪到新位置
    docs/migrate_local_2026-10-28.ps1（Windows PowerShell 5.1 / 7 均可，UTF-8 带 BOM）：
    - 按 2026-10-28 的移动表，把旧目录里剩下的（被 Git 忽略的）文件逐项挪到新目录：
    3mf\.runtime、geometry/checks/views、Medium_Trial_Registered.npz、
    BrailleModule_Video\Archives、agent 后端 .env 与 node_modules、实验服务证书、data\ 等
    - 只移动，不删除，不覆盖；旧位置不存在就跳过；新位置已有同名项就跳过并列出；
    每一步都打印；-DryRun 只打印不执行
    - 仓库根的 .pcba-workflow 不动，在 hardware\models\ 下用 mklink /J 建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
2026-10-28 端侧骨架：C++17 核心（类型、接口、旧板编码、CS30 拆帧与启动表、几何与 0/1/2）+ 主机测试
    core/（大家共用）
    - types.h：深度帧（时间戳、内参版本）、9×6 栅格（0/1/2、每格诊断）、地面估计
    - modules.h：按视觉方案第 9 节命名的接口（SensorAdapter、Registration、GroundPose、
    GeometryGrid、RGBInstance、SpatialLMService、EvidenceFusion、OutputAdapter/TactileEncoder）；
    inference.h：推理后端与大模型接口。未实现的只有接口，没有假实现
    - tactile.h：旧板编码（FFE0/FFE1/FFE3、15 字节），9×6 放进 10×9 最近 6 行；
    状态 2 的表示方式必须显式传入（数值 0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
2026-10-28 进行中：安卓外壳（native 部分与 Kotlin 主体，尚缺 Gradle/Manifest/资源）
    为避免容器回收丢失而先提交，后续提交补齐：
    - perception/native/third_party/libusb：上游 libusb 1.0.29（LGPL-2.1）Linux/Android 后端原样摘取，编成独立 libusb-1.0.so
    - perception/native/cs30_libusb：fd 包装、按启动表执行、10 个等时传输、停流顺序
    - core/report_json：栅格与统计的 JSON，安卓/鸿蒙共用
    - apps/android/app/src/main/cpp：JNI 桥（主机编译器 + JDK jni.h 编译、链接通过）
    - apps/android/.../*.kt：NativeCore、HandleLink（BLE）、StreamService（前台服务）、MainActivity；未编译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
2026-10-28 安卓外壳收尾：Gradle 工程、Manifest、资源、README；修正发送/复位按钮的空值判断
    - AGP 8.7.3 / Kotlin 2.0.21 / Gradle 8.11.1（wrapper），minSdk 29、targetSdk 35、arm64-v8a，
    externalNativeBuild 指向 app/src/main/cpp/CMakeLists.txt（编入 core 与 libusb-1.0.so）
    - Manifest：USB host、CAMERA（UVC 授权需要）、BLE 权限、connectedDevice 前台服务、WAKE_LOCK，
    插入 2207:0016 时拉起应用
    - MainActivity：`service?.sendLatest() ?: "…"` 会把发送成功（null）误报为“服务还没启动”，复位按钮同样，已改
    检查：Kotlin 以 Robolectric android-all:14（API 34 框架类）为依赖编译通过，无警告；
    nat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
2026-10-28 端侧骨架：鸿蒙外壳（ArkTS，usbSubmitTransfer 收包 → Node-API 按批交核心 → 栅格 → BLE 写帧，长时任务）
    - build-profile.json5：compatibleSdkVersion / targetSdkVersion = 5.1.0(18)
    - usb/Cs30Usb.ets：主路径按核心给的启动表执行控制请求、切换接口，接口 1 切到 alt 1 后立刻挂
    10 个 usbSubmitTransfer 等时传输，每个回调把 32 个微帧一次交给 core.pushIsoTransfer；
    备选路径 getFileDescriptor → core.openFd（native libusb_wrap_sys_device，与安卓同一流程）
    - device/HandleLink.ets：取自 9/29 比赛版，FFE0/FFE1/FFE3，一次只发一帧
    - common/KeepAlive.ets + module.json5：长时任务 bluetoothI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
2026-10-28 真机验收支持：栅格摘要、保存当前帧、核对帧文件（核心、主机工具、安卓、鸿蒙）
    真机清单第 1 条要把手机上的原始帧拿到电脑上和厂家 SDK 的帧比，第 3 条要两边喂同一帧、
    栅格完全一致，原来两个 App 都做不到：
    - report_json：grid_digest（FNV-1a 64，覆盖状态、54 格、每格诊断、各阶段计数、地面法线与高度的二进制位），
    栅格 JSON 带 digest；lt_frame_tool 也打印同一摘要
    - Engine::save_latest_frame（614400 字节，与 reference_*.bin 同格式）、
    Engine::process_frame_file（独立流水线同步计算，不影响后台）
    - 安卓：「保存当前帧」「核对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
2026-10-28 文档：重写 README（布局、归属、入口），新 CLAUDE.md（只留环境说明），真机验收清单，各文件夹 README
    - README.md：每个文件夹归谁、各入口、本机数据与迁移脚本
    - CLAUDE.md：只留仍有效的环境说明（Python 环境、建模运行时新位置、本机数据、核心编译命令）；
    旧 10/09 审阅内容已在 archive/CLAUDE_2026-10-09.md
    - docs/device_tests.md：交接的 6 条，加深度含义/去畸变的平面检查；安卓与鸿蒙两条取流路径都测；
    第 1 条说明手机上做不到“同一次曝光哈希一致”，改为先后两次曝光比对（perception/cs30/compare_frames.py）
    - perception/、perception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
2026-10-28 报告：docs/REPORT_2026-10-28.md
    做了什么、每个提交、跑过的测试与结果、没验证的清单、标定与深度含义（实测/计算/推断分开）、
    对交接里“Claude 判断的”改动与补充及理由、待 Hsinlung 决定的事项。
    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
2026-10-28 Integrate local sources and ignore machine-only working data
    Preserve local handoff entries under the new layout, retain reusable handle and JSON playback sources, and remove rejected render artifacts. Ignore local PCB workflow and skill data plus transient playback outputs. Normalize the legacy-vector source checksum across Windows line endings.
    [AdultRightHand.blend, EmmaLieker_Hand.blend, EnclosedArray.blend, lingchu_json_frames.csv, net-rule-assignment.csv, pcb_parts.json]
