Cheerssom/LingTouchCompanion/(notices)

Notices in the files:
hardware/models/3mf/Handle/GripStudy/inputs/EmmaLieker_README.md:
License: CC BY-NC 4.0
